craigyjp/A_Bit_More/README.md

## Based on the the original Crumar Bit series synthesizers I had created an RP2040 based DCO synthesizer. 

## Unfortunately the project did not work out too well as the DCO's were noisy and the PWM and triangle sounded atrocious.

## So a new synth is born with the same controller, new displays and the same filters, but now each RP2040 autotunes a pair of AS3340 VCO's

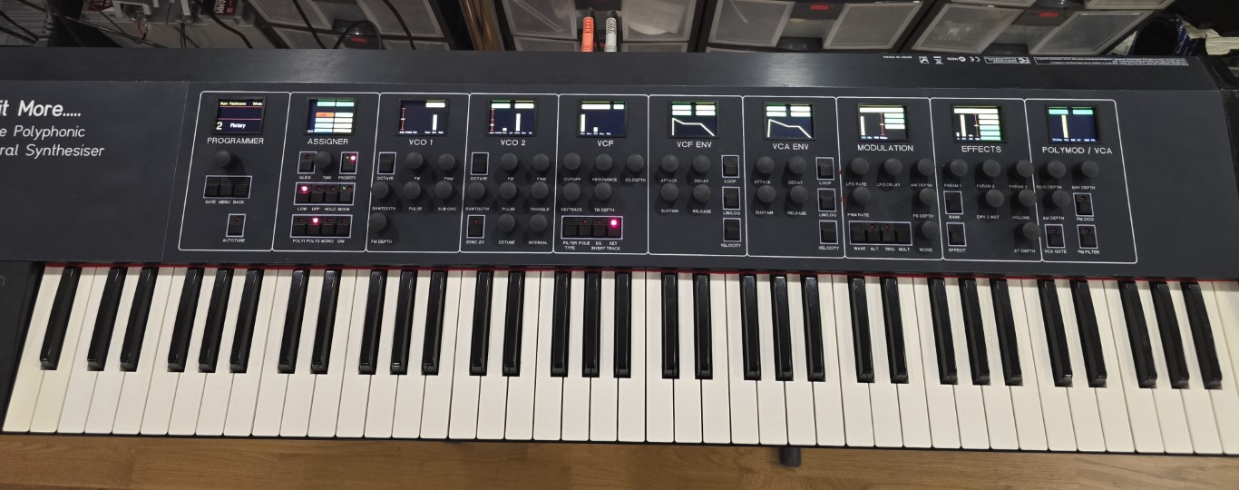
[picture p1: Photos/synth.jpg]
Synth


This is an 8 voice bi-timbral polyphonic dual VCO based synthesizer that uses an RP2040 to autotune and control a pair of AS3340 VCO chips.

I have also added portamento, octave switching, oscillator sync etc.

Filters are based on the Matrix 12 pole switching filters with 16 filter types available, dual LFO's are available for modulation and PWM, plus a white/pink noise source.

The case and keybed are a CME UF-70 Classic (black) and I've only kept the main MIDI board and grounded the pots/slider inputs.

# Although I have this repository the schematics are far from complete and some code is still required.

# Things to fix 

* Add chord hold in wholemode only.
* Add MIDI out/thru.
* Fix bug in lower unison/mono mode last note priority.
* Add sustain from pedal A (CC 64).
