craigyjp/A_Bit_More/Schematics/Programmer.pdf

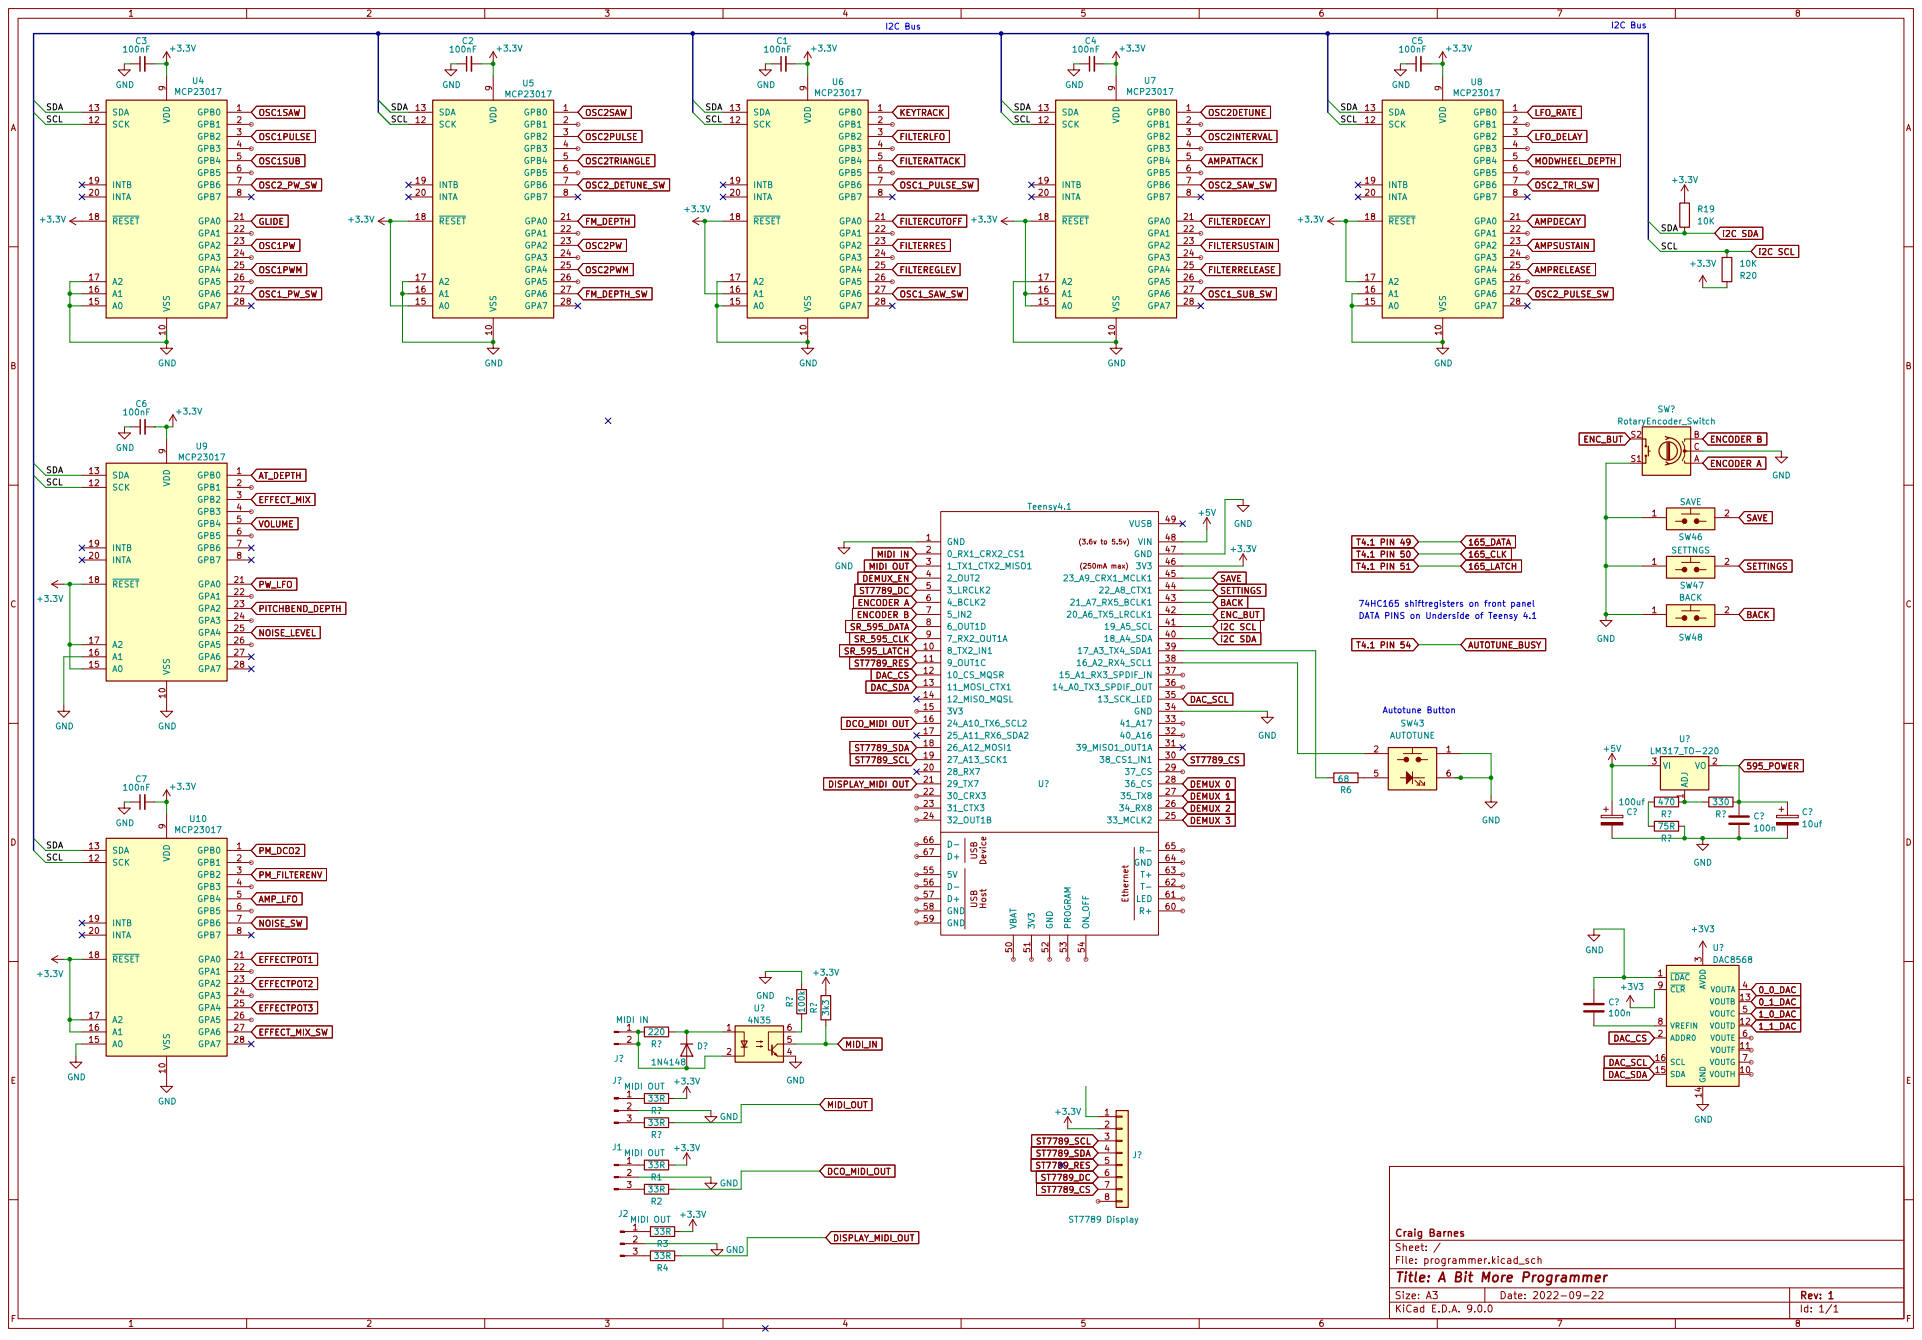
[picture p2: page 1]
