craigyjp/A_Bit_More/Schematics/Programmer4.pdf

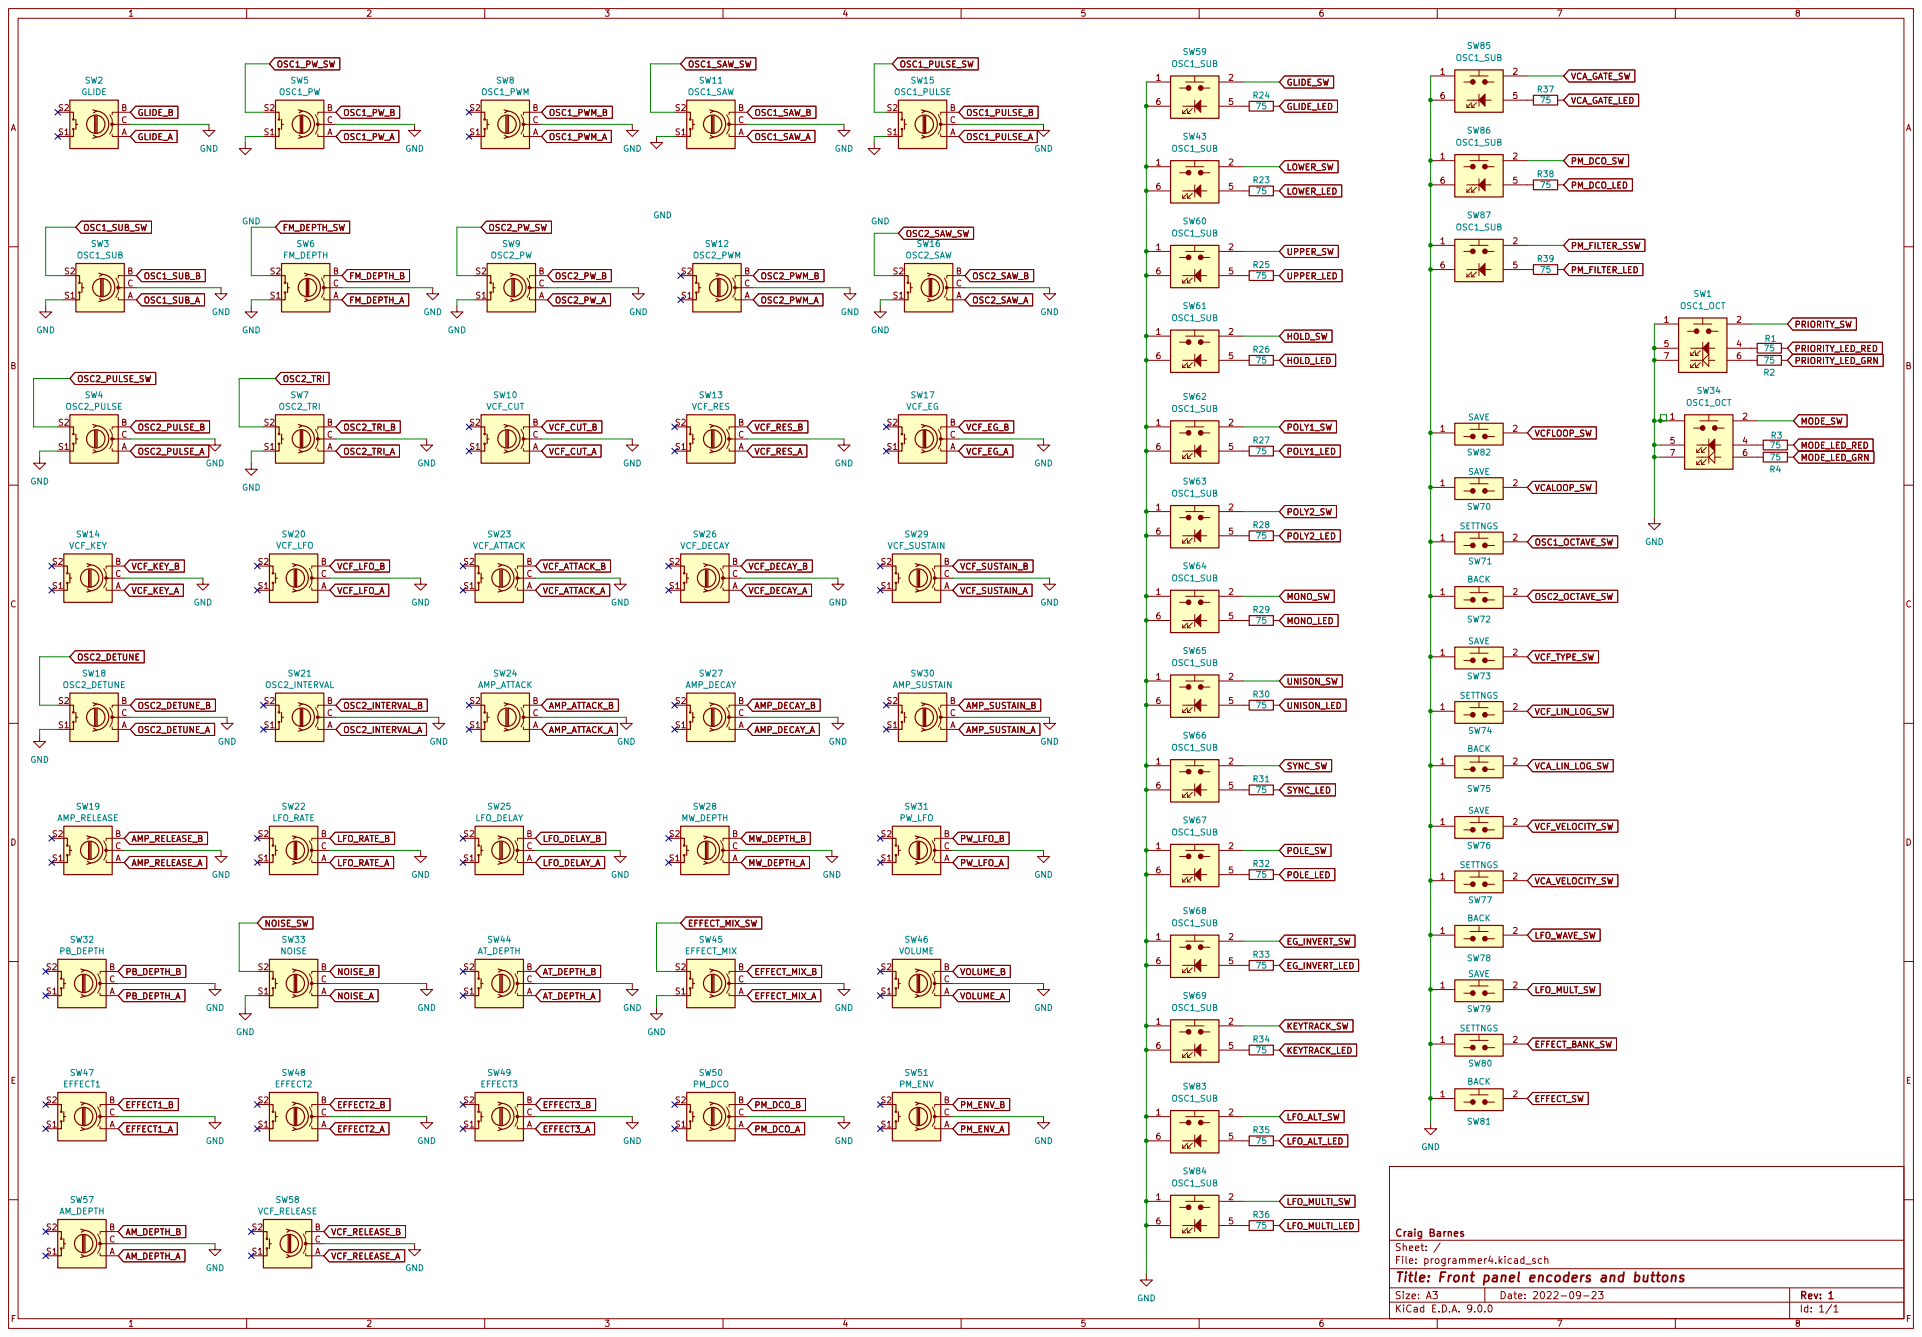
[picture p3: page 1]
