craigyjp/A_Bit_More/Schematics/AS3340_VCO.pdf

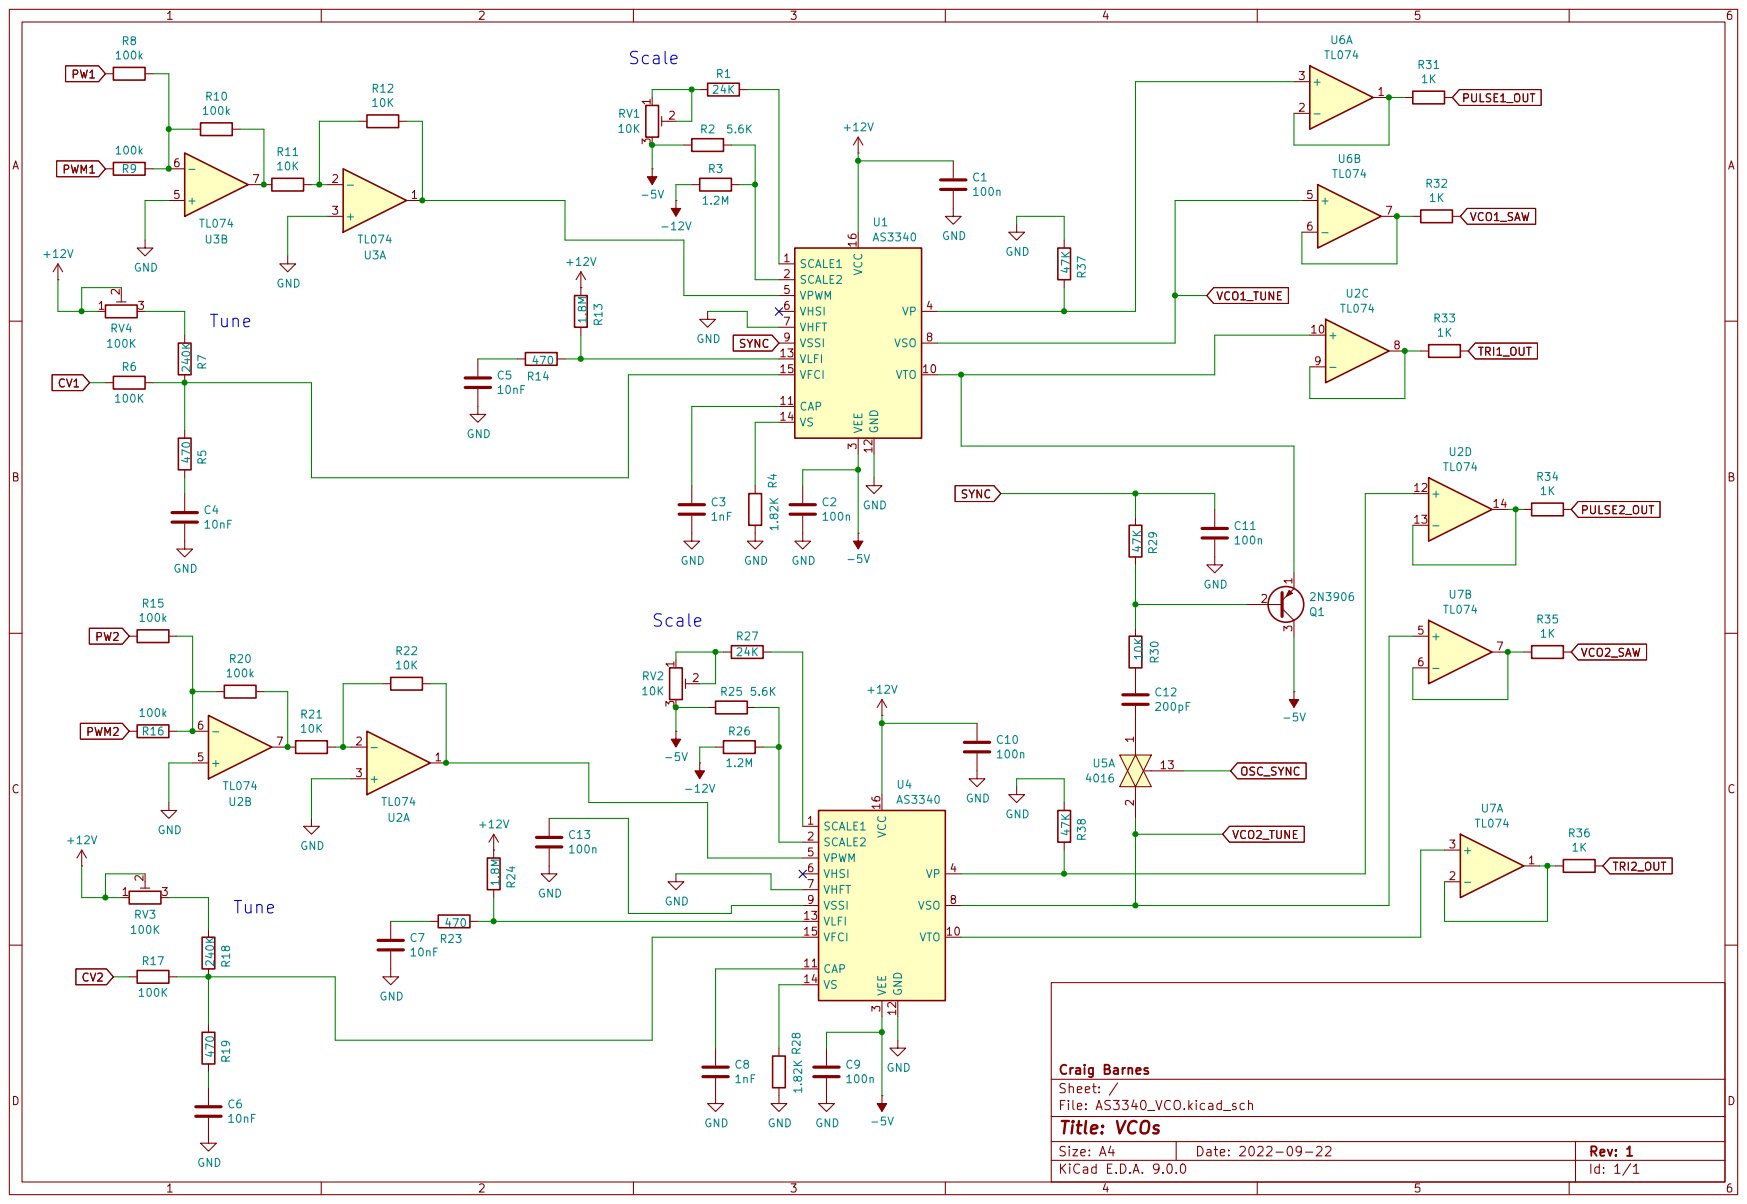
[picture p4: page 1]
