craigyjp/A_Bit_More/Schematics/Zero_VCO_control.pdf

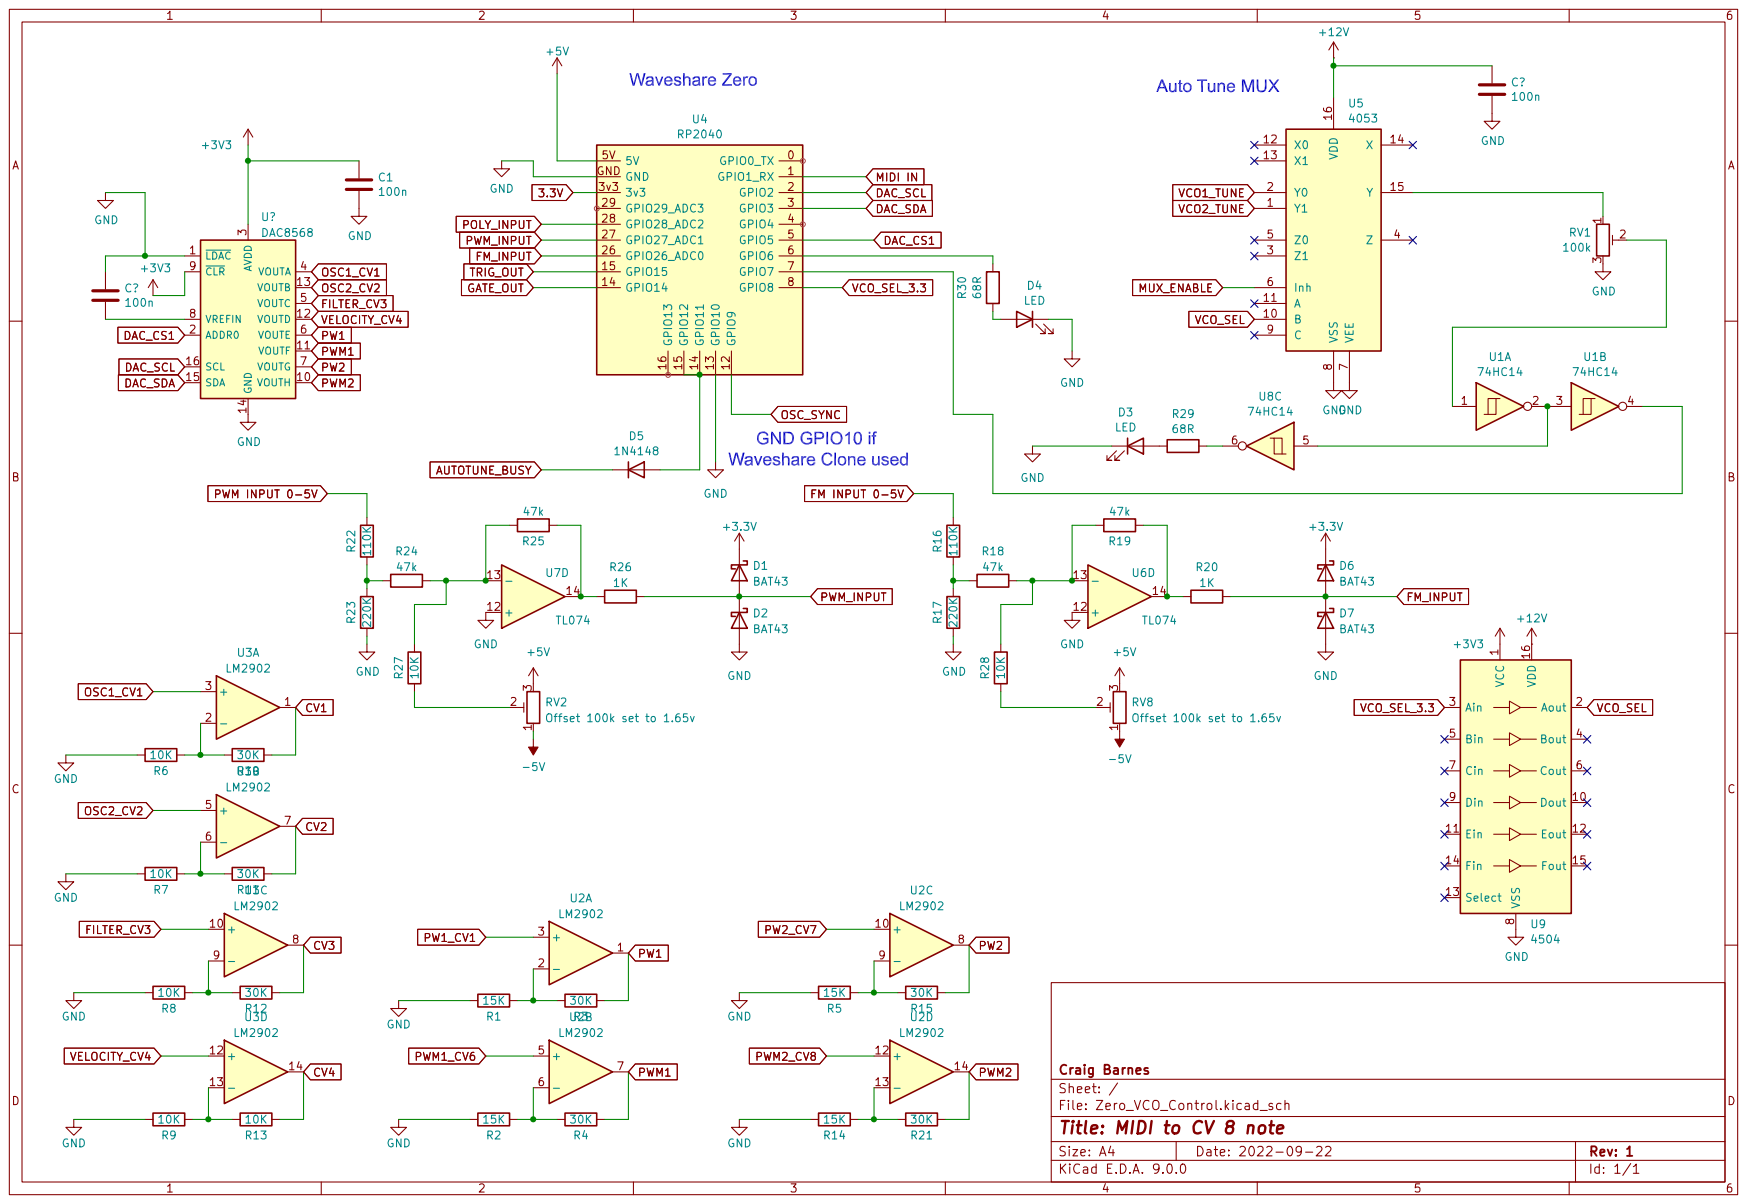
[picture p5: page 1]
