craigyjp/A_Bit_More/Schematics/Displays.pdf

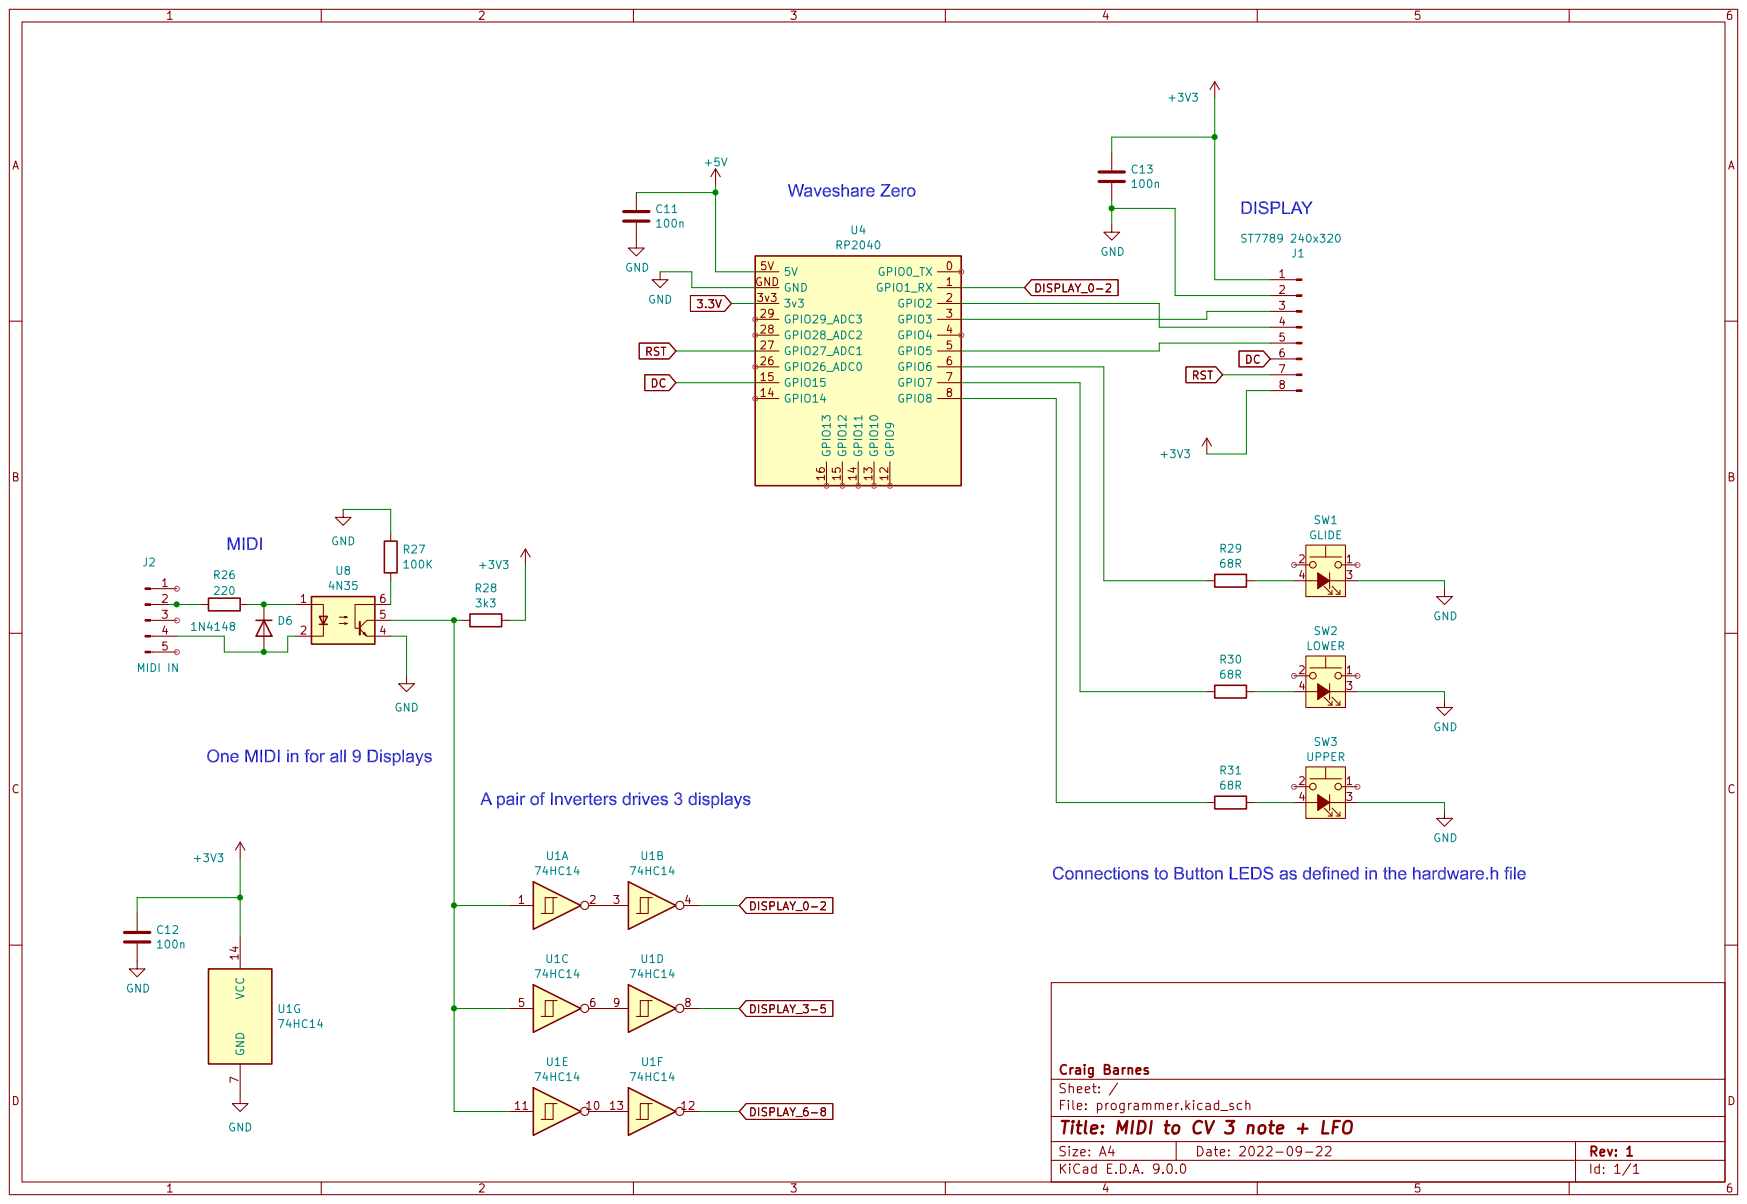
[picture p6: page 1]
