craigyjp/A_Bit_More/Schematics/Filter_control.pdf

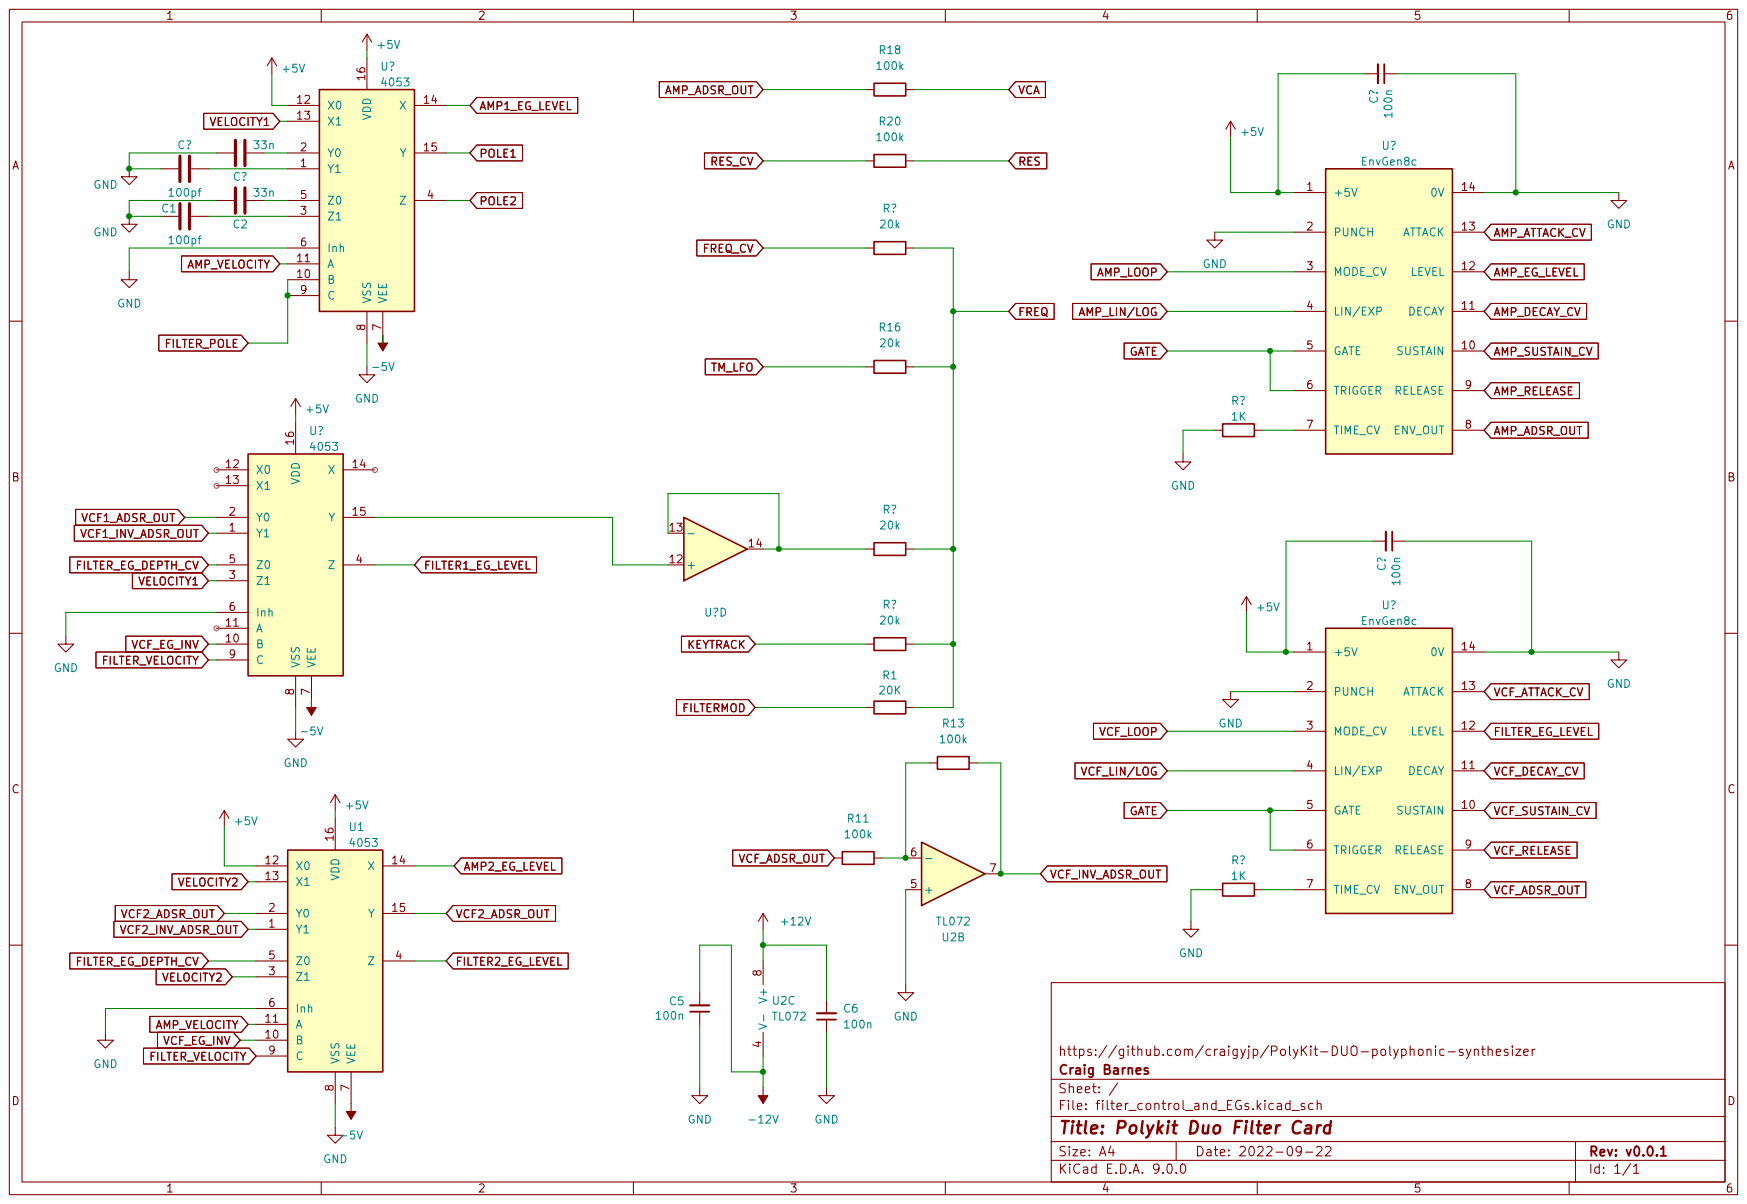
[picture p7: page 1]
