craigyjp/A_Bit_More/Schematics/Final_VCA_AM_Volume.pdf

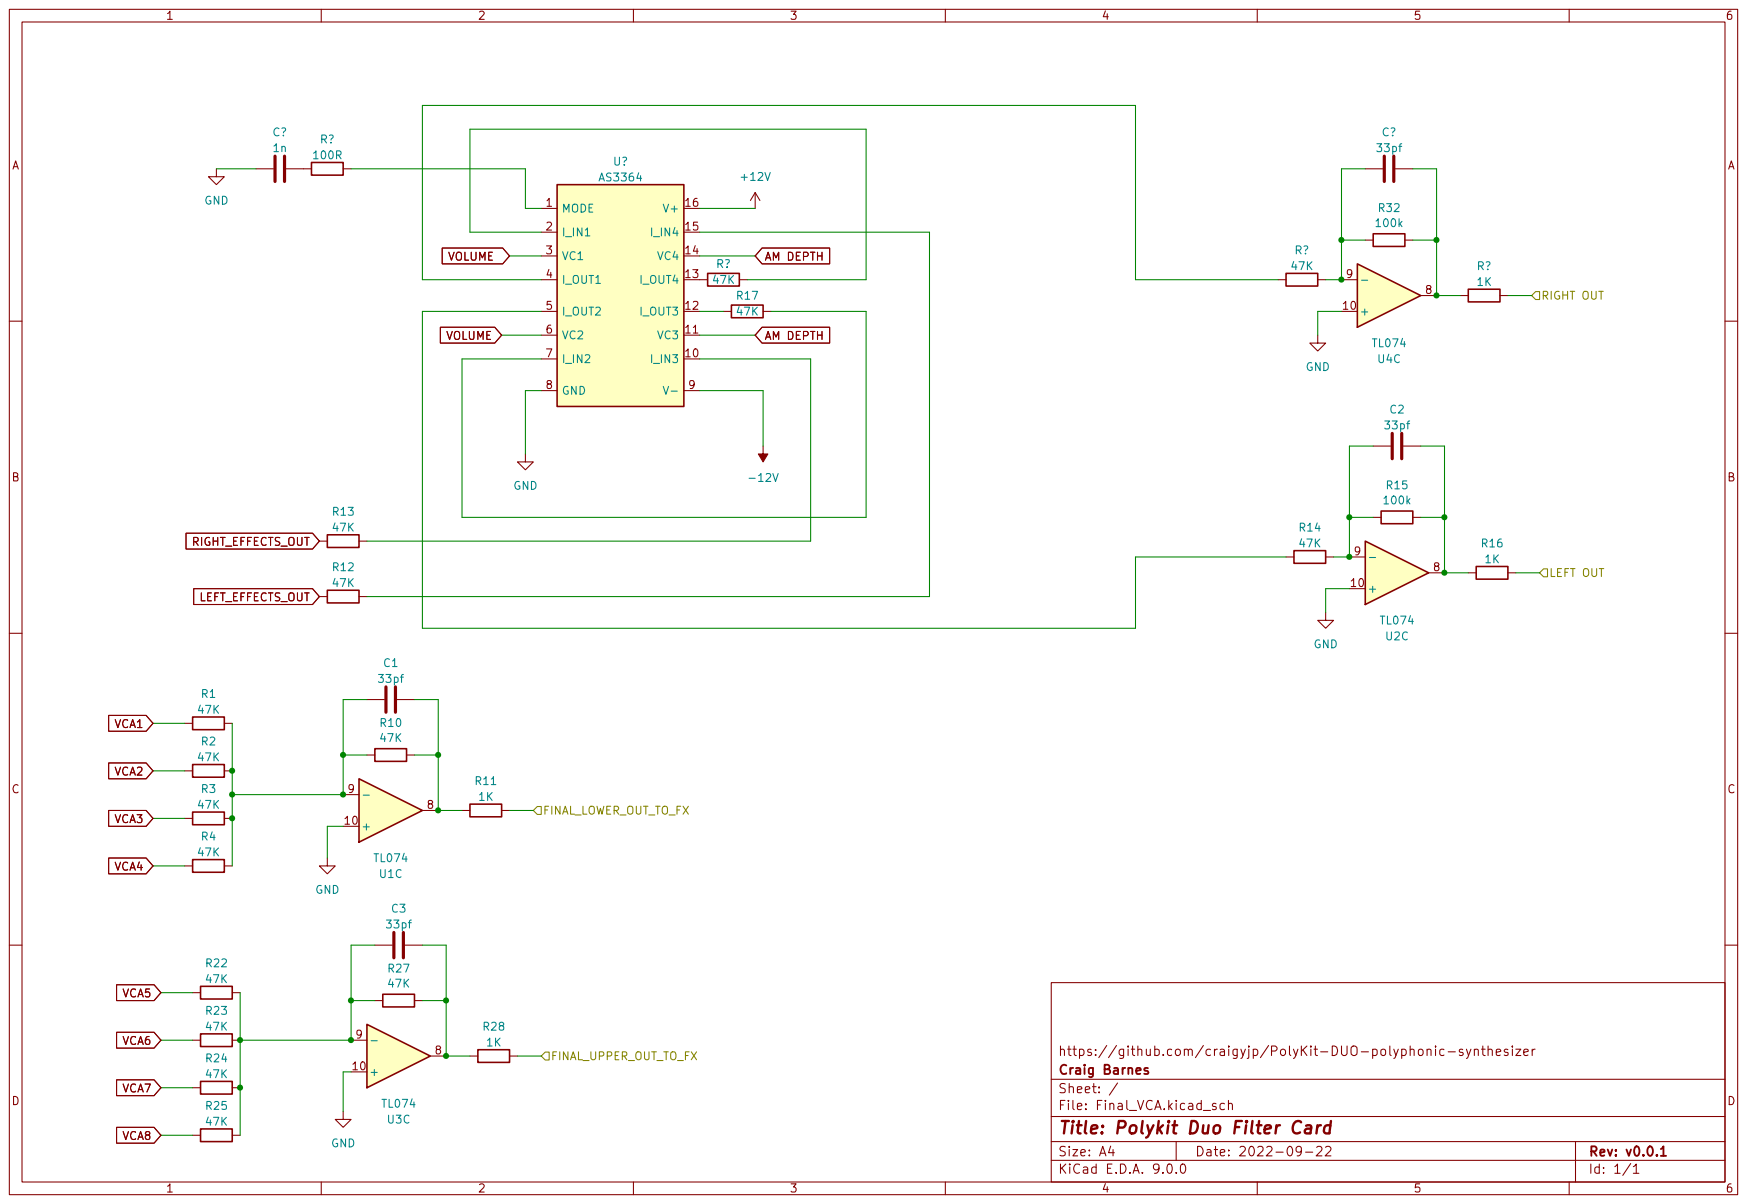
[picture p8: page 1]
