craigyjp/A_Bit_More/Schematics/Programmer2.pdf

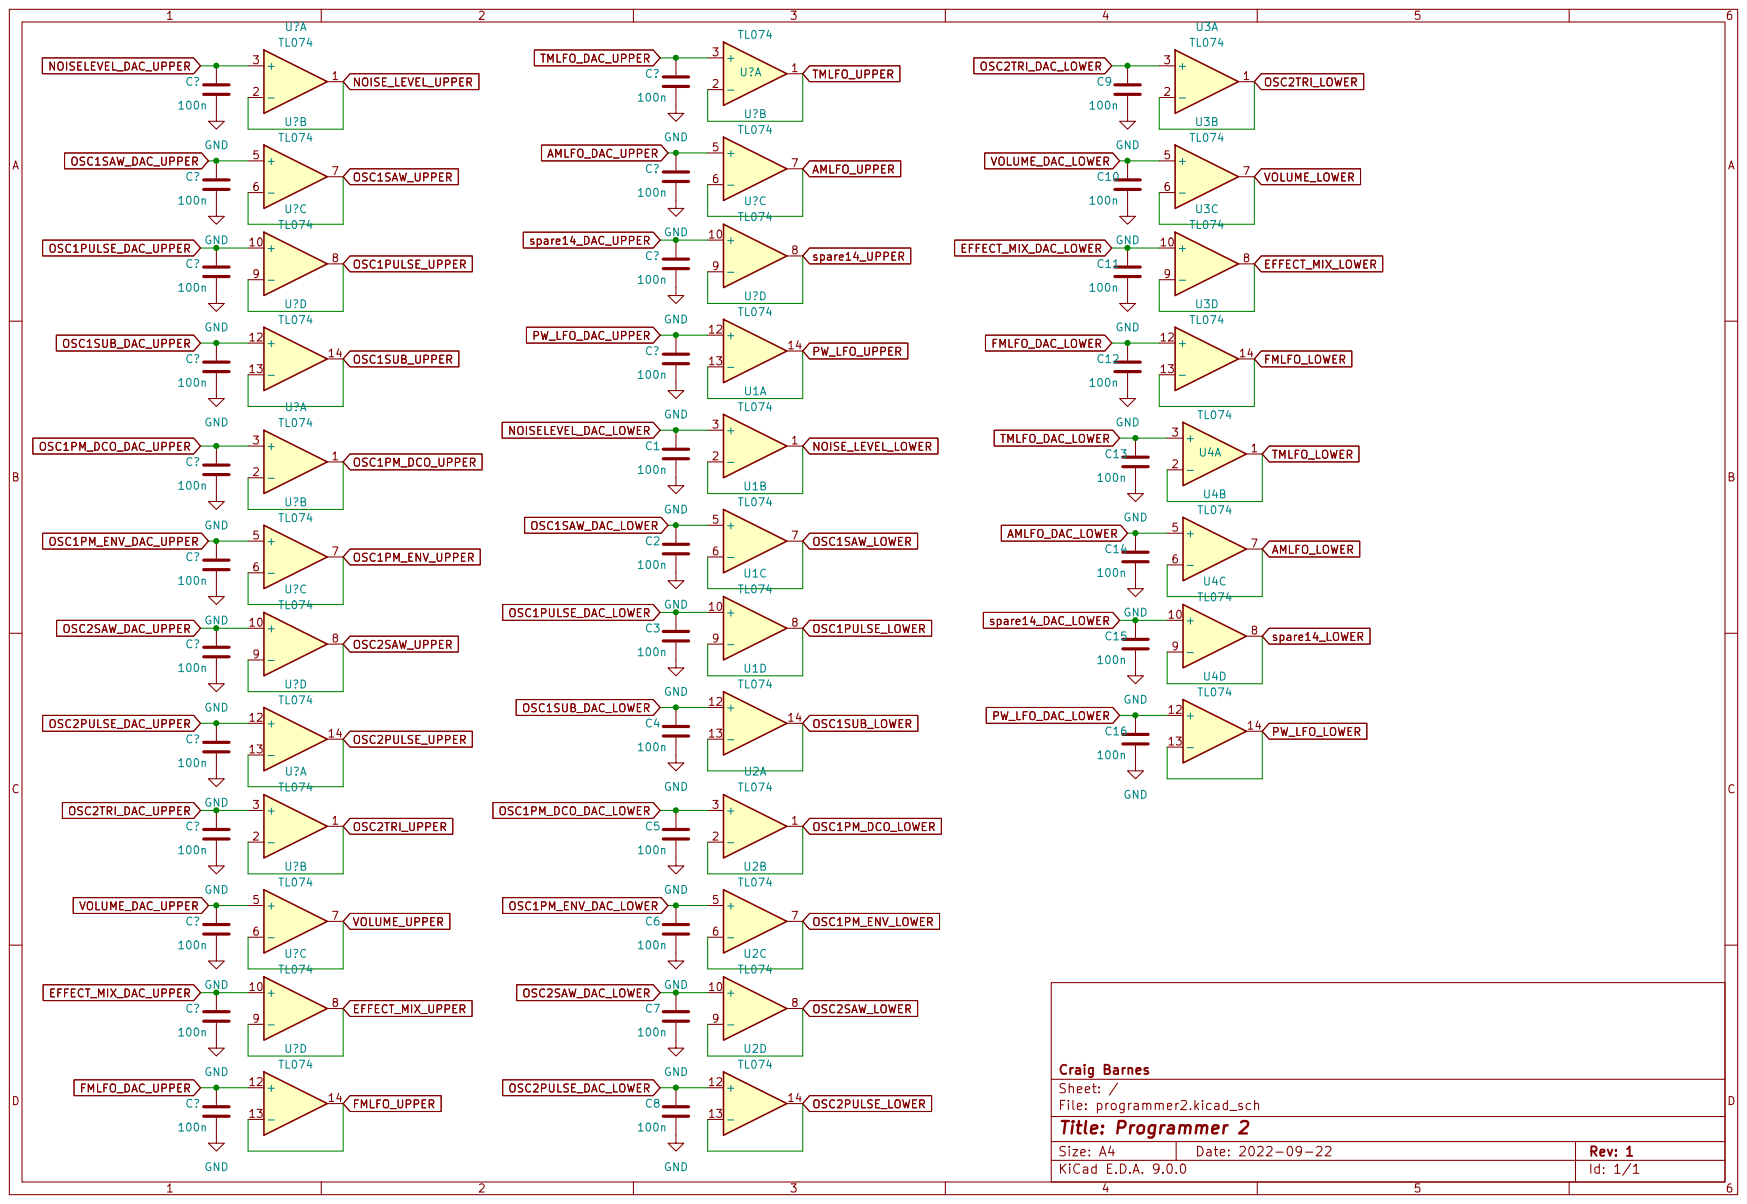
[picture p9: page 1]
