craigyjp/A_Bit_More/Schematics/Programmer3.pdf

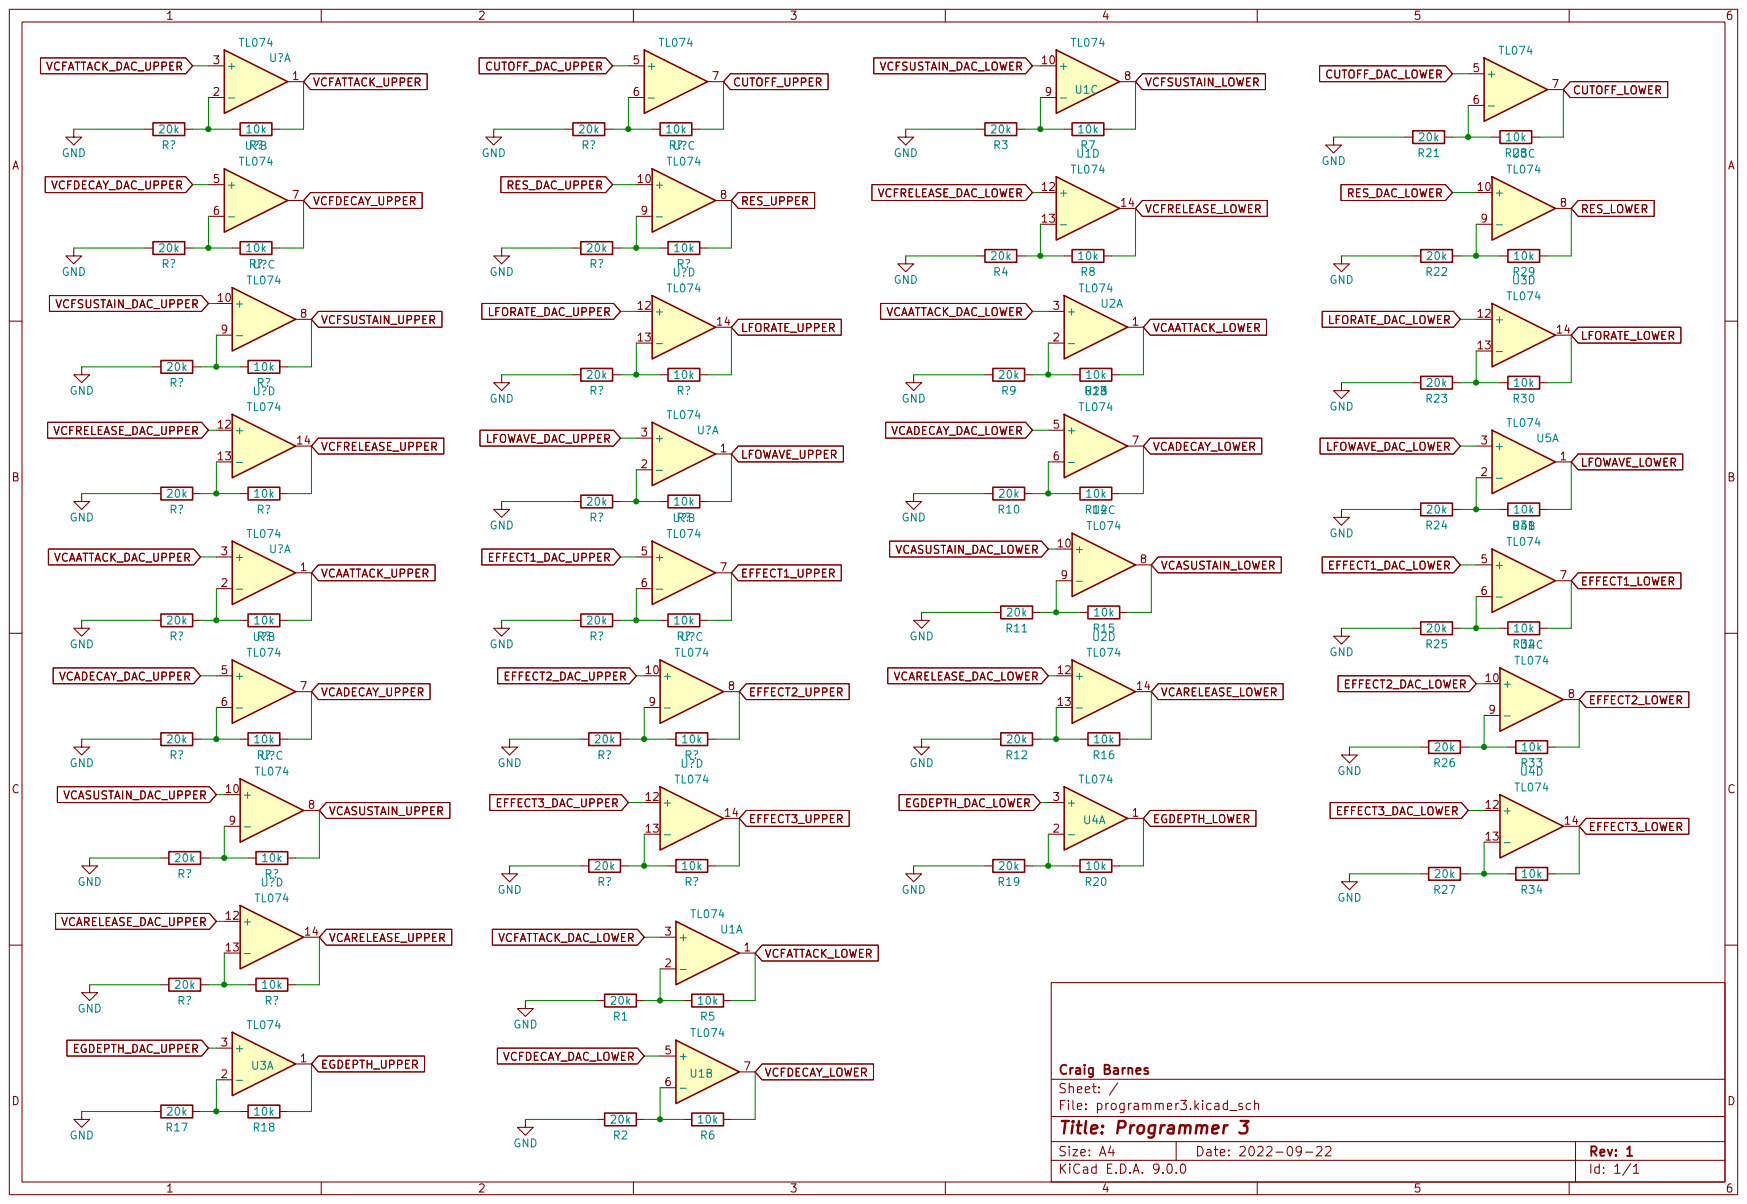
[picture p10: page 1]
