craigyjp/A_Bit_More/Schematics/Demux2_74HC595.pdf

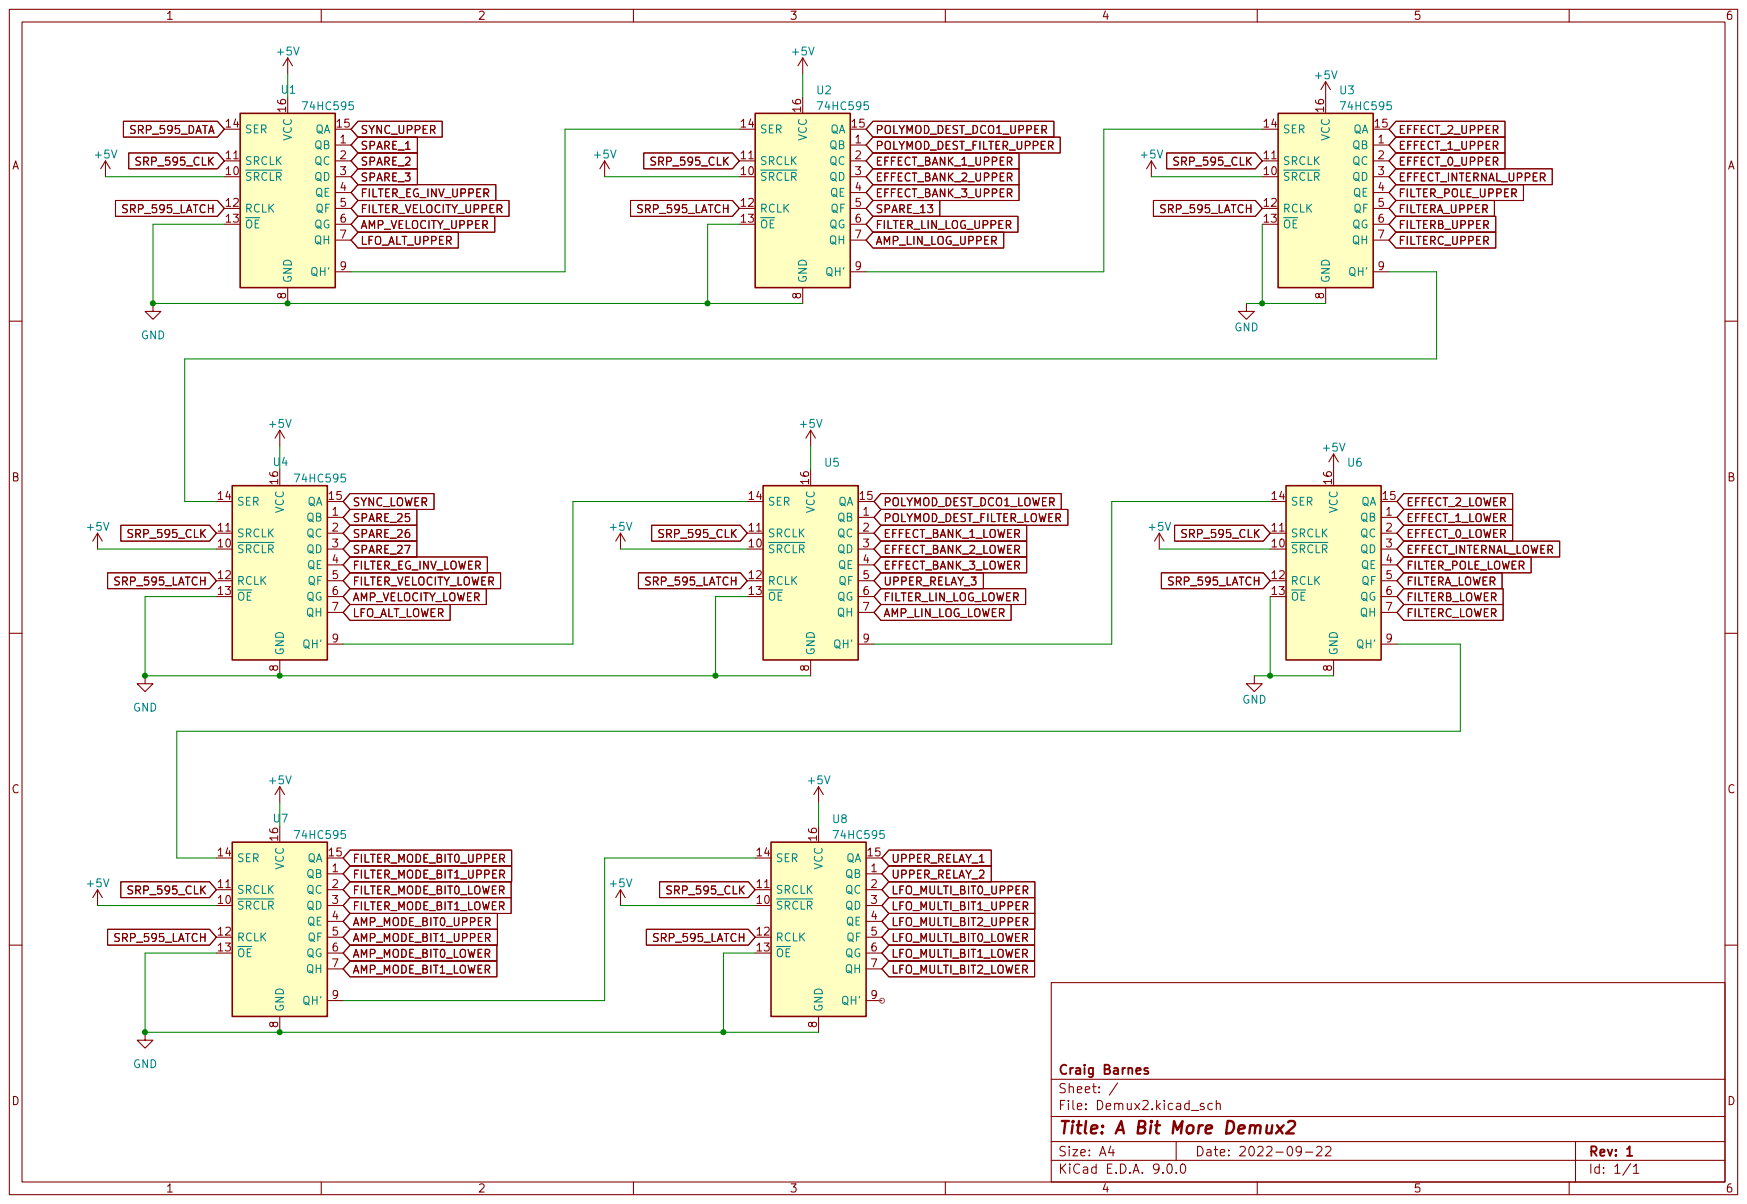
[picture p11: page 1]
