craigyjp/A_Bit_More/Schematics/Demux3_ladders.pdf

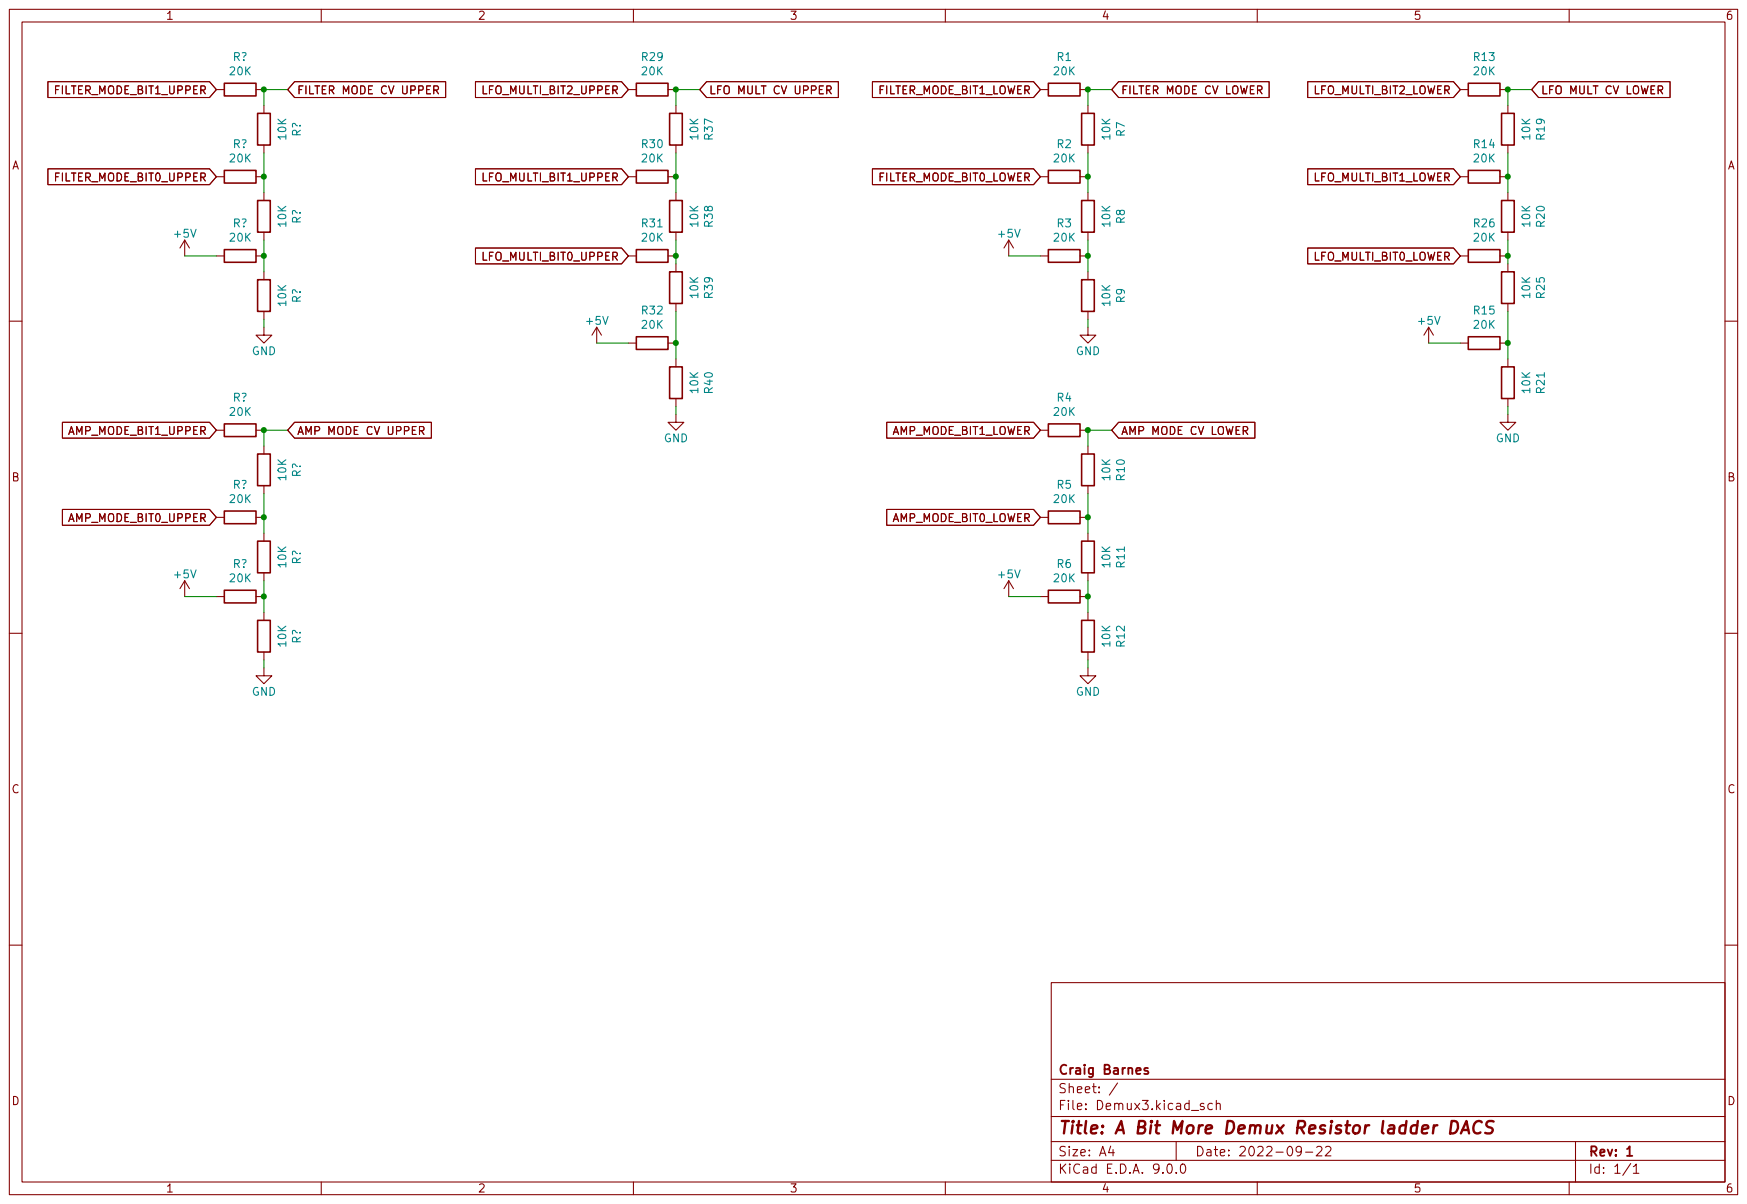
[picture p12: page 1]
