craigyjp/A_Bit_More/Schematics/Demux_74HC4067.pdf

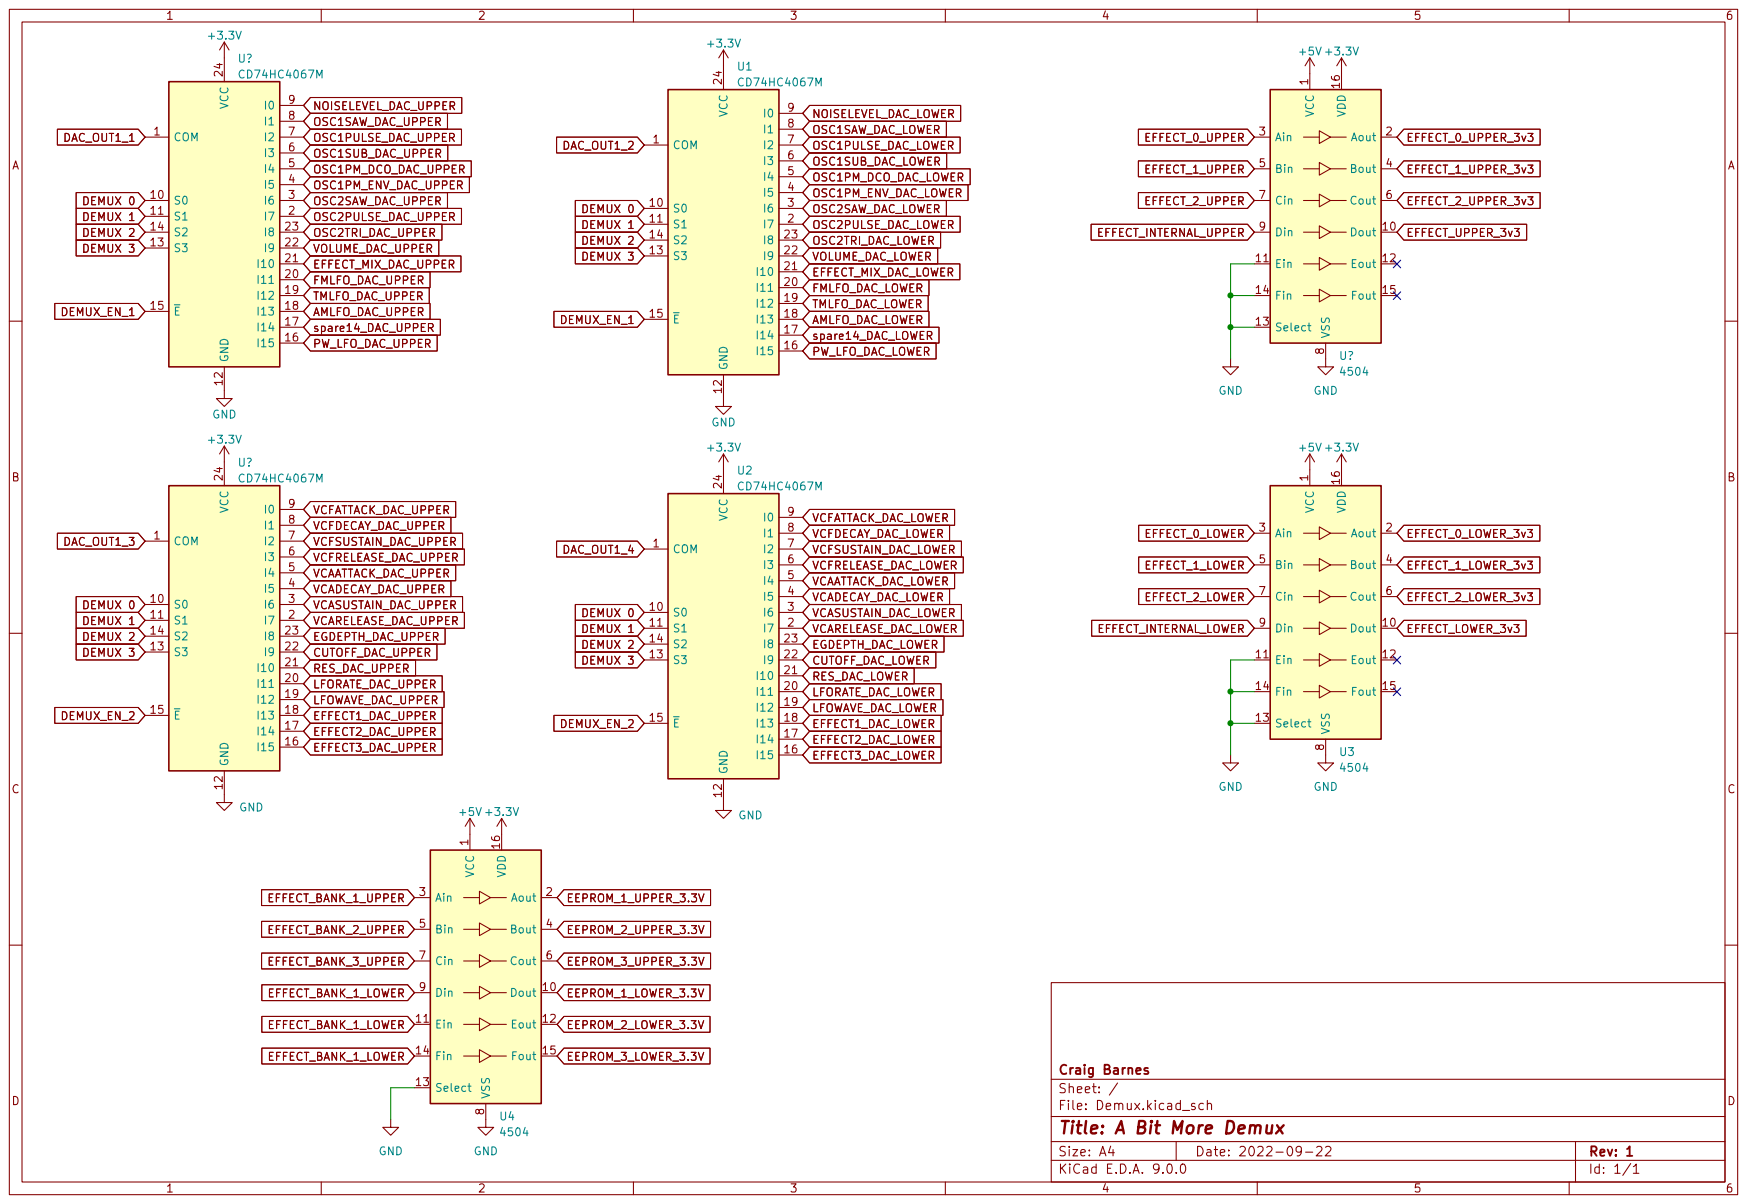
[picture p13: page 1]
