craigyjp/A_Bit_More/Schematics/Effects.pdf

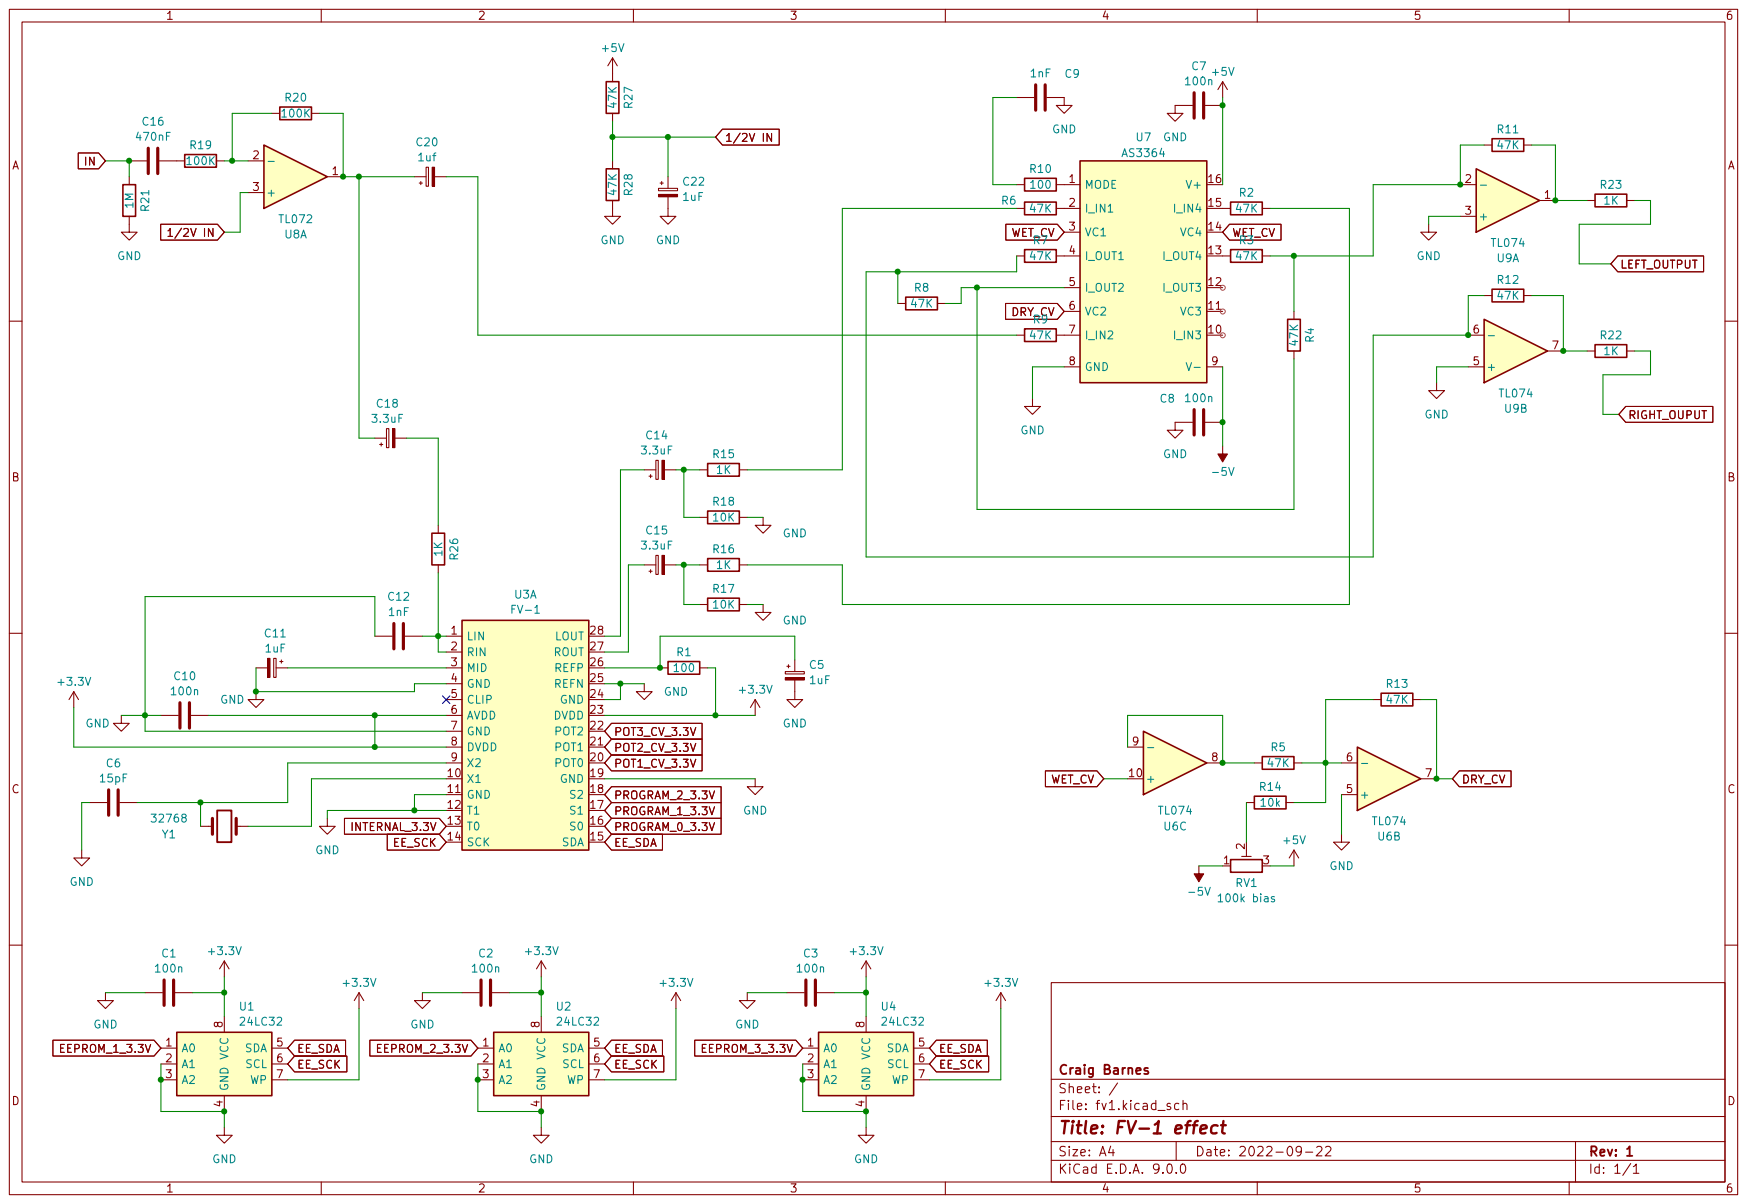
[picture p14: page 1]
