craigyjp/A_Bit_More/Schematics/Noise.pdf

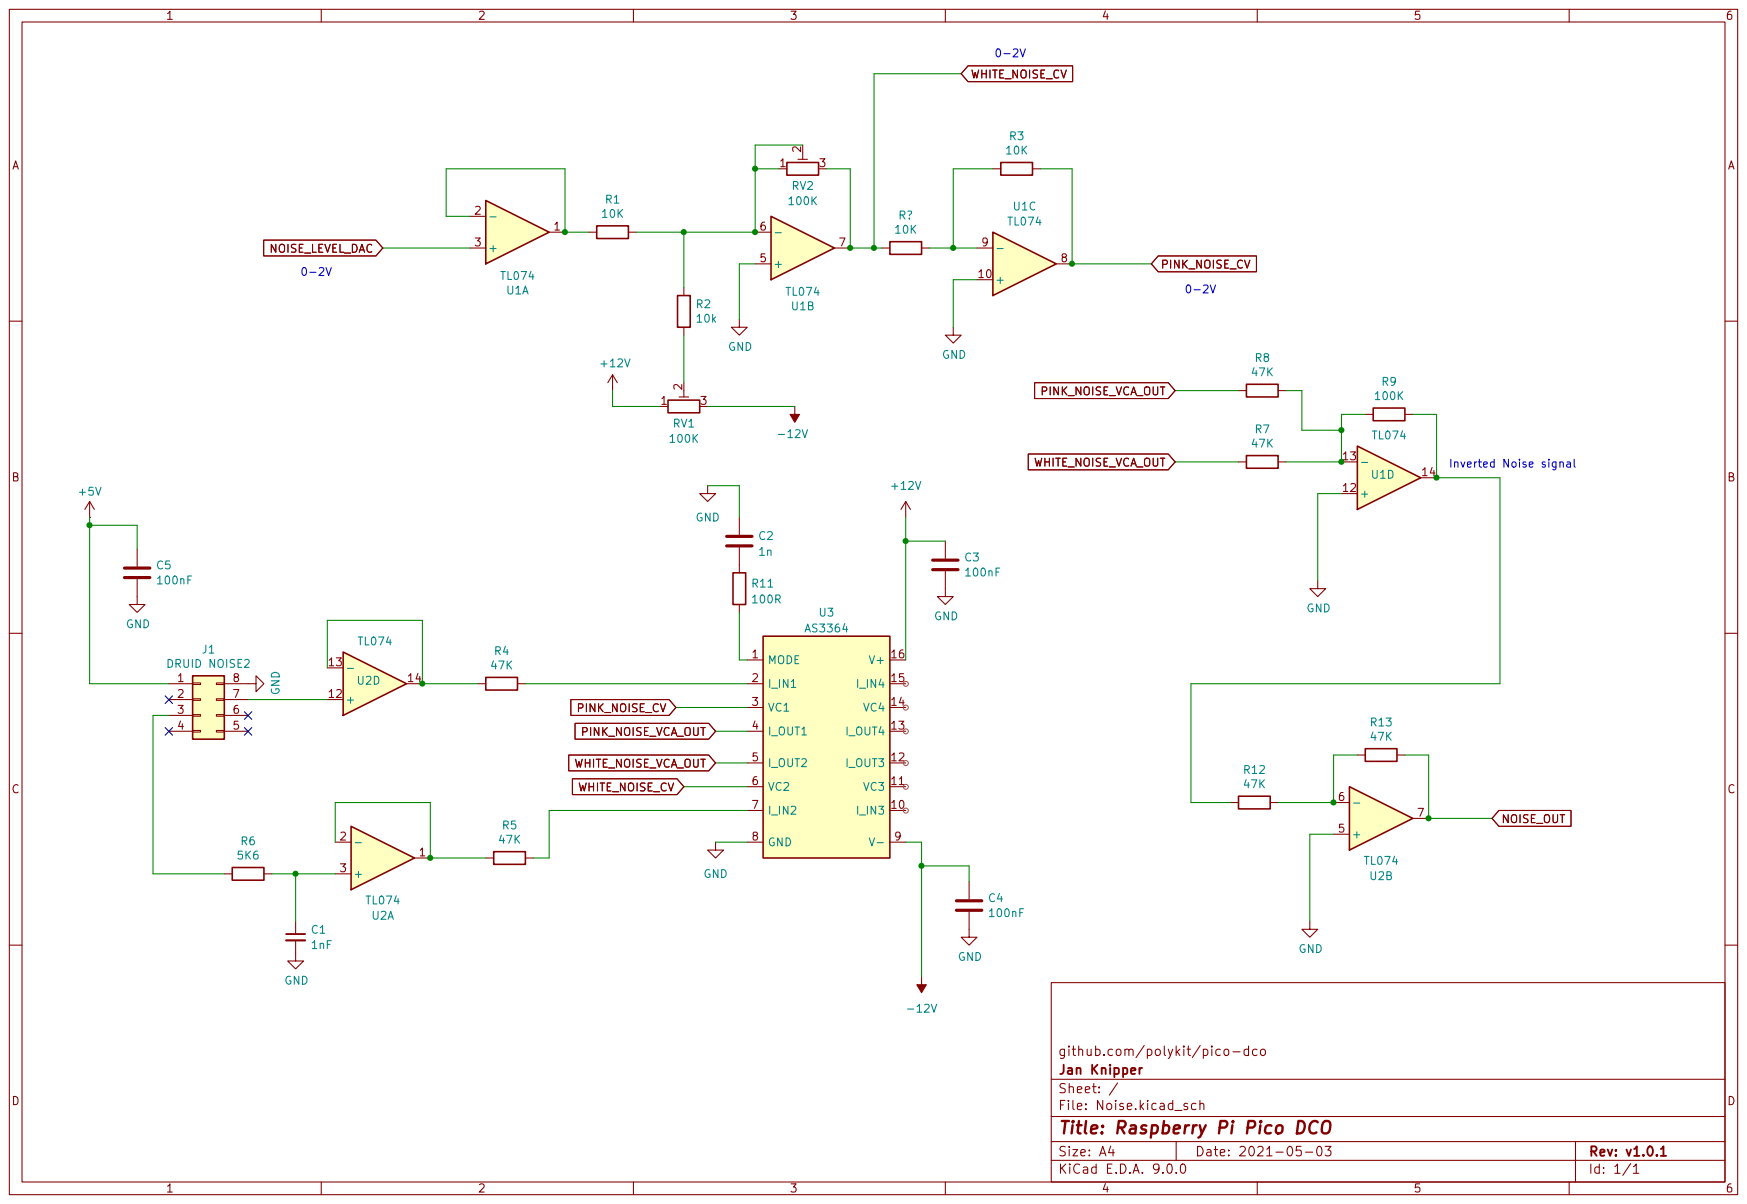
[picture p15: page 1]
