craigyjp/A_Bit_More/Schematics/AS3372E_filter.pdf

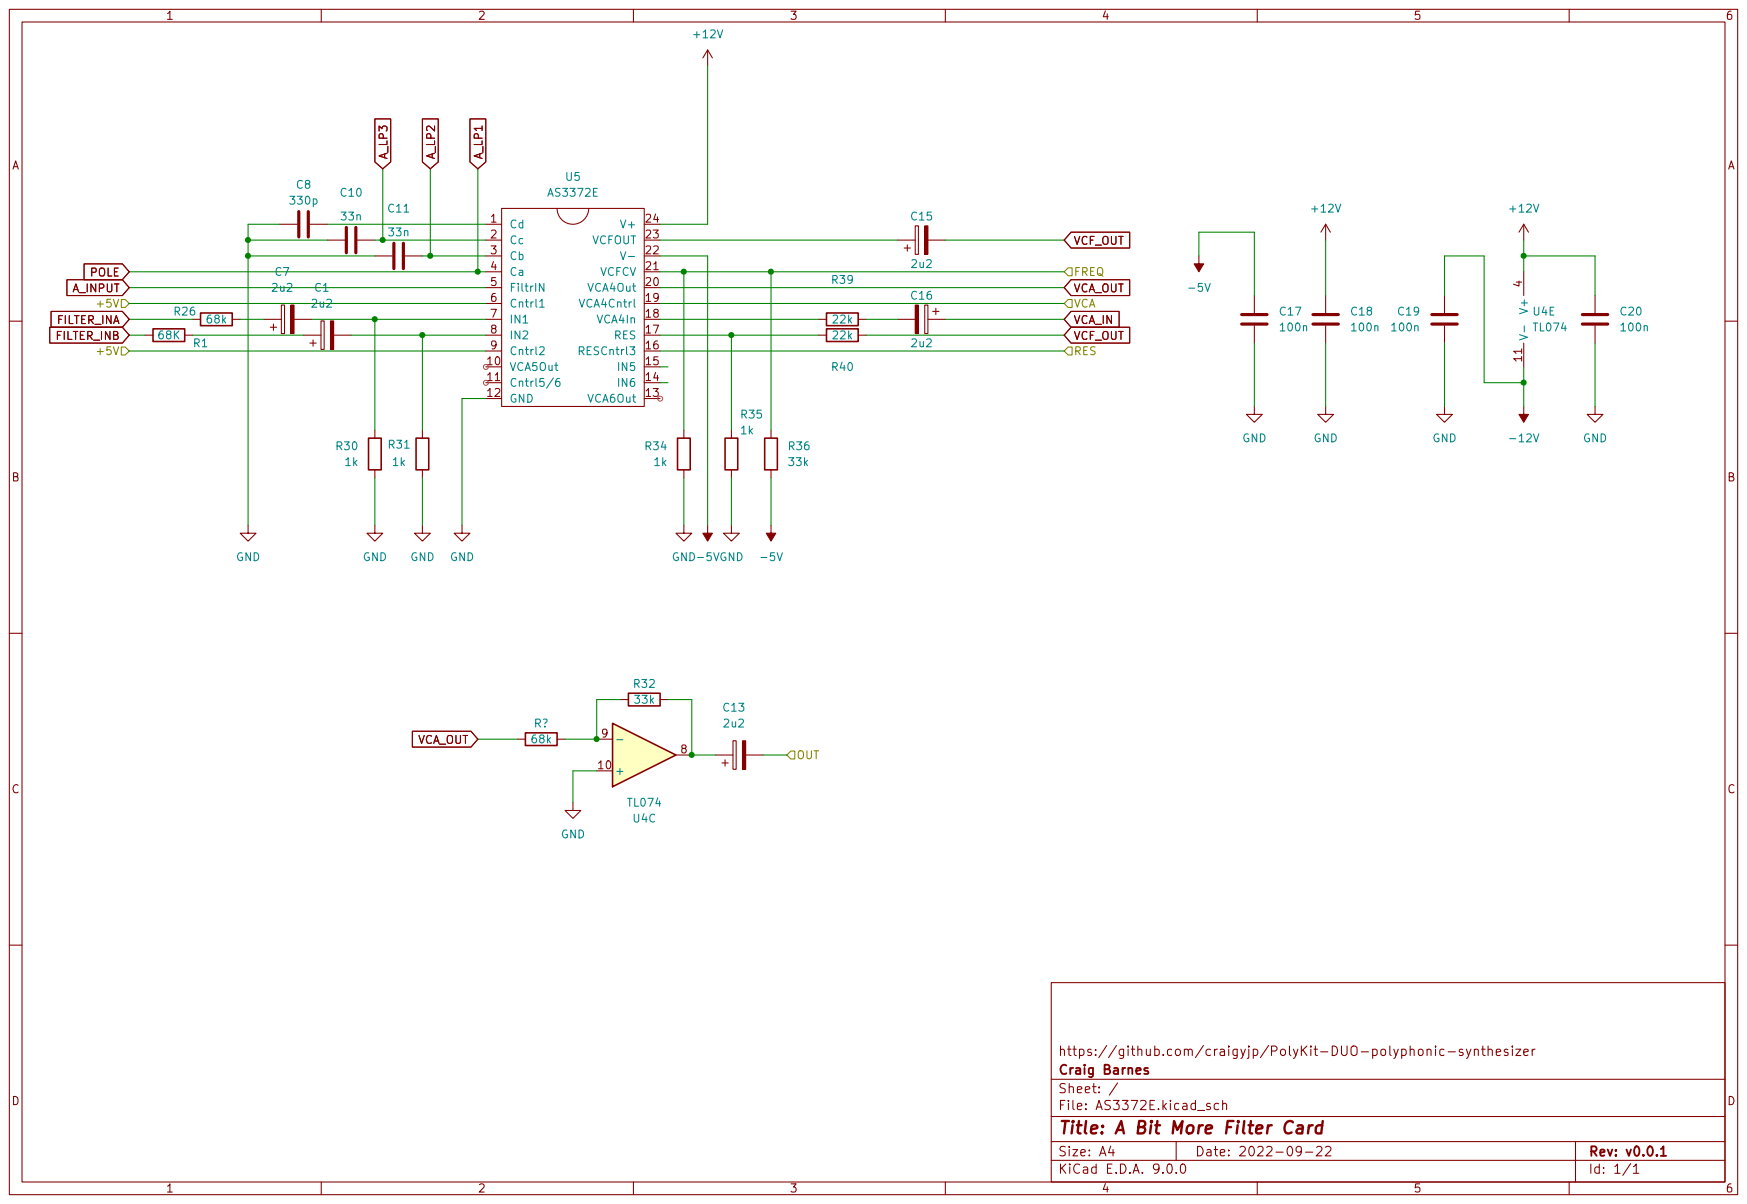
[picture p16: page 1]
