craigyjp/A_Bit_More/Schematics/LFOs.pdf

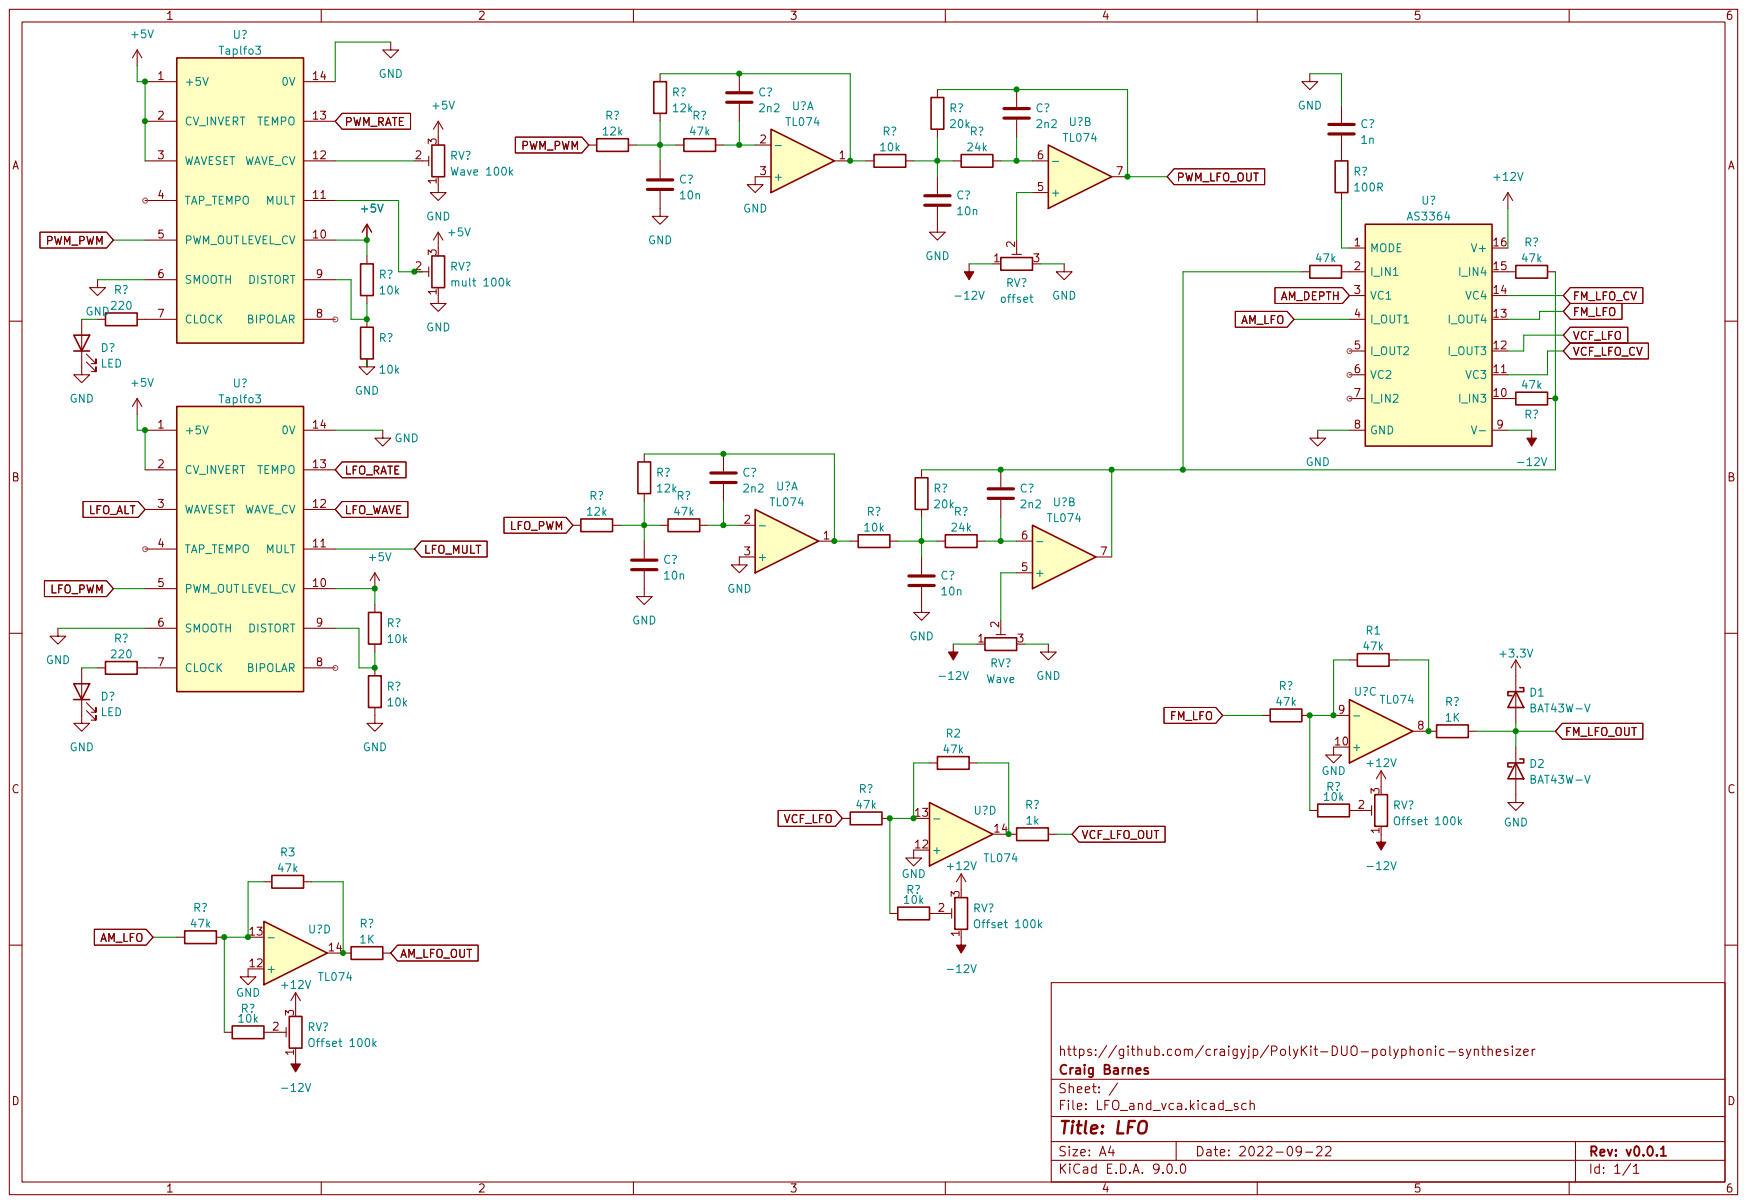
[picture p17: page 1]
