craigyjp/A_Bit_More/Schematics/Pole_mixer.pdf

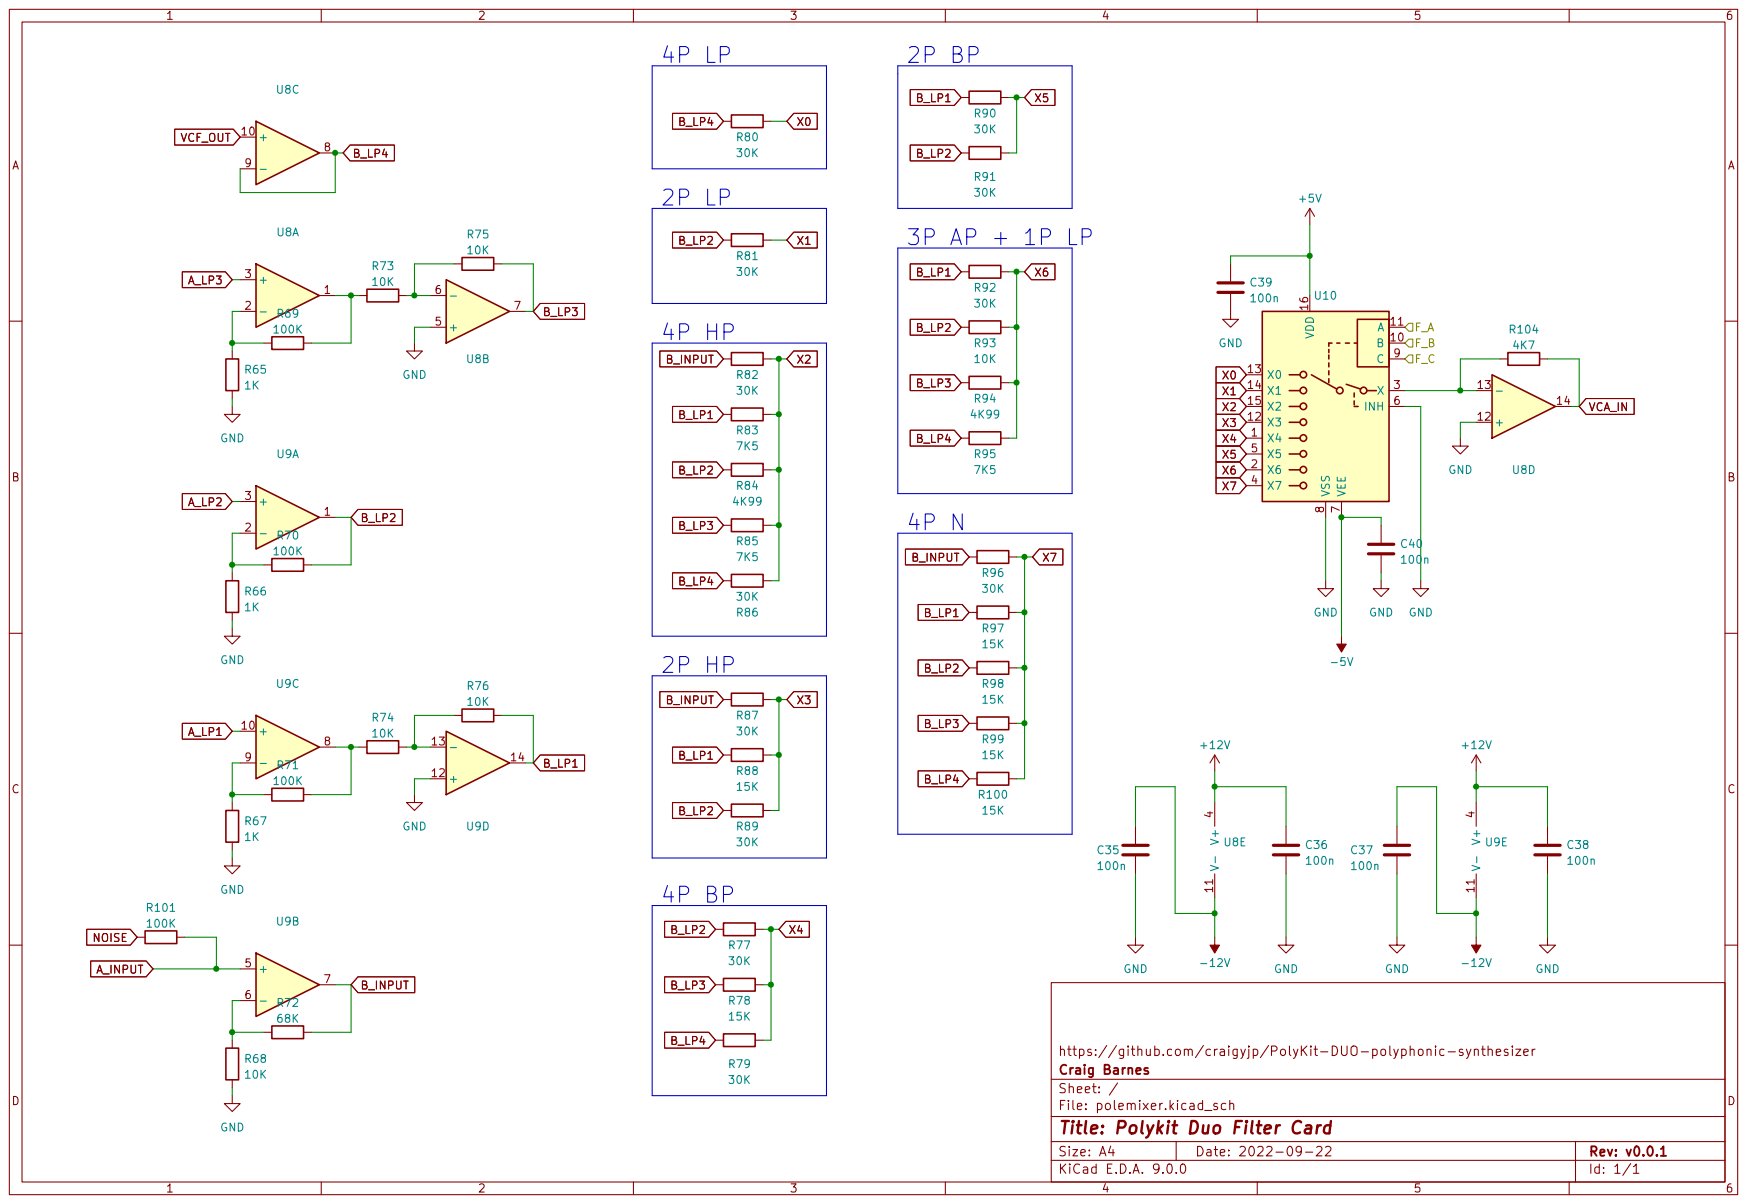
[picture p18: page 1]
