craigyjp/A_Bit_More/Schematics/Wave_Mixer_and_PM_section.pdf

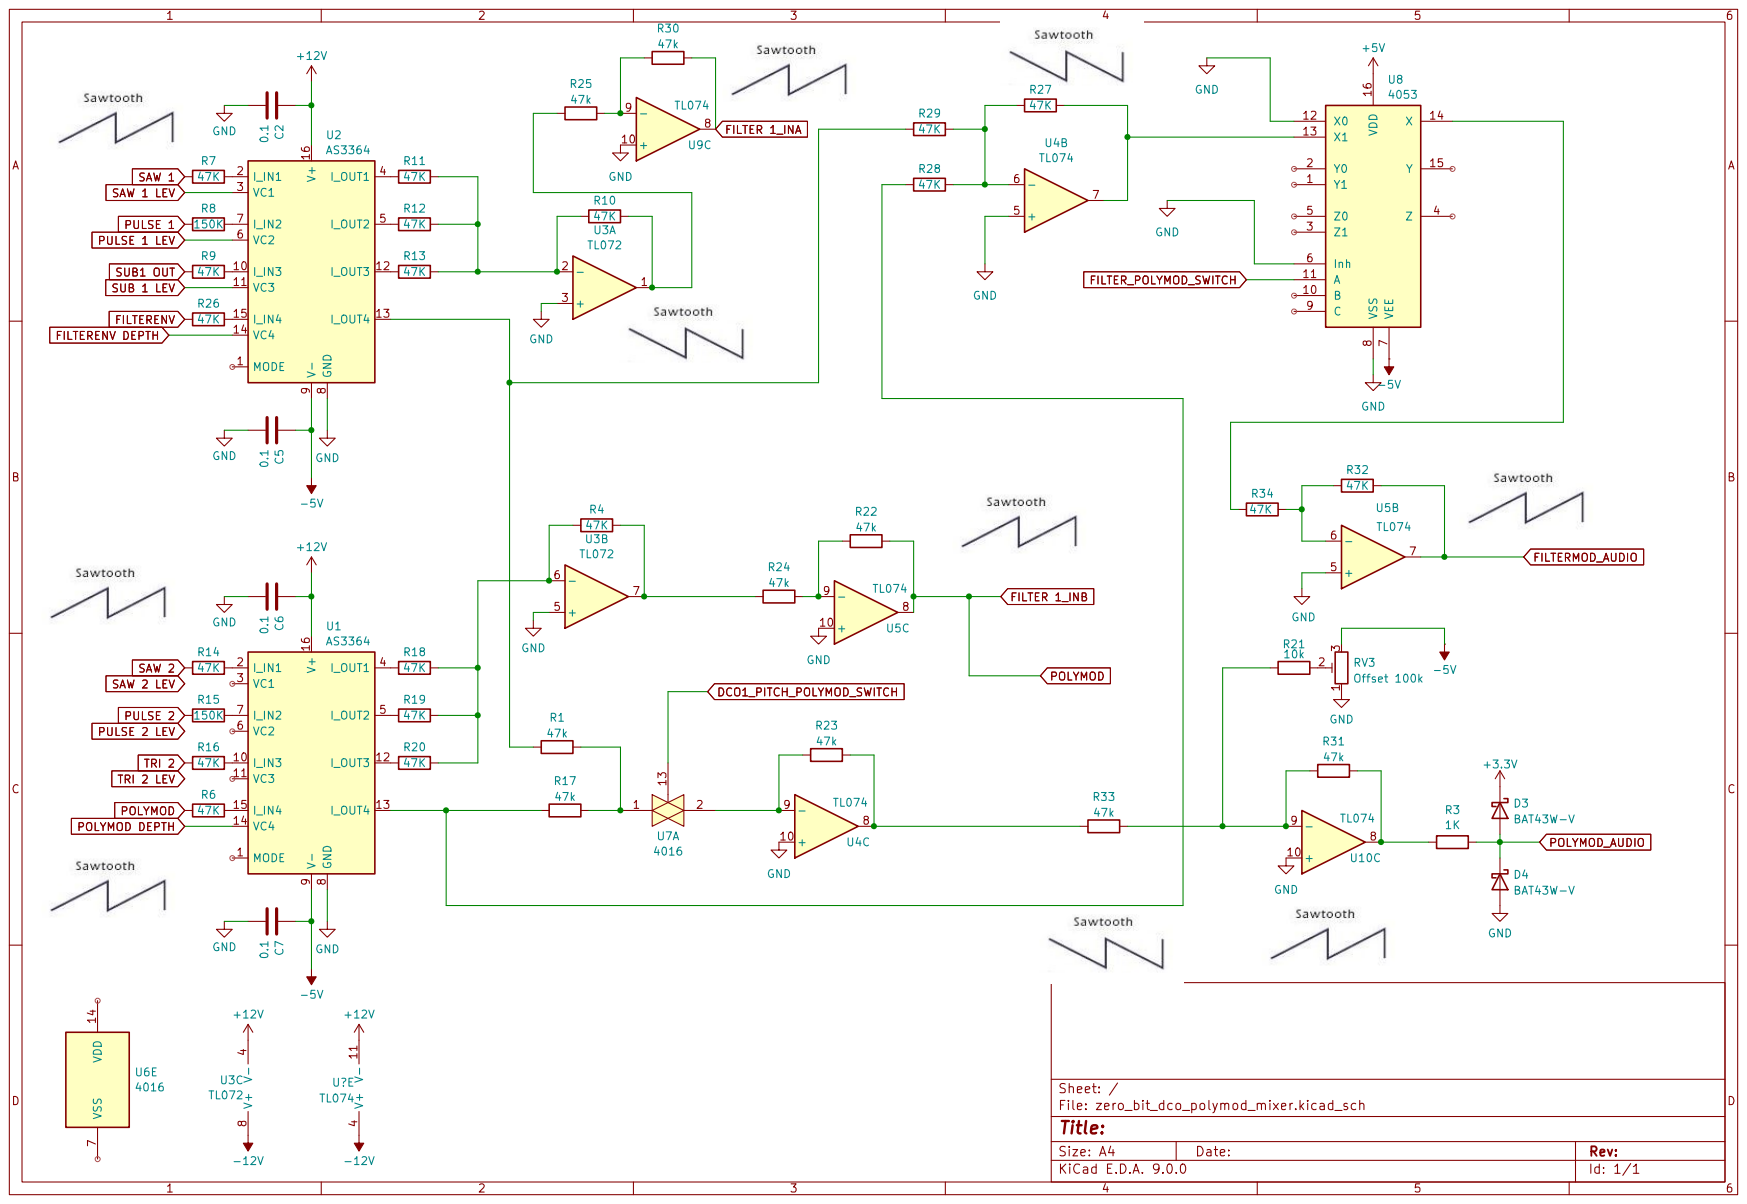
[picture p19: page 1]
