craigyjp/A_Bit_More/Synth/A_Bit_More.ino

#include <Arduino.h>
#include <Wire.h>
#include <SPI.h>
#include <SD.h>
#include <SerialFlash.h>
#include <MIDI.h>
#include <USBHost_t36.h>
#include "MidiCC.h"
#include "Constants.h"
#include "Parameters.h"
#include "PatchMgr.h"
#include "Button.h"
#include "HWControls.h"
#include "EepromMgr.h"
#include "Settings.h"
#include <RoxMux.h>
#include <map>  // Include the map library

std::map<int, int> voiceAssignment;

#define PARAMETER 0      //The main page for displaying the current patch and control (parameter) changes
#define RECALL 1         //Patches list
#define SAVE 2           //Save patch page
#define REINITIALISE 3   // Reinitialise message
#define PATCH 4          // Show current patch bypassing PARAMETER
#define PATCHNAMING 5    // Patch naming page
#define DELETE 6         //Delete patch page
#define DELETEMSG 7      //Delete patch message page
#define SETTINGS 8       //Settings page
#define SETTINGSVALUE 9  //Settings page
#define PERFORMANCE_RECALL 10
#define PERFORMANCE_SAVE 11
#define PERFORMANCE_EDIT 12
#define PERFORMANCE_NAMING 13
#define PERFORMANCE_DELETE 14
#define PERFORMANCE_DELETEMSG 15

unsigned int state = PARAMETER;

uint32_t int_ref_on_flexible_mode = 0b00001001000010100000000000000000;  // { 0000 , 1001 , 0000 , 1010000000000000 , 0000 }

uint32_t sample_data1 = 0b00000000000000000000000000000000;
uint32_t sample_data2 = 0b00000000000000000000000000000000;
uint32_t sample_data3 = 0b00000000000000000000000000000000;
uint32_t sample_data4 = 0b00000000000000000000000000000000;
uint32_t channel_a = 0b00000010000000000000000000000000;
uint32_t channel_b = 0b00000010000100000000000000000000;
uint32_t channel_c = 0b00000010001000000000000000000000;
uint32_t channel_d = 0b00000010001100000000000000000000;
uint32_t channel_e = 0b00000010010000000000000000000000;
uint32_t channel_f = 0b00000010010100000000000000000000;
uint32_t channel_g = 0b00000010011000000000000000000000;
uint32_t channel_h = 0b00000010011100000000000000000000;

enum PlayMode {
  WHOLE = 0,
  DUAL = 1,
  SPLIT = 2
};

struct Performance {
  int performanceNo;
  int upperPatchNo;
  int lowerPatchNo;
  String name;
  PlayMode mode;  // ← Back to enum type!
};

#include "ST7735Display.h"

boolean cardStatus = false;

struct VoiceAndNote {
  int note;
  int velocity;
  unsigned long timeOn;
  bool sustained;  // Sustain flag
  bool keyDown;
  double noteFreq;  // Note frequency
  int position;
  bool noteOn;
};

struct VoiceAndNote voices[NO_OF_VOICES] = {
  { -1, -1, 0, false, false, 0, -1, false },
  { -1, -1, 0, false, false, 0, -1, false },
  { -1, -1, 0, false, false, 0, -1, false },
  { -1, -1, 0, false, false, 0, -1, false },
  { -1, -1, 0, false, false, 0, -1, false },
  { -1, -1, 0, false, false, 0, -1, false },
  { -1, -1, 0, false, false, 0, -1, false },
  { -1, -1, 0, false, false, 0, -1, false }
};

// Tracks exactly which note each voice currently plays
int voiceToNoteLower[4] = { -1, -1, -1, -1 };
int voiceToNoteUpper[4] = { -1, -1, -1, -1 };


boolean voiceOn[NO_OF_VOICES] = { false, false, false, false, false, false, false, false };
int prevNote = 0;  //Initialised to middle value
bool notes[128] = { 0 }, initial_loop = 1;
int8_t noteOrder[40] = { 0 }, orderIndx = { 0 };

bool notesWhole[128], notesLower[128], notesUpper[128];
byte noteOrderWhole[40], noteOrderLower[40], noteOrderUpper[40];
int orderIndxWhole = 0, orderIndxLower = 0, orderIndxUpper = 0;

int voiceAssignmentLower[128];
int voiceAssignmentUpper[128];

CircularBuffer<Performance, PERFORMANCES_LIMIT> performances;
Performance currentPerformance;


//USB HOST MIDI Class Compliant
USBHost myusb;
USBHub hub1(myusb);
USBHub hub2(myusb);
MIDIDevice midi1(myusb);


//MIDI 5 Pin DIN
MIDI_CREATE_INSTANCE(HardwareSerial, Serial1, MIDI);   // main MIDI in and out
MIDI_CREATE_INSTANCE(HardwareSerial, Serial6, MIDI6);  // MIDI out to voices
MIDI_CREATE_INSTANCE(HardwareSerial, Serial7, MIDI7);  // MIDI out to display (not connected)

#define SRP_TOTAL 8
Rox74HC595<SRP_TOTAL> srp;

// pins for 74HC595
#define LED_DATA 6   // pin 14 on 74HC595 (DATA)
#define LED_CLK 7    // pin 11 on 74HC595 (CLK)
#define LED_LATCH 8  // pin 12 on 74HC595 (LATCH)
#define LED_PWM -1   // pin 13 on 74HC595

#define OCTO_TOTAL 4
#define BTN_DEBOUNCE 50
RoxOctoswitch<OCTO_TOTAL, BTN_DEBOUNCE> octoswitch;

// pins for 74HC165
#define PIN_DATA 49  // pin 9 on 74HC165 (DATA)
#define PIN_CLK 50   // pin 2 on 74HC165 (CLK))
#define PIN_LOAD 51  // pin 1 on 74HC165 (LOAD)

RoxButton button;

int count = 0;  //For MIDI Clk Sync
int DelayForSH3 = 50;
int patchNo = 0;
int patchNoU = 0;
int patchNoL = 0;
int voiceToReturn = -1;                 //Initialise
unsigned long earliestTime = millis();  //For voice allocation - initialise to now
unsigned long buttonDebounce = 0;

void pollAllMCPs();

void initRotaryEncoders();

void initButtons();

int getEncoderSpeed(int id);

void setup() {

  chordHoldActive = false;
  chordHoldWaitingForNotes = false;
  chordHoldCount = 0;

  SPI.begin();
  Wire.begin();           // Join the I2C bus as Master
  Wire.setClock(400000);  // Set I2C speed to 400 kHz

  mcp1.begin(0);
  delay(10);
  mcp2.begin(1);
  delay(10);
  mcp3.begin(2);
  delay(10);
  mcp4.begin(3);
  delay(10);
  mcp5.begin(4);
  delay(10);
  mcp6.begin(5);
  delay(10);
  mcp7.begin(6);
  delay(10);

  //groupEncoders();
  initRotaryEncoders();
  initButtons();

  mcp1.pinMode(7, OUTPUT);   // pin 7 = GPA7 of MCP2301X
  mcp1.pinMode(15, OUTPUT);  // pin 15 = GPB7 of MCP2301X

  mcp2.pinMode(7, OUTPUT);   // pin 7 = GPA7 of MCP2301X
  mcp2.pinMode(15, OUTPUT);  // pin 15 = GPB7 of MCP2301X

  mcp3.pinMode(7, OUTPUT);   // pin 7 = GPA7 of MCP2301X
  mcp3.pinMode(15, OUTPUT);  // pin 15 = GPB7 of MCP2301X

  mcp4.pinMode(7, OUTPUT);   // pin 7 = GPA7 of MCP2301X
  mcp4.pinMode(15, OUTPUT);  // pin 15 = GPB7 of MCP2301X

  mcp5.pinMode(7, OUTPUT);   // pin 7 = GPA7 of MCP2301X
  mcp5.pinMode(15, OUTPUT);  // pin 15 = GPB7 of MCP2301X

  mcp6.pinMode(6, OUTPUT);   // pin 6 = GPA6 of MCP2301X
  mcp6.pinMode(7, OUTPUT);   // pin 7 = GPA7 of MCP2301X
  mcp6.pinMode(14, OUTPUT);  // pin 14 = GPB6 of MCP2301X
  mcp6.pinMode(15, OUTPUT);  // pin 15 = GPB7 of MCP2301X

  mcp7.pinMode(7, OUTPUT);   // pin 7 = GPA7 of MCP2301X
  mcp7.pinMode(15, OUTPUT);  // pin 15 = GPB7 of MCP2301X

  setupDisplay();
  setUpSettings();
  setupHardware();

  octoswitch.begin(PIN_DATA, PIN_LOAD, PIN_CLK);
  octoswitch.setCallback(onButtonPress);

  srp.begin(LED_DATA, LED_LATCH, LED_CLK, LED_PWM);

  button.begin();
  button.setDoublePressThreshold(300);

  SPI.beginTransaction(SPISettings(20000000, MSBFIRST, SPI_MODE1));
  digitalWrite(DAC_CS1, LOW);
  delayMicroseconds(1);
  SPI.transfer32(int_ref_on_flexible_mode);
  digitalWrite(DAC_CS1, HIGH);
  SPI.endTransaction();

  for (int i = 0; i < 128; i++) {
    voiceAssignmentLower[i] = -1;
    voiceAssignmentUpper[i] = -1;
  }

  for (int i = 0; i < 4; i++) {
    voiceToNoteLower[i] = -1;
    voiceToNoteUpper[i] = -1;
  }


  cardStatus = SD.begin(BUILTIN_SDCARD);
  if (cardStatus) {
    Serial.println("SD card is connected");
    loadPatches();
    if (patches.size() == 0) {
      //save an initialised patch to SD card
      savePatch("1", INITPATCH);
      loadPatches();
    }
    loadPerformances();
    if (performances.size() == 0 && patches.size() > 0) {
      Performance defaultPerf = {
        1,
        patches.first().patchNo,
        patches.first().patchNo,
        "Default"
      };
      performances.push(defaultPerf);
      savePerformance("perf001", defaultPerf);
      loadPerformances();  // reload to ensure it's in the buffer
    }
  } else {
    Serial.println("SD card is not connected or unusable");
    reinitialiseToPanel();
    showPatchPage("No SD", "conn'd / usable", "", "");
  }

  //Read MIDI Channel from EEPROM
  midiChannel = getMIDIChannel();
  Serial.println("MIDI Ch:" + String(midiChannel) + " (0 is Omni On)");

  //USB HOST MIDI Class Compliant
  delay(400);  //Wait to turn on USB Host
  myusb.begin();
  midi1.setHandleControlChange(editControlChange);
  midi1.setHandleNoteOff(myNoteOff);
  midi1.setHandleNoteOn(myNoteOn);
  midi1.setHandlePitchChange(DinHandlePitchBend);
  midi1.setHandleAfterTouch(myAfterTouch);
  Serial.println("USB HOST MIDI Class Compliant Listening");

  //USB Client MIDI
  usbMIDI.setHandleControlChange(editControlChange);
  usbMIDI.setHandleProgramChange(myProgramChange);
  usbMIDI.setHandleAfterTouchChannel(myAfterTouch);
  usbMIDI.setHandlePitchChange(DinHandlePitchBend);
  usbMIDI.setHandleNoteOn(myNoteOn);
  usbMIDI.setHandleNoteOff(myNoteOff);
  Serial.println("USB Client MIDI Listening");

  //MIDI 5 Pin DIN
  MIDI.begin();
  MIDI.setHandleControlChange(editControlChange);
  MIDI.setHandleProgramChange(myProgramChange);
  MIDI.setHandleAfterTouchChannel(myAfterTouch);
  MIDI.setHandlePitchBend(DinHandlePitchBend);
  MIDI.setHandleNoteOn(myNoteOn);
  MIDI.setHandleNoteOff(myNoteOff);
  MIDI.turnThruOn(midi::Thru::Mode::Off);
  Serial.println("MIDI In DIN Listening");

  MIDI7.begin();
  MIDI7.turnThruOn(midi::Thru::Mode::Off);

  MIDI6.begin();
  MIDI6.turnThruOn(midi::Thru::Mode::Off);

  //Read Aftertouch from EEPROM, this can be set individually by each patch.
  upperData[P_AfterTouchDest] = getAfterTouchU();
  lowerData[P_AfterTouchDest] = getAfterTouchL();

  splitPoint = getSplitPoint();
  splitPoint = (splitPoint + 36);

  splitTrans = getSplitTrans();
  setTranspose(splitTrans);

  //Read Encoder Direction from EEPROM
  encCW = getEncoderDir();

  // Read the encoders accelerate
  accelerate = getEncoderAccelerate();

  //setupDisplay();
  delay(500);


  for (int i = 0; i < 8; i++) {
    int noteon = 60;
    MIDI6.sendNoteOn(noteon, 64, 1);
    delayMicroseconds(DelayForSH3);
    MIDI6.sendNoteOn(noteon, 64, 2);
    delay(1);
    MIDI6.sendNoteOff(noteon, 64, 1);
    delayMicroseconds(DelayForSH3);
    MIDI6.sendNoteOff(noteon, 64, 2);
    noteon++;
  }
  delay(200);

  patchNoU = 1;
  patchNoL = 1;
  upperSW = false;
  lowerSW = true;
  updatekeyboardMode(0);
  updateplayMode(0);
  recallPatch(patchNoL);  //Load first patch
}

void pollAllMCPs() {

  for (int j = 0; j < numMCPs; j++) {
    uint16_t gpioAB = allMCPs[j]->readGPIOAB();
    for (int i = 0; i < numEncoders; i++) {
      if (rotaryEncoders[i].getMCP() == allMCPs[j])
        rotaryEncoders[i].feedInput(gpioAB);
    }

    for (auto &button : allButtons) {
      if (button->getMcp() == allMCPs[j]) {
        button->feedInput(gpioAB);
      }
    }
  }
}

void initRotaryEncoders() {
  for (auto &rotaryEncoder : rotaryEncoders) {
    rotaryEncoder.init();
  }
}

void initButtons() {
  for (auto &button : allButtons) {
    button->begin();
  }
}

int getEncoderSpeed(int id) {
  if (id < 1 || id > numEncoders) return 1;

  unsigned long now = millis();
  unsigned long dt = now - lastTransition[id];

  // Linear acceleration mapping
  float minMult = 1.0f;
  float maxMult = 10.0f;
  float minDt = 30.0f;   // Fastest spins
  float maxDt = 350.0f;  // Slowest for any acceleration

  float mult;
  if (dt < minDt)
    mult = maxMult;
  else if (dt > maxDt)
    mult = minMult;
  else
    mult = maxMult - (maxMult - minMult) * ((dt - minDt) / (maxDt - minDt));

  // Optional: smooth multiplier for less jumpy response
  float alpha = 0.5f;  // 0.0 = no smoothing, 1.0 = max smoothing
  lastSpeed[id] = alpha * mult + (1.0f - alpha) * lastSpeed[id];

  lastTransition[id] = now;
  return (int)(lastSpeed[id] + 0.5f);
}

void RotaryEncoderChanged(bool clockwise, int id) {

  if (!accelerate) {
    speed = 1;
  } else {
    speed = getEncoderSpeed(id);
  }

  if (!clockwise) {
    speed = -speed;
  }

  switch (id) {
    case 1:
      if (upperSW) {
        upperData[P_glideTime] = (upperData[P_glideTime] + speed);
        upperData[P_glideTime] = constrain(upperData[P_glideTime], 0, 127);
        glideTimestr = LINEAR[upperData[P_glideTime]];
      } else {
        lowerData[P_glideTime] = (lowerData[P_glideTime] + speed);
        lowerData[P_glideTime] = constrain(lowerData[P_glideTime], 0, 127);
        glideTimestr = LINEAR[lowerData[P_glideTime]];
        if (wholemode) {
          upperData[P_glideTime] = lowerData[P_glideTime];
        }
      }

      updateglideTime(1);
      break;

    case 2:
      if (upperSW) {
        upperData[P_osc1PW] = (upperData[P_osc1PW] + speed);
        upperData[P_osc1PW] = constrain(upperData[P_osc1PW], 0, 127);
        osc1PWstr = PULSEWIDTH[upperData[P_osc1PW]];
      } else {
        lowerData[P_osc1PW] = (lowerData[P_osc1PW] + speed);
        lowerData[P_osc1PW] = constrain(lowerData[P_osc1PW], 0, 127);
        osc1PWstr = PULSEWIDTH[lowerData[P_osc1PW]];
        if (wholemode) {
          upperData[P_osc1PW] = lowerData[P_osc1PW];
        }
      }

      updateosc1PW(1);
      break;

    case 3:
      if (upperSW) {
        upperData[P_osc1PWM] = (upperData[P_osc1PWM] + speed);
        upperData[P_osc1PWM] = constrain(upperData[P_osc1PWM], 0, 127);
        osc1PWMstr = upperData[P_osc1PWM];
      } else {
        lowerData[P_osc1PWM] = (lowerData[P_osc1PWM] + speed);
        lowerData[P_osc1PWM] = constrain(lowerData[P_osc1PWM], 0, 127);
        osc1PWMstr = lowerData[P_osc1PWM];
        if (wholemode) {
          upperData[P_osc1PWM] = lowerData[P_osc1PWM];
        }
      }

      updateosc1PWM(1);
      break;

    case 4:
      if (upperSW) {
        upperData[P_osc1SawLevel] = (upperData[P_osc1SawLevel] + speed);
        upperData[P_osc1SawLevel] = constrain(upperData[P_osc1SawLevel], 0, 127);
        osc1SawLevelstr = upperData[P_osc1SawLevel];
      } else {
        lowerData[P_osc1SawLevel] = (lowerData[P_osc1SawLevel] + speed);
        lowerData[P_osc1SawLevel] = constrain(lowerData[P_osc1SawLevel], 0, 127);
        osc1SawLevelstr = lowerData[P_osc1SawLevel];
        if (wholemode) {
          upperData[P_osc1SawLevel] = lowerData[P_osc1SawLevel];
        }
      }

      updateOsc1SawLevel(1);
      break;

    case 5:
      if (upperSW) {
        upperData[P_osc1PulseLevel] = (upperData[P_osc1PulseLevel] + speed);
        upperData[P_osc1PulseLevel] = constrain(upperData[P_osc1PulseLevel], 0, 127);
        osc1PulseLevelstr = upperData[P_osc1PulseLevel];
      } else {
        lowerData[P_osc1PulseLevel] = (lowerData[P_osc1PulseLevel] + speed);
        lowerData[P_osc1PulseLevel] = constrain(lowerData[P_osc1PulseLevel], 0, 127);
        osc1PulseLevelstr = lowerData[P_osc1PulseLevel];
        if (wholemode) {
          upperData[P_osc1PulseLevel] = lowerData[P_osc1PulseLevel];
        }
      }

      updateOsc1PulseLevel(1);
      break;

    case 6:
      if (upperSW) {
        upperData[P_osc1SubLevel] = (upperData[P_osc1SubLevel] + speed);
        upperData[P_osc1SubLevel] = constrain(upperData[P_osc1SubLevel], 0, 127);
        osc1SubLevelstr = upperData[P_osc1SubLevel];
      } else {
        lowerData[P_osc1SubLevel] = (lowerData[P_osc1SubLevel] + speed);
        lowerData[P_osc1SubLevel] = constrain(lowerData[P_osc1SubLevel], 0, 127);
        osc1SubLevelstr = lowerData[P_osc1SubLevel];
        if (wholemode) {
          upperData[P_osc1SubLevel] = lowerData[P_osc1SubLevel];
        }
      }

      updateOsc1SubLevel(1);
      break;

    case 7:
      if (upperSW) {
        upperData[P_fmDepth] = (upperData[P_fmDepth] + speed);
        upperData[P_fmDepth] = constrain(upperData[P_fmDepth], 0, 127);
        fmDepthstr = upperData[P_fmDepth];
      } else {
        lowerData[P_fmDepth] = (lowerData[P_fmDepth] + speed);
        lowerData[P_fmDepth] = constrain(lowerData[P_fmDepth], 0, 127);
        fmDepthstr = lowerData[P_fmDepth];
        if (wholemode) {
          upperData[P_fmDepth] = lowerData[P_fmDepth];
        }
      }

      updatefmDepth(1);
      break;

    case 8:
      if (upperSW) {
        upperData[P_osc2PW] = (upperData[P_osc2PW] + speed);
        upperData[P_osc2PW] = constrain(upperData[P_osc2PW], 0, 127);
        osc2PWstr = PULSEWIDTH[upperData[P_osc2PW]];
      } else {
        lowerData[P_osc2PW] = (lowerData[P_osc2PW] + speed);
        lowerData[P_osc2PW] = constrain(lowerData[P_osc2PW], 0, 127);
        osc2PWstr = PULSEWIDTH[lowerData[P_osc2PW]];
        if (wholemode) {
          upperData[P_osc2PW] = lowerData[P_osc2PW];
        }
      }

      updateosc2PW(1);
      break;

    case 9:
      if (upperSW) {
        upperData[P_osc2PWM] = (upperData[P_osc2PWM] + speed);
        upperData[P_osc2PWM] = constrain(upperData[P_osc2PWM], 0, 127);
        osc2PWMstr = upperData[P_osc2PWM];
      } else {
        lowerData[P_osc2PWM] = (lowerData[P_osc2PWM] + speed);
        lowerData[P_osc2PWM] = constrain(lowerData[P_osc2PWM], 0, 127);
        osc2PWMstr = lowerData[P_osc2PWM];
        if (wholemode) {
          upperData[P_osc2PWM] = lowerData[P_osc2PWM];
        }
      }

      updateosc2PWM(1);
      break;

    case 10:
      if (upperSW) {
        upperData[P_osc2SawLevel] = (upperData[P_osc2SawLevel] + speed);
        upperData[P_osc2SawLevel] = constrain(upperData[P_osc2SawLevel], 0, 127);
        osc2SawLevelstr = upperData[P_osc2SawLevel];
      } else {
        lowerData[P_osc2SawLevel] = (lowerData[P_osc2SawLevel] + speed);
        lowerData[P_osc2SawLevel] = constrain(lowerData[P_osc2SawLevel], 0, 127);
        osc2SawLevelstr = lowerData[P_osc2SawLevel];
        if (wholemode) {
          upperData[P_osc2SawLevel] = lowerData[P_osc2SawLevel];
        }
      }

      updateOsc2SawLevel(1);
      break;

    case 11:
      if (upperSW) {
        upperData[P_osc2PulseLevel] = (upperData[P_osc2PulseLevel] + speed);
        upperData[P_osc2PulseLevel] = constrain(upperData[P_osc2PulseLevel], 0, 127);
        osc2PulseLevelstr = upperData[P_osc2PulseLevel];
      } else {
        lowerData[P_osc2PulseLevel] = (lowerData[P_osc2PulseLevel] + speed);
        lowerData[P_osc2PulseLevel] = constrain(lowerData[P_osc2PulseLevel], 0, 127);
        osc2PulseLevelstr = lowerData[P_osc2PulseLevel];
        if (wholemode) {
          upperData[P_osc2PulseLevel] = lowerData[P_osc2PulseLevel];
        }
      }

      updateOsc2PulseLevel(1);
      break;

    case 12:
      if (upperSW) {
        upperData[P_osc2TriangleLevel] = (upperData[P_osc2TriangleLevel] + speed);
        upperData[P_osc2TriangleLevel] = constrain(upperData[P_osc2TriangleLevel], 0, 127);
        osc2TriangleLevelstr = upperData[P_osc2TriangleLevel];
      } else {
        lowerData[P_osc2TriangleLevel] = (lowerData[P_osc2TriangleLevel] + speed);
        lowerData[P_osc2TriangleLevel] = constrain(lowerData[P_osc2TriangleLevel], 0, 127);
        osc2TriangleLevelstr = lowerData[P_osc2TriangleLevel];
        if (wholemode) {
          upperData[P_osc2TriangleLevel] = lowerData[P_osc2TriangleLevel];
        }
      }

      updateOsc2TriangleLevel(1);
      break;

    case 13:
      if (upperSW) {
        upperData[P_filterCutoff] = (upperData[P_filterCutoff] + speed);
        upperData[P_filterCutoff] = constrain(upperData[P_filterCutoff], 0, 127);
        filterCutoffstr = FILTERCUTOFF[upperData[P_filterCutoff]];
      } else {
        lowerData[P_filterCutoff] = (lowerData[P_filterCutoff] + speed);
        lowerData[P_filterCutoff] = constrain(lowerData[P_filterCutoff], 0, 127);
        filterCutoffstr = FILTERCUTOFF[lowerData[P_filterCutoff]];
        if (wholemode) {
          upperData[P_filterCutoff] = lowerData[P_filterCutoff];
        }
      }

      updateFilterCutoff(1);
      break;

    case 14:
      if (upperSW) {
        upperData[P_filterRes] = (upperData[P_filterRes] + speed);
        upperData[P_filterRes] = constrain(upperData[P_filterRes], 0, 127);
        filterResstr = upperData[P_filterRes];
      } else {
        lowerData[P_filterRes] = (lowerData[P_filterRes] + speed);
        lowerData[P_filterRes] = constrain(lowerData[P_filterRes], 0, 127);
        filterResstr = lowerData[P_filterRes];
        if (wholemode) {
          upperData[P_filterRes] = lowerData[P_filterRes];
        }
      }

      updatefilterRes(1);
      break;

    case 15:
      if (upperSW) {
        upperData[P_filterEGlevel] = (upperData[P_filterEGlevel] + speed);
        upperData[P_filterEGlevel] = constrain(upperData[P_filterEGlevel], 0, 127);
        filterEGlevelstr = upperData[P_filterEGlevel];
      } else {
        lowerData[P_filterEGlevel] = (lowerData[P_filterEGlevel] + speed);
        lowerData[P_filterEGlevel] = constrain(lowerData[P_filterEGlevel], 0, 127);
        filterEGlevelstr = lowerData[P_filterEGlevel];
        if (wholemode) {
          upperData[P_filterEGlevel] = lowerData[P_filterEGlevel];
        }
      }

      updatefilterEGlevel(1);
      break;

    case 16:
      if (upperSW) {
        upperData[P_keytrack] = (upperData[P_keytrack] + speed);
        upperData[P_keytrack] = constrain(upperData[P_keytrack], 0, 127);
        keytrackstr = upperData[P_keytrack];
      } else {
        lowerData[P_keytrack] = (lowerData[P_keytrack] + speed);
        lowerData[P_keytrack] = constrain(lowerData[P_keytrack], 0, 127);
        keytrackstr = lowerData[P_keytrack];
        if (wholemode) {
          upperData[P_keytrack] = lowerData[P_keytrack];
        }
      }

      updatekeytrack(1);
      break;

    case 17:
      if (upperSW) {
        upperData[P_filterLFO] = (upperData[P_filterLFO] + speed);
        upperData[P_filterLFO] = constrain(upperData[P_filterLFO], 0, 127);
        filterLFOstr = upperData[P_filterLFO];
      } else {
        lowerData[P_filterLFO] = (lowerData[P_filterLFO] + speed);
        lowerData[P_filterLFO] = constrain(lowerData[P_filterLFO], 0, 127);
        filterLFOstr = lowerData[P_filterLFO];
        if (wholemode) {
          upperData[P_filterLFO] = lowerData[P_filterLFO];
        }
      }

      updatefilterLFO(1);
      break;

    case 18:
      if (upperSW) {
        upperData[P_filterAttack] = (upperData[P_filterAttack] + speed);
        upperData[P_filterAttack] = constrain(upperData[P_filterAttack], 0, 127);
        filterAttackstr = ENVTIMES[upperData[P_filterAttack]];
      } else {
        lowerData[P_filterAttack] = (lowerData[P_filterAttack] + speed);
        lowerData[P_filterAttack] = constrain(lowerData[P_filterAttack], 0, 127);
        filterAttackstr = ENVTIMES[lowerData[P_filterAttack]];
        if (wholemode) {
          upperData[P_filterAttack] = lowerData[P_filterAttack];
        }
      }

      updatefilterAttack(1);
      break;

    case 19:
      if (upperSW) {
        upperData[P_filterDecay] = (upperData[P_filterDecay] + speed);
        upperData[P_filterDecay] = constrain(upperData[P_filterDecay], 0, 127);
        filterDecaystr = ENVTIMES[upperData[P_filterDecay]];
      } else {
        lowerData[P_filterDecay] = (lowerData[P_filterDecay] + speed);
        lowerData[P_filterDecay] = constrain(lowerData[P_filterDecay], 0, 127);
        filterDecaystr = ENVTIMES[lowerData[P_filterDecay]];
        if (wholemode) {
          upperData[P_filterDecay] = lowerData[P_filterDecay];
        }
      }

      updatefilterDecay(1);
      break;

    case 20:
      if (upperSW) {
        upperData[P_filterSustain] = (upperData[P_filterSustain] + speed);
        upperData[P_filterSustain] = constrain(upperData[P_filterSustain], 0, 127);
        filterSustainstr = LINEAR_FILTERMIXERSTR[upperData[P_filterSustain]];
      } else {
        lowerData[P_filterSustain] = (lowerData[P_filterSustain] + speed);
        lowerData[P_filterSustain] = constrain(lowerData[P_filterSustain], 0, 127);
        filterSustainstr = LINEAR_FILTERMIXERSTR[lowerData[P_filterSustain]];
        if (wholemode) {
          upperData[P_filterSustain] = lowerData[P_filterSustain];
        }
      }

      updatefilterSustain(1);
      break;

    case 21:
      if (upperSW) {
        upperData[P_filterRelease] = (upperData[P_filterRelease] + speed);
        upperData[P_filterRelease] = constrain(upperData[P_filterRelease], 0, 127);
        filterReleasestr = ENVTIMES[upperData[P_filterRelease]];
      } else {
        lowerData[P_filterRelease] = (lowerData[P_filterRelease] + speed);
        lowerData[P_filterRelease] = constrain(lowerData[P_filterRelease], 0, 127);
        filterReleasestr = ENVTIMES[lowerData[P_filterRelease]];
        if (wholemode) {
          upperData[P_filterRelease] = lowerData[P_filterRelease];
        }
      }

      updatefilterRelease(1);
      break;

    case 22:
      if (upperSW) {
        upperData[P_osc2Detune] = (upperData[P_osc2Detune] + speed);
        upperData[P_osc2Detune] = constrain(upperData[P_osc2Detune], 0, 127);
        osc2Detunestr = upperData[P_osc2Detune];
      } else {
        lowerData[P_osc2Detune] = (lowerData[P_osc2Detune] + speed);
        lowerData[P_osc2Detune] = constrain(lowerData[P_osc2Detune], 0, 127);
        osc2Detunestr = lowerData[P_osc2Detune];
        if (wholemode) {
          upperData[P_osc2Detune] = lowerData[P_osc2Detune];
        }
      }

      updateosc2Detune(1);
      break;

    case 23:
      if (upperSW) {
        upperData[P_osc2Interval] = (upperData[P_osc2Interval] + speed);
        upperData[P_osc2Interval] = constrain(upperData[P_osc2Interval], 0, 12);
        osc2Intervalstr = upperData[P_osc2Interval];
      } else {
        lowerData[P_osc2Interval] = (lowerData[P_osc2Interval] + speed);
        lowerData[P_osc2Interval] = constrain(lowerData[P_osc2Interval], 0, 12);
        osc2Intervalstr = lowerData[P_osc2Interval];
        if (wholemode) {
          upperData[P_osc2Interval] = lowerData[P_osc2Interval];
        }
      }

      updateosc2Interval(1);
      break;

    case 24:
      if (upperSW) {
        upperData[P_ampAttack] = (upperData[P_ampAttack] + speed);
        upperData[P_ampAttack] = constrain(upperData[P_ampAttack], 0, 127);
        ampAttackstr = ENVTIMES[upperData[P_ampAttack]];
      } else {
        lowerData[P_ampAttack] = (lowerData[P_ampAttack] + speed);
        lowerData[P_ampAttack] = constrain(lowerData[P_ampAttack], 0, 127);
        ampAttackstr = ENVTIMES[lowerData[P_ampAttack]];
        if (wholemode) {
          upperData[P_ampAttack] = lowerData[P_ampAttack];
        }
      }

      updateampAttack(1);
      break;

    case 25:
      if (upperSW) {
        upperData[P_ampDecay] = (upperData[P_ampDecay] + speed);
        upperData[P_ampDecay] = constrain(upperData[P_ampDecay], 0, 127);
        ampDecaystr = ENVTIMES[upperData[P_ampDecay]];
      } else {
        lowerData[P_ampDecay] = (lowerData[P_ampDecay] + speed);
        lowerData[P_ampDecay] = constrain(lowerData[P_ampDecay], 0, 127);
        ampDecaystr = ENVTIMES[lowerData[P_ampDecay]];
        if (wholemode) {
          upperData[P_ampDecay] = lowerData[P_ampDecay];
        }
      }

      updateampDecay(1);
      break;

    case 26:
      if (upperSW) {
        upperData[P_ampSustain] = (upperData[P_ampSustain] + speed);
        upperData[P_ampSustain] = constrain(upperData[P_ampSustain], 0, 127);
        ampSustainstr = LINEAR_FILTERMIXERSTR[upperData[P_ampSustain]];
      } else {
        lowerData[P_ampSustain] = (lowerData[P_ampSustain] + speed);
        lowerData[P_ampSustain] = constrain(lowerData[P_ampSustain], 0, 127);
        ampSustainstr = LINEAR_FILTERMIXERSTR[lowerData[P_ampSustain]];
        if (wholemode) {
          upperData[P_ampSustain] = lowerData[P_ampSustain];
        }
      }

      updateampSustain(1);
      break;

    case 27:
      if (upperSW) {
        upperData[P_ampRelease] = (upperData[P_ampRelease] + speed);
        upperData[P_ampRelease] = constrain(upperData[P_ampRelease], 0, 127);
        ampReleasestr = ENVTIMES[upperData[P_ampRelease]];
      } else {
        lowerData[P_ampRelease] = (lowerData[P_ampRelease] + speed);
        lowerData[P_ampRelease] = constrain(lowerData[P_ampRelease], 0, 127);
        ampReleasestr = ENVTIMES[lowerData[P_ampRelease]];
        if (wholemode) {
          upperData[P_ampRelease] = lowerData[P_ampRelease];
        }
      }

      updateampRelease(1);
      break;

    case 28:
      if (upperSW) {
        upperData[P_LFORate] = (upperData[P_LFORate] + speed);
        upperData[P_LFORate] = constrain(upperData[P_LFORate], 0, 127);
        LFORatestr = LFOTEMPO[upperData[P_LFORate]];
      } else {
        lowerData[P_LFORate] = (lowerData[P_LFORate] + speed);
        lowerData[P_LFORate] = constrain(lowerData[P_LFORate], 0, 127);
        LFORatestr = LFOTEMPO[lowerData[P_LFORate]];
        if (wholemode) {
          upperData[P_LFORate] = lowerData[P_LFORate];
        }
      }

      updateLFORate(1);
      break;

    case 29:
      if (upperSW) {
        upperData[P_LFODelay] = (upperData[P_LFODelay] + speed);
        upperData[P_LFODelay] = constrain(upperData[P_LFODelay], 0, 127);
        LFODelaystr = upperData[P_LFODelay];
      } else {
        lowerData[P_LFODelay] = (lowerData[P_LFODelay] + speed);
        lowerData[P_LFODelay] = constrain(lowerData[P_LFODelay], 0, 127);
        LFODelaystr = lowerData[P_LFODelay];
        if (wholemode) {
          upperData[P_LFODelay] = lowerData[P_LFODelay];
        }
      }

      updateLFODelay(1);
      break;

    case 30:
      if (upperSW) {
        upperData[P_modWheelDepth] = (upperData[P_modWheelDepth] + speed);
        upperData[P_modWheelDepth] = constrain(upperData[P_modWheelDepth], 0, 127);
        modWheelDepthstr = upperData[P_modWheelDepth];
      } else {
        lowerData[P_modWheelDepth] = (lowerData[P_modWheelDepth] + speed);
        lowerData[P_modWheelDepth] = constrain(lowerData[P_modWheelDepth], 0, 127);
        modWheelDepthstr = lowerData[P_modWheelDepth];
        if (wholemode) {
          upperData[P_modWheelDepth] = lowerData[P_modWheelDepth];
        }
      }

      updatemodWheelDepth(1);
      break;

    case 31:
      if (upperSW) {
        upperData[P_pwLFO] = (upperData[P_pwLFO] + speed);
        upperData[P_pwLFO] = constrain(upperData[P_pwLFO], 0, 127);
        pwLFOstr = LFOTEMPO[upperData[P_pwLFO]];
      } else {
        lowerData[P_pwLFO] = (lowerData[P_pwLFO] + speed);
        lowerData[P_pwLFO] = constrain(lowerData[P_pwLFO], 0, 127);
        pwLFOstr = LFOTEMPO[lowerData[P_pwLFO]];
        if (wholemode) {
          upperData[P_pwLFO] = lowerData[P_pwLFO];
        }
      }

      updatepwLFO(1);
      break;

    case 32:
      if (upperSW) {
        upperData[P_PitchBendLevel] = (upperData[P_PitchBendLevel] + speed);
        upperData[P_PitchBendLevel] = constrain(upperData[P_PitchBendLevel], 0, 12);
        PitchBendLevelstr = upperData[P_PitchBendLevel];
      } else {
        lowerData[P_PitchBendLevel] = (lowerData[P_PitchBendLevel] + speed);
        lowerData[P_PitchBendLevel] = constrain(lowerData[P_PitchBendLevel], 0, 12);
        PitchBendLevelstr = lowerData[P_PitchBendLevel];
        if (wholemode) {
          upperData[P_PitchBendLevel] = lowerData[P_PitchBendLevel];
        }
      }

      updatePitchBendDepth(1);
      break;

    case 33:
      if (upperSW) {
        upperData[P_noiseLevel] = (upperData[P_noiseLevel] + speed);
        upperData[P_noiseLevel] = constrain(upperData[P_noiseLevel], 0, 127);
        noiseLevelstr = LINEARCENTREZERO[upperData[P_noiseLevel]];
      } else {
        lowerData[P_noiseLevel] = (lowerData[P_noiseLevel] + speed);
        lowerData[P_noiseLevel] = constrain(lowerData[P_noiseLevel], 0, 127);
        noiseLevelstr = LINEARCENTREZERO[lowerData[P_noiseLevel]];
        if (wholemode) {
          upperData[P_noiseLevel] = lowerData[P_noiseLevel];
        }
      }

      updatenoiseLevel(1);
      break;

    case 34:
      if (upperSW) {
        upperData[P_ATDepth] = (upperData[P_ATDepth] + speed);
        upperData[P_ATDepth] = constrain(upperData[P_ATDepth], 0, 127);
        ATDepthstr = upperData[P_ATDepth];
      } else {
        lowerData[P_ATDepth] = (lowerData[P_ATDepth] + speed);
        lowerData[P_ATDepth] = constrain(lowerData[P_ATDepth], 0, 127);
        ATDepthstr = lowerData[P_ATDepth];
        if (wholemode) {
          upperData[P_ATDepth] = lowerData[P_ATDepth];
        }
      }

      updateATDepth(1);
      break;

    case 35:
      if (upperSW) {
        upperData[P_effectsMix] = (upperData[P_effectsMix] + speed);
        upperData[P_effectsMix] = constrain(upperData[P_effectsMix], 0, 127);
        effectsMixstr = LINEARCENTREZERO[upperData[P_effectsMix]];
      } else {
        lowerData[P_effectsMix] = (lowerData[P_effectsMix] + speed);
        lowerData[P_effectsMix] = constrain(lowerData[P_effectsMix], 0, 127);
        effectsMixstr = LINEARCENTREZERO[lowerData[P_effectsMix]];
        if (wholemode) {
          upperData[P_effectsMix] = lowerData[P_effectsMix];
        }
      }

      updateeffectsMix(1);
      break;

    case 36:
      if (upperSW) {
        upperData[P_volumeControl] = (upperData[P_volumeControl] + speed);
        upperData[P_volumeControl] = constrain(upperData[P_volumeControl], 0, 127);
        volumeControlstr = upperData[P_volumeControl];
      } else {
        lowerData[P_volumeControl] = (lowerData[P_volumeControl] + speed);
        lowerData[P_volumeControl] = constrain(lowerData[P_volumeControl], 0, 127);
        volumeControlstr = lowerData[P_volumeControl];
        if (wholemode) {
          upperData[P_volumeControl] = lowerData[P_volumeControl];
        }
      }

      updatevolumeControl(1);
      break;

    case 37:
      if (upperSW) {
        upperData[P_effectPot1] = (upperData[P_effectPot1] + speed);
        upperData[P_effectPot1] = constrain(upperData[P_effectPot1], 0, 127);
        effectPot1str = upperData[P_effectPot1];
      } else {
        lowerData[P_effectPot1] = (lowerData[P_effectPot1] + speed);
        lowerData[P_effectPot1] = constrain(lowerData[P_effectPot1], 0, 127);
        effectPot1str = lowerData[P_effectPot1];
        if (wholemode) {
          upperData[P_effectPot1] = lowerData[P_effectPot1];
        }
      }

      updateeffectPot1(1);
      break;

    case 38:
      if (upperSW) {
        upperData[P_effectPot2] = (upperData[P_effectPot2] + speed);
        upperData[P_effectPot2] = constrain(upperData[P_effectPot2], 0, 127);
        effectPot2str = upperData[P_effectPot2];
      } else {
        lowerData[P_effectPot2] = (lowerData[P_effectPot2] + speed);
        lowerData[P_effectPot2] = constrain(lowerData[P_effectPot2], 0, 127);
        effectPot2str = lowerData[P_effectPot2];
        if (wholemode) {
          upperData[P_effectPot2] = lowerData[P_effectPot2];
        }
      }

      updateeffectPot2(1);
      break;

    case 39:
      if (upperSW) {
        upperData[P_effectPot3] = (upperData[P_effectPot3] + speed);
        upperData[P_effectPot3] = constrain(upperData[P_effectPot3], 0, 127);
        effectPot3str = upperData[P_effectPot3];
      } else {
        lowerData[P_effectPot3] = (lowerData[P_effectPot3] + speed);
        lowerData[P_effectPot3] = constrain(lowerData[P_effectPot3], 0, 127);
        effectPot3str = lowerData[P_effectPot3];
        if (wholemode) {
          upperData[P_effectPot3] = lowerData[P_effectPot3];
        }
      }

      updateeffectPot3(1);
      break;

    case 40:
      if (upperSW) {
        upperData[P_pmDCO2] = (upperData[P_pmDCO2] + speed);
        upperData[P_pmDCO2] = constrain(upperData[P_pmDCO2], 0, 127);
        pmDCO2str = upperData[P_pmDCO2];
      } else {
        lowerData[P_pmDCO2] = (lowerData[P_pmDCO2] + speed);
        lowerData[P_pmDCO2] = constrain(lowerData[P_pmDCO2], 0, 127);
        pmDCO2str = lowerData[P_pmDCO2];
        if (wholemode) {
          upperData[P_pmDCO2] = lowerData[P_pmDCO2];
        }
      }

      updatePM_DCO2(1);
      break;

    case 41:
      if (upperSW) {
        upperData[P_pmFilterEnv] = (upperData[P_pmFilterEnv] + speed);
        upperData[P_pmFilterEnv] = constrain(upperData[P_pmFilterEnv], 0, 127);
        pmFilterEnvstr = upperData[P_pmFilterEnv];
      } else {
        lowerData[P_pmFilterEnv] = (lowerData[P_pmFilterEnv] + speed);
        lowerData[P_pmFilterEnv] = constrain(lowerData[P_pmFilterEnv], 0, 127);
        pmFilterEnvstr = lowerData[P_pmFilterEnv];
        if (wholemode) {
          upperData[P_pmFilterEnv] = lowerData[P_pmFilterEnv];
        }
      }

      updatePM_FilterEnv(1);
      break;

    case 42:
      if (upperSW) {
        upperData[P_amDepth] = (upperData[P_amDepth] + speed);
        upperData[P_amDepth] = constrain(upperData[P_amDepth], 0, 127);
        amDepthstr = upperData[P_amDepth];
      } else {
        lowerData[P_amDepth] = (lowerData[P_amDepth] + speed);
        lowerData[P_amDepth] = constrain(lowerData[P_amDepth], 0, 127);
        amDepthstr = lowerData[P_amDepth];
        if (wholemode) {
          upperData[P_amDepth] = lowerData[P_amDepth];
        }
      }

      updateamDepth(1);
      break;
  }


  //rotaryEncoderChanged(id, clockwise, speed);
}

void mainButtonChanged(Button *btn, bool released) {

  switch (btn->id) {

    case OSC1_PW_BUTTON:
      if (!released) {
        if (upperSW) {
          if (!toggleOsc1PWUpper) {
            storedOsc1PWUpper = upperData[P_osc1PW];  // store current
            upperData[P_osc1PW] = 63;                 // set to 50%
          } else {
            upperData[P_osc1PW] = storedOsc1PWUpper;  // restore original
          }
          toggleOsc1PWUpper = !toggleOsc1PWUpper;
          osc1PWstr = PULSEWIDTH[upperData[P_osc1PW]];
        } else {
          if (!toggleOsc1PWLower) {
            storedOsc1PWLower = lowerData[P_osc1PW];  // store current
            lowerData[P_osc1PW] = 63;                 // set to 50%
            if (wholemode) {
              upperData[P_osc1PW] = lowerData[P_osc1PW];
            }
          } else {
            lowerData[P_osc1PW] = storedOsc1PWLower;  // restore original
            if (wholemode) {
              upperData[P_osc1PW] = lowerData[P_osc1PW];
            }
          }
          toggleOsc1PWLower = !toggleOsc1PWLower;
          osc1PWstr = PULSEWIDTH[lowerData[P_osc1PW]];
        }

        updateosc1PW(1);
      }
      break;

    case OSC2_PW_BUTTON:
      if (!released) {
        if (upperSW) {
          if (!toggleOsc2PWUpper) {
            storedOsc2PWUpper = upperData[P_osc2PW];  // store current
            upperData[P_osc2PW] = 63;                 // set to 50%
          } else {
            upperData[P_osc2PW] = storedOsc2PWUpper;  // restore original
          }
          toggleOsc2PWUpper = !toggleOsc2PWUpper;
          osc2PWstr = PULSEWIDTH[upperData[P_osc2PW]];
        } else {
          if (!toggleOsc2PWLower) {
            storedOsc2PWLower = lowerData[P_osc2PW];  // store current
            lowerData[P_osc2PW] = 63;                 // set to 50%
            if (wholemode) {
              upperData[P_osc2PW] = lowerData[P_osc2PW];
            }
          } else {
            lowerData[P_osc2PW] = storedOsc2PWLower;  // restore original
            if (wholemode) {
              upperData[P_osc2PW] = lowerData[P_osc2PW];
            }
          }
          toggleOsc2PWLower = !toggleOsc2PWLower;
          osc2PWstr = PULSEWIDTH[lowerData[P_osc2PW]];
        }

        updateosc2PW(1);
      }
      break;

    case EFFECTS_MIX_BUTTON:
      if (!released) {
        if (upperSW) {
          if (!toggleEffectsMixU) {
            storedEffectsMixU = upperData[P_effectsMix];
            upperData[P_effectsMix] = 63;
          } else {
            upperData[P_effectsMix] = storedEffectsMixU;
          }
          toggleEffectsMixU = !toggleEffectsMixU;
          effectsMixstr = LINEARCENTREZERO[upperData[P_effectsMix]];
        } else {
          if (!toggleEffectsMixL) {
            storedEffectsMixL = lowerData[P_effectsMix];
            lowerData[P_effectsMix] = 63;
            if (wholemode) upperData[P_effectsMix] = 63;
          } else {
            lowerData[P_effectsMix] = storedEffectsMixL;
            if (wholemode) upperData[P_effectsMix] = storedEffectsMixL;
          }
          toggleEffectsMixL = !toggleEffectsMixL;
          effectsMixstr = LINEARCENTREZERO[lowerData[P_effectsMix]];
        }
        updateeffectsMix(1);
      }
      break;

    case NOISE_BUTTON:
      if (!released) {
        if (upperSW) {
          if (!toggleNoiseLevelU) {
            storedNoiseLevelU = upperData[P_noiseLevel];
            upperData[P_noiseLevel] = 63;
          } else {
            upperData[P_noiseLevel] = storedNoiseLevelU;
          }
          toggleNoiseLevelU = !toggleNoiseLevelU;
          noiseLevelstr = LINEARCENTREZERO[upperData[P_noiseLevel]];
        } else {
          if (!toggleNoiseLevelL) {
            storedNoiseLevelL = lowerData[P_noiseLevel];
            lowerData[P_noiseLevel] = 63;
            if (wholemode) upperData[P_noiseLevel] = 63;
          } else {
            lowerData[P_noiseLevel] = storedNoiseLevelL;
            if (wholemode) upperData[P_noiseLevel] = storedNoiseLevelL;
          }
          toggleNoiseLevelL = !toggleNoiseLevelL;
          noiseLevelstr = LINEARCENTREZERO[lowerData[P_noiseLevel]];
        }
        updatenoiseLevel(1);
      }
      break;

    case FM_DEPTH_BUTTON:
      if (!released) {
        if (upperSW) {
          if (!toggleFM_DepthU) {
            storedFM_DepthU = upperData[P_fmDepth];
            upperData[P_fmDepth] = 0;
          } else {
            upperData[P_fmDepth] = storedFM_DepthU;
          }
          toggleFM_DepthU = !toggleFM_DepthU;
          fmDepthstr = upperData[P_fmDepth];
        } else {
          if (!toggleFM_DepthL) {
            storedFM_DepthL = lowerData[P_fmDepth];
            lowerData[P_fmDepth] = 0;
            if (wholemode) upperData[P_fmDepth] = 0;
          } else {
            lowerData[P_fmDepth] = storedFM_DepthL;
            if (wholemode) upperData[P_fmDepth] = storedFM_DepthL;
          }
          toggleFM_DepthL = !toggleFM_DepthL;
          fmDepthstr = lowerData[P_fmDepth];
        }
        updatefmDepth(1);
      }
      break;

    case OSC2_DETUNE_BUTTON:
      if (!released) {
        if (upperSW) {
          if (!toggleOsc2_detuneU) {
            storedOsc2_detuneU = upperData[P_osc2Detune];
            upperData[P_osc2Detune] = 0;
          } else {
            upperData[P_osc2Detune] = storedOsc2_detuneU;
          }
          toggleOsc2_detuneU = !toggleOsc2_detuneU;
          osc2Detunestr = upperData[P_osc2Detune];
        } else {
          if (!toggleOsc2_detuneL) {
            storedOsc2_detuneL = lowerData[P_osc2Detune];
            lowerData[P_osc2Detune] = 0;
            if (wholemode) upperData[P_osc2Detune] = 0;
          } else {
            lowerData[P_osc2Detune] = storedOsc2_detuneL;
            if (wholemode) upperData[P_osc2Detune] = storedOsc2_detuneL;
          }
          toggleOsc2_detuneL = !toggleOsc2_detuneL;
          osc2Detunestr = lowerData[P_osc2Detune];
        }
        updateosc2Detune(1);
      }
      break;

    case OSC1_SAW_BUTTON:
      if (!released) {
        if (upperSW) {
          if (!toggleOsc1_SawU) {
            storedOsc1_SawU = upperData[P_osc1SawLevel];
            upperData[P_osc1SawLevel] = 0;
          } else {
            upperData[P_osc1SawLevel] = storedOsc1_SawU;
          }
          toggleOsc1_SawU = !toggleOsc1_SawU;
          osc1SawLevelstr = upperData[P_osc1SawLevel];
        } else {
          if (!toggleOsc1_SawL) {
            storedOsc1_SawL = lowerData[P_osc1SawLevel];
            lowerData[P_osc1SawLevel] = 0;
            if (wholemode) upperData[P_osc1SawLevel] = 0;
          } else {
            lowerData[P_osc1SawLevel] = storedOsc1_SawL;
            if (wholemode) upperData[P_osc1SawLevel] = storedOsc1_SawL;
          }
          toggleOsc1_SawL = !toggleOsc1_SawL;
          osc1SawLevelstr = lowerData[P_osc1SawLevel];
        }
        updateOsc1SawLevel(1);
      }
      break;

    case OSC2_SAW_BUTTON:
      if (!released) {
        if (upperSW) {
          if (!toggleOsc2_SawU) {
            storedOsc2_SawU = upperData[P_osc2SawLevel];
            upperData[P_osc2SawLevel] = 0;
          } else {
            upperData[P_osc2SawLevel] = storedOsc2_SawU;
          }
          toggleOsc2_SawU = !toggleOsc2_SawU;
          osc2SawLevelstr = upperData[P_osc2SawLevel];
        } else {
          if (!toggleOsc2_SawL) {
            storedOsc2_SawL = lowerData[P_osc2SawLevel];
            lowerData[P_osc2SawLevel] = 0;
            if (wholemode) upperData[P_osc2SawLevel] = 0;
          } else {
            lowerData[P_osc2SawLevel] = storedOsc2_SawL;
            if (wholemode) upperData[P_osc2SawLevel] = storedOsc2_SawL;
          }
          toggleOsc2_SawL = !toggleOsc2_SawL;
          osc2SawLevelstr = lowerData[P_osc2SawLevel];
        }
        updateOsc2SawLevel(1);
      }
      break;

    case OSC1_PULSE_BUTTON:
      if (!released) {
        if (upperSW) {
          if (!toggleOsc1_PulseU) {
            storedOsc1_PulseU = upperData[P_osc1PulseLevel];
            upperData[P_osc1PulseLevel] = 0;
          } else {
            upperData[P_osc1PulseLevel] = storedOsc1_PulseU;
          }
          toggleOsc1_PulseU = !toggleOsc1_PulseU;
          osc1PulseLevelstr = upperData[P_osc1PulseLevel];
        } else {
          if (!toggleOsc1_PulseL) {
            storedOsc1_PulseL = lowerData[P_osc1PulseLevel];
            lowerData[P_osc1PulseLevel] = 0;
            if (wholemode) upperData[P_osc1PulseLevel] = 0;
          } else {
            lowerData[P_osc1PulseLevel] = storedOsc1_PulseL;
            if (wholemode) upperData[P_osc1PulseLevel] = storedOsc1_PulseL;
          }
          toggleOsc1_PulseL = !toggleOsc1_PulseL;
          osc1PulseLevelstr = lowerData[P_osc1PulseLevel];
        }
        updateOsc1PulseLevel(1);
      }
      break;

    case OSC2_PULSE_BUTTON:
      if (!released) {
        if (upperSW) {
          if (!toggleOsc2_PulseU) {
            storedOsc2_PulseU = upperData[P_osc2PulseLevel];
            upperData[P_osc2PulseLevel] = 0;
          } else {
            upperData[P_osc2PulseLevel] = storedOsc2_PulseU;
          }
          toggleOsc2_PulseU = !toggleOsc2_PulseU;
          osc2PulseLevelstr = upperData[P_osc2PulseLevel];
        } else {
          if (!toggleOsc2_PulseL) {
            storedOsc2_PulseL = lowerData[P_osc2PulseLevel];
            lowerData[P_osc2PulseLevel] = 0;
            if (wholemode) upperData[P_osc2PulseLevel] = 0;
          } else {
            lowerData[P_osc2PulseLevel] = storedOsc2_PulseL;
            if (wholemode) upperData[P_osc2PulseLevel] = storedOsc2_PulseL;
          }
          toggleOsc2_PulseL = !toggleOsc2_PulseL;
          osc2PulseLevelstr = lowerData[P_osc2PulseLevel];
        }
        updateOsc2PulseLevel(1);
      }
      break;

    case OSC1_SUB_BUTTON:
      if (!released) {
        if (upperSW) {
          if (!toggleOsc1_SubU) {
            storedOsc1_SubU = upperData[P_osc1SubLevel];
            upperData[P_osc1SubLevel] = 0;
          } else {
            upperData[P_osc1SubLevel] = storedOsc1_SubU;
          }
          toggleOsc1_SubU = !toggleOsc1_SubU;
          osc1SubLevelstr = upperData[P_osc1SubLevel];
        } else {
          if (!toggleOsc1_SubL) {
            storedOsc1_SubL = lowerData[P_osc1SubLevel];
            lowerData[P_osc1SubLevel] = 0;
            if (wholemode) upperData[P_osc1SubLevel] = 0;
          } else {
            lowerData[P_osc1SubLevel] = storedOsc1_SubL;
            if (wholemode) upperData[P_osc1SubLevel] = storedOsc1_SubL;
          }
          toggleOsc1_SubL = !toggleOsc1_SubL;
          osc1SubLevelstr = lowerData[P_osc1SubLevel];
        }
        updateOsc1SubLevel(1);
      }
      break;

    case OSC2_TRI_BUTTON:
      if (!released) {
        if (upperSW) {
          if (!toggleOsc2_TriU) {
            storedOsc2_TriU = upperData[P_osc2TriangleLevel];
            upperData[P_osc2TriangleLevel] = 0;
          } else {
            upperData[P_osc2TriangleLevel] = storedOsc2_TriU;
          }
          toggleOsc2_TriU = !toggleOsc2_TriU;
          osc2TriangleLevelstr = upperData[P_osc2TriangleLevel];
        } else {
          if (!toggleOsc2_TriL) {
            storedOsc2_TriL = lowerData[P_osc2TriangleLevel];
            lowerData[P_osc2TriangleLevel] = 0;
            if (wholemode) upperData[P_osc2TriangleLevel] = 0;
          } else {
            lowerData[P_osc2TriangleLevel] = storedOsc2_TriL;
            if (wholemode) upperData[P_osc2TriangleLevel] = storedOsc2_TriL;
          }
          toggleOsc2_TriL = !toggleOsc2_TriL;
          osc2TriangleLevelstr = lowerData[P_osc2TriangleLevel];
        }
        updateOsc2TriangleLevel(1);
      }
      break;
  }
}

void recallPerformance(const Performance &perf) {
  currentPerformance = perf;
  playMode = perf.mode;

  switch (playMode) {
    case WHOLE:
      recallPatch(perf.lowerPatchNo);
      patchNo = perf.lowerPatchNo;
      refreshPatchDisplayFromState();
      break;
    case DUAL:
    case SPLIT:
      recallPatch(perf.upperPatchNo);
      recallPatch(perf.lowerPatchNo);
      patchNo = perf.lowerPatchNo;
      refreshPatchDisplayFromState();
      break;
  }
}

void refreshPatchDisplayFromState() {
  showPatchPage(
    currentPgmNumU,
    currentPatchNameU,
    currentPgmNumL,
    currentPatchNameL);
}

String getModeName(PlayMode mode) {
  switch (mode) {
    case WHOLE: return "Whole";
    case DUAL: return "Dual";
    case SPLIT: return "Split";
    default: return "-";
  }
}


void loadPerformances() {
  performances.clear();
  File dir = SD.open("/performances");

  if (!dir || !dir.isDirectory()) {
    Serial.println("/performances not found or is not a directory");
    return;
  }

  while (true) {
    File file = dir.openNextFile();
    if (!file) break;

    if (file.isDirectory()) {
      file.close();
      continue;
    }

    String dataLine = file.readStringUntil('\n');
    file.close();

    if (dataLine.length() > 0) {
      int comma1 = dataLine.indexOf(',');
      int comma2 = dataLine.indexOf(',', comma1 + 1);
      int comma3 = dataLine.indexOf(',', comma2 + 1);

      if (comma1 == -1 || comma2 == -1 || comma3 == -1) continue;

      int upper = dataLine.substring(0, comma1).toInt();
      int lower = dataLine.substring(comma1 + 1, comma2).toInt();
      String name = dataLine.substring(comma2 + 1, comma3);
      int mode = dataLine.substring(comma3 + 1).toInt();

      int perfNo = performances.size() + 1;
      performances.push({ perfNo, upper, lower, name, (PlayMode)mode });
    }
  }

  if (performances.size() == 0) {
    Performance defaultPerf = { 1, 1, 1, "Default", WHOLE };
    savePerformance("perf001", defaultPerf);
    loadPerformances();  // try again
  }
}

void savePerformance(const char *fileName, const Performance &perf) {
  String path = "/performances/" + String(fileName);

  if (SD.exists(path.c_str())) {
    SD.remove(path.c_str());
  }

  File file = SD.open(path.c_str(), FILE_WRITE);
  if (file) {
    file.print(perf.upperPatchNo);
    file.print(",");
    file.print(perf.lowerPatchNo);
    file.print(",");
    file.print(perf.name);
    file.print(",");
    file.println((int)perf.mode);  // Save playMode as an integer (0, 1, 2)
    file.close();
  } else {
    Serial.print("Failed to save performance: ");
    Serial.println(path);
  }
}

void editControlChange(byte channel, byte control, byte value) {
  int newvalue = value;
  myControlChange(channel, control, newvalue);
}

int mod(int a, int b) {
  int r = a % b;
  return r < 0 ? r + b : r;
}

void setTranspose(int splitTrans) {
  switch (splitTrans) {
    case 0:
      lowerTranspose = -24;
      oldsplitTrans = splitTrans;
      break;

    case 1:
      lowerTranspose = -12;
      oldsplitTrans = splitTrans;
      break;

    case 2:
      lowerTranspose = 0;
      oldsplitTrans = splitTrans;
      break;

    case 3:
      lowerTranspose = 12;
      oldsplitTrans = splitTrans;
      break;

    case 4:
      lowerTranspose = 24;
      oldsplitTrans = splitTrans;
      break;
  }
}

void LFODelayHandle() {
  // LFO Delay code
  getDelayTime();

  unsigned long currentMillisU = millis();
  if (upperData[P_monoMulti] && !upperData[P_LFODelayGo]) {
    if (oldnumberOfNotesU < numberOfNotesU) {
      previousMillisU = currentMillisU;
      oldnumberOfNotesU = numberOfNotesU;
    }
  }
  if (numberOfNotesU > 0) {
    if (currentMillisU - previousMillisU >= intervalU) {
      upperData[P_LFODelayGo] = 1;
    } else {
      upperData[P_LFODelayGo] = 0;
    }
  } else {
    upperData[P_LFODelayGo] = 1;
    previousMillisU = currentMillisU;  //reset timer so its ready for the next time
  }

  unsigned long currentMillisL = millis();
  if (lowerData[P_monoMulti] && !lowerData[P_LFODelayGo]) {
    if (oldnumberOfNotesL < numberOfNotesL) {
      previousMillisL = currentMillisL;
      oldnumberOfNotesL = numberOfNotesL;
    }
  }
  if (numberOfNotesL > 0) {
    if (currentMillisL - previousMillisL >= intervalL) {
      lowerData[P_LFODelayGo] = 1;
    } else {
      lowerData[P_LFODelayGo] = 0;
    }
  } else {
    lowerData[P_LFODelayGo] = 1;
    previousMillisL = currentMillisL;  //reset timer so its ready for the next time
  }
}

// Mono lower & uppper

void commandTopNoteLower() {
  int topNote = -1;
  for (int i = 0; i < 128; i++)
    if (notesLower[i]) topNote = i;

  if (topNote >= 0)
    assignVoice(topNote, noteVel, 0);
  else
    releaseVoice(noteMsg, 0);
}

void commandBottomNoteLower() {
  int bottomNote = -1;
  for (int i = 127; i >= 0; i--)
    if (notesLower[i]) bottomNote = i;

  if (bottomNote >= 0)
    assignVoice(bottomNote, noteVel, 0);
  else
    releaseVoice(noteMsg, 0);
}

void commandLastNoteLower() {
  for (int i = 0; i < 40; i++) {
    int8_t idx = noteOrderLower[mod(orderIndxLower - i, 40)];
    if (notesLower[idx]) {
      assignVoice(idx, noteVel, 0);
      return;
    }
  }
  releaseVoice(noteMsg, 0);
}

void commandTopNoteUpper() {
  int topNote = -1;
  for (int i = 0; i < 128; i++)
    if (notesUpper[i]) topNote = i;

  if (topNote >= 0)
    assignVoice(topNote, noteVel, 4);
  else
    releaseVoice(noteMsg, 4);
}

void commandBottomNoteUpper() {
  int bottomNote = -1;
  for (int i = 127; i >= 0; i--)
    if (notesUpper[i]) bottomNote = i;

  if (bottomNote >= 0)
    assignVoice(bottomNote, noteVel, 4);
  else
    releaseVoice(noteMsg, 4);
}

void commandLastNoteUpper() {
  for (int i = 0; i < 40; i++) {
    int8_t idx = noteOrderUpper[mod(orderIndxUpper - i, 40)];
    if (notesUpper[idx]) {
      assignVoice(idx, noteVel, 4);
      return;
    }
  }
  releaseVoice(noteMsg, 4);
}

// Unison lower and upper

void commandTopNoteUniLower() {
  int topNote = -1;
  for (int i = 0; i < 128; i++)
    if (notesLower[i]) topNote = i;

  if (topNote >= 0)
    for (int v = 0; v < 4; v++) assignVoice(topNote, noteVel, v);
  else
    for (int v = 0; v < 4; v++) releaseVoice(noteMsg, v);
}

void commandBottomNoteUniLower() {
  int bottomNote = -1;
  for (int i = 127; i >= 0; i--)
    if (notesLower[i]) bottomNote = i;

  if (bottomNote >= 0)
    for (int v = 0; v < 4; v++) assignVoice(bottomNote, noteVel, v);
  else
    for (int v = 0; v < 4; v++) releaseVoice(noteMsg, v);
}

void commandLastNoteUniLower() {
  for (int i = 0; i < 40; i++) {
    int8_t idx = noteOrderLower[mod(orderIndxLower - i, 40)];
    if (notesLower[idx]) {
      for (int v = 0; v < 4; v++) assignVoice(idx, noteVel, v);
      return;
    }
  }
  for (int v = 0; v < 4; v++) releaseVoice(noteMsg, v);
}

void commandTopNoteUniUpper() {
  int topNote = -1;
  for (int i = 0; i < 128; i++)
    if (notesUpper[i]) topNote = i;

  if (topNote >= 0)
    for (int v = 4; v < 8; v++) assignVoice(topNote, noteVel, v);
  else
    for (int v = 4; v < 8; v++) releaseVoice(noteMsg, v);
}

void commandBottomNoteUniUpper() {
  int bottomNote = -1;
  for (int i = 127; i >= 0; i--)
    if (notesUpper[i]) bottomNote = i;

  if (bottomNote >= 0)
    for (int v = 4; v < 8; v++) assignVoice(bottomNote, noteVel, v);
  else
    for (int v = 4; v < 8; v++) releaseVoice(noteMsg, v);
}

void commandLastNoteUniUpper() {
  for (int i = 0; i < 40; i++) {
    int8_t idx = noteOrderUpper[mod(orderIndxUpper - i, 40)];
    if (notesUpper[idx]) {
      for (int v = 4; v < 8; v++) assignVoice(idx, noteVel, v);
      return;
    }
  }
  for (int v = 4; v < 8; v++) releaseVoice(noteMsg, v);
}

void memorizeChordFromVoices() {
  uint8_t heldNotes[MAX_CHORD_NOTES];
  uint8_t count = 0;
  for (int i = 0; i < NO_OF_VOICES; ++i) {
    // Use .noteOn or voiceOn[] (either works)
    if (voices[i].note >= 0 && voices[i].noteOn) {
      bool already = false;
      for (int j = 0; j < count; ++j)
        if (heldNotes[j] == voices[i].note) already = true;
      if (!already && count < MAX_CHORD_NOTES)
        heldNotes[count++] = voices[i].note;
    }
  }
  if (count > 0) {
    // Sort
    for (int i = 0; i < count - 1; i++)
      for (int j = i + 1; j < count; j++)
        if (heldNotes[j] < heldNotes[i])
          std::swap(heldNotes[i], heldNotes[j]);
    chordHoldRoot = heldNotes[0];
    chordHoldCount = count;
    for (int i = 0; i < count; i++)
      chordHoldIntervals[i] = heldNotes[i] - chordHoldRoot;
    chordHoldActive = true;
    chordHoldWaitingForNotes = false;
    //Serial.print("Chord Hold: root ");
    //Serial.print(chordHoldRoot);
    //Serial.print(" intervals: ");
    //for (int i = 0; i < count; i++) Serial.print((int)chordHoldIntervals[i]), Serial.print(" ");
    //Serial.println();
  } else {
    chordHoldActive = true;
    chordHoldWaitingForNotes = false;
    chordHoldCount = 0;
    //Serial.println("Chord Hold: No chord detected, disarmed.");
  }
}

void onHoldButtonPressed() {
    chordHoldActive = true;
    chordHoldWaitingForNotes = true;
    chordHoldCount = 0;

    // --- New: if notes are already held, capture immediately ---
    bool anyActive = false;
    for (int i = 0; i < NO_OF_VOICES; ++i) {
        if (voices[i].note >= 0 && voices[i].noteOn) {
            anyActive = true;
            break;
        }
    }
    if (anyActive) {
        memorizeChordFromVoices();
        chordHoldWaitingForNotes = false;
        chordHoldCaptureWindowActive = false;
        //Serial.println("Chord Hold: Captured chord immediately.");
    } else {
        // No notes held: start waiting for a chord (timer capture window)
        chordHoldCaptureWindowActive = false;
        chordHoldStartTime = 0;
        //Serial.println("Chord Hold: ARMED, waiting for chord input.");
    }
}

void onHoldButtonReleased() {
  chordHoldActive = false;
  chordHoldWaitingForNotes = false;
  chordHoldCount = 0;
  chordHoldCaptureWindowActive = false;
  chordHoldStartTime = 0;
  //Serial.println("Chord Hold: OFF");
}

void myNoteOn(byte channel, byte note, byte velocity) {

  if (isAutotuning) return;

  numberOfNotesU++;
  numberOfNotesL++;
  prevNote = note;

  // ---- CHORD HOLD FOR POLY1/POLY2 ----
  bool polyMode = (lowerData[P_keyboardMode] == 0 || lowerData[P_keyboardMode] == 1);
  bool chordHoldIsActive = chordHoldActive && polyMode && playMode == 0;

  // Chord Hold active: play transposed chord
  if (chordHoldIsActive && chordHoldCount > 0 && !chordHoldWaitingForNotes) {
    for (int i = 0; i < chordHoldCount; i++) {
      uint8_t chordNote = note + chordHoldIntervals[i];
      int voiceNum = (lowerData[P_keyboardMode] == 0) ? getVoiceNo(-1) - 1 : getVoiceNoPoly2(-1) - 1;
      assignVoice(chordNote, velocity, voiceNum);
      voiceAssignment[chordNote] = voiceNum;
      //Serial.print("NoteOn: ");
      //Serial.println(chordNote);
    }
    return;
  }
  // ---- END CHORD HOLD ----

  int voiceNum = -1;

  switch (playMode) {

    // WHOLE MODE (No changes needed if currently working)
    case 0:
      switch (lowerData[P_keyboardMode]) {
        case 0:
          voiceNum = getVoiceNo(-1) - 1;
          assignVoice(note, velocity, voiceNum);
          break;  // Poly1
        case 1:
          voiceNum = getVoiceNoPoly2(-1) - 1;
          assignVoice(note, velocity, voiceNum);
          break;                                             // Poly2
        case 2: commandMonoNoteOn(note, velocity); break;    // Mono
        case 3: commandUnisonNoteOn(note, velocity); break;  // Unison
      }
      voiceAssignment[note] = voiceNum;
      break;

    // DUAL MODE (Explicitly corrected, place this clearly here):
    case 1:
      {
        // Lower Split
        if (lowerData[P_keyboardMode] == 1) {  // Poly2 Lower
          int lowerVoice = getLowerSplitVoicePoly2(note);
          int oldNote = voiceToNoteLower[lowerVoice];
          if (oldNote >= 0) {
            releaseVoice(oldNote, lowerVoice);
            voiceAssignmentLower[oldNote] = -1;
          }
          assignVoice(note, velocity, lowerVoice);
          voiceAssignmentLower[note] = lowerVoice;
          voiceToNoteLower[lowerVoice] = note;
        } else if (lowerData[P_keyboardMode] == 0) {  // Poly1 Lower
          int lowerVoice = getLowerSplitVoice(note);
          assignVoice(note, velocity, lowerVoice);
          voiceAssignmentLower[note] = lowerVoice;
          voiceToNoteLower[lowerVoice] = note;
        } else if (lowerData[P_keyboardMode] == 2) {
          commandMonoNoteOnLower(note, velocity, lowerData[P_NotePriority]);
        } else if (lowerData[P_keyboardMode] == 3) {
          commandUnisonNoteOnLower(note, velocity, lowerData[P_NotePriority]);
        }

        // Upper Split
        if (upperData[P_keyboardMode] == 1) {  // Poly2 Upper
          int upperVoice = getUpperSplitVoicePoly2(note);
          int oldNote = voiceToNoteUpper[upperVoice - 4];
          if (oldNote >= 0) {
            releaseVoice(oldNote, upperVoice);
            voiceAssignmentUpper[oldNote] = -1;
          }
          assignVoice(note, velocity, upperVoice);
          voiceAssignmentUpper[note] = upperVoice;
          voiceToNoteUpper[upperVoice - 4] = note;
        } else if (upperData[P_keyboardMode] == 0) {  // Poly1 Upper
          int upperVoice = getUpperSplitVoice(note);
          assignVoice(note, velocity, upperVoice);
          voiceAssignmentUpper[note] = upperVoice;
          voiceToNoteUpper[upperVoice - 4] = note;
        } else if (upperData[P_keyboardMode] == 2) {
          commandMonoNoteOnUpper(note, velocity, upperData[P_NotePriority]);
        } else if (upperData[P_keyboardMode] == 3) {
          commandUnisonNoteOnUpper(note, velocity, upperData[P_NotePriority]);
        }
      }
      break;

      // SPLIT MODE (Also explicitly corrected, place here clearly):
    case 2:  // SPLIT MODE explicitly confirmed (note-on):
      if (note < splitPoint) {
        switch (lowerData[P_keyboardMode]) {
          case 0:
            voiceNum = getLowerSplitVoice(note);
            assignVoice(note, velocity, voiceNum);
            voiceAssignmentLower[note] = voiceNum;
            voiceToNoteLower[voiceNum] = note;
            break;
          case 1:
            voiceNum = getLowerSplitVoicePoly2(note);
            assignVoice(note, velocity, voiceNum);
            voiceAssignmentLower[note] = voiceNum;
            voiceToNoteLower[voiceNum] = note;
            break;
          case 2:
            commandMonoNoteOnLower(note, velocity, lowerData[P_NotePriority]);
            break;
          case 3:
            commandUnisonNoteOnLower(note, velocity, lowerData[P_NotePriority]);
            break;
        }
      } else {
        switch (upperData[P_keyboardMode]) {
          case 0:
            voiceNum = getUpperSplitVoice(note);
            assignVoice(note, velocity, voiceNum);
            voiceAssignmentUpper[note] = voiceNum;
            voiceToNoteUpper[voiceNum - 4] = note;
            break;
          case 1:
            voiceNum = getUpperSplitVoicePoly2(note);
            assignVoice(note, velocity, voiceNum);
            voiceAssignmentUpper[note] = voiceNum;
            voiceToNoteUpper[voiceNum - 4] = note;
            break;
          case 2:
            commandMonoNoteOnUpper(note, velocity, upperData[P_NotePriority]);
            break;
          case 3:
            commandUnisonNoteOnUpper(note, velocity, upperData[P_NotePriority]);
            break;
        }
      }
      break;
  }
  if (chordHoldActive && chordHoldWaitingForNotes) {
    if (!chordHoldCaptureWindowActive) {
      chordHoldCaptureWindowActive = true;
      chordHoldStartTime = millis();
      //Serial.println("Chord Hold: Capture window started.");
    }
    // Do NOT call memorizeChordFromVoices() here; let loop() do it after window ends
  }
}

void myNoteOff(byte channel, byte note, byte velocity) {

  if (isAutotuning) return;

  numberOfNotesU--;
  numberOfNotesL--;

  // ---- CHORD HOLD FOR POLY1/POLY2 ----
  bool polyMode = (lowerData[P_keyboardMode] == 0 || lowerData[P_keyboardMode] == 1);
  bool chordHoldIsActive = chordHoldActive && polyMode && playMode == 0;

  if (chordHoldIsActive && chordHoldCount > 0) {
    for (int i = 0; i < chordHoldCount; i++) {
      uint8_t chordNote = note + chordHoldIntervals[i];
      int assignedVoice = voiceAssignment[chordNote];
      if (assignedVoice >= 0) {
        releaseVoice(chordNote, assignedVoice);
        voiceAssignment[chordNote] = -1;
        //Serial.print("NoteOff: ");
        //Serial.println(chordNote);
      }
    }
    return;
  }
  // ---- END CHORD HOLD ----

  int assignedVoice = voiceAssignment[note];

  switch (playMode) {

    // WHOLE MODE corrected explicitly
    case 0:
      switch (lowerData[P_keyboardMode]) {
        case 0:
          assignedVoice = getVoiceNo(note) - 1;
          releaseVoice(note, assignedVoice);
          break;
        case 1:
          assignedVoice = getVoiceNoPoly2(note) - 1;
          releaseVoice(note, assignedVoice);
          break;
        case 2: commandMonoNoteOff(note); break;
        case 3: commandUnisonNoteOff(note); break;
      }
      break;

      // DUAL MODE corrected explicitly
    case 1:  // DUAL MODE Poly2 fix explicitly (note-off):
      {
        // Lower Split
        if (lowerData[P_keyboardMode] == 2) commandMonoNoteOffLower(note);
        else if (lowerData[P_keyboardMode] == 3) commandUnisonNoteOffLower(note);
        else {
          int lowerVoice = voiceAssignmentLower[note];
          if (lowerVoice >= 0 && lowerVoice <= 3 && voiceToNoteLower[lowerVoice] == note) {
            releaseVoice(note, lowerVoice);
            voiceAssignmentLower[note] = -1;
            voiceToNoteLower[lowerVoice] = -1;
          }
        }

        // Upper Split
        if (upperData[P_keyboardMode] == 2) commandMonoNoteOffUpper(note);
        else if (upperData[P_keyboardMode] == 3) commandUnisonNoteOffUpper(note);
        else {
          int upperVoice = voiceAssignmentUpper[note];
          if (upperVoice >= 4 && upperVoice <= 7 && voiceToNoteUpper[upperVoice - 4] == note) {
            releaseVoice(note, upperVoice);
            voiceAssignmentUpper[note] = -1;
            voiceToNoteUpper[upperVoice - 4] = -1;
          }
        }
      }
      break;

      // SPLIT MODE corrected explicitly
    case 2:  // SPLIT MODE explicitly corrected (note-off):
      {
        if (note < splitPoint) {
          if (lowerData[P_keyboardMode] == 2) {
            commandMonoNoteOffLower(note);
          } else if (lowerData[P_keyboardMode] == 3) {
            commandUnisonNoteOffLower(note);
          } else {
            int lowerVoice = voiceAssignmentLower[note];
            if (lowerVoice >= 0 && lowerVoice <= 3 && voiceToNoteLower[lowerVoice] == note) {
              releaseVoice(note, lowerVoice);
              voiceAssignmentLower[note] = -1;
              voiceToNoteLower[lowerVoice] = -1;
            }
          }
        } else {
          if (upperData[P_keyboardMode] == 2) {
            commandMonoNoteOffUpper(note);
          } else if (upperData[P_keyboardMode] == 3) {
            commandUnisonNoteOffUpper(note);
          } else {
            int upperVoice = voiceAssignmentUpper[note];
            if (upperVoice >= 4 && upperVoice <= 7 && voiceToNoteUpper[upperVoice - 4] == note) {
              releaseVoice(note, upperVoice);
              voiceAssignmentUpper[note] = -1;
              voiceToNoteUpper[upperVoice - 4] = -1;
            }
          }
        }
      }
      break;
  }
}

void commandMonoNoteOn(byte note, byte velocity) {
  notesWhole[note] = true;
  noteMsg = note;
  noteVel = velocity;
  orderIndxWhole = (orderIndxWhole + 1) % 40;
  noteOrderWhole[orderIndxWhole] = note;

  if (lowerData[P_NotePriority] == 0) commandTopNoteWhole();
  else if (lowerData[P_NotePriority] == 1) commandBottomNoteWhole();
  else commandLastNoteWhole();
}

void commandMonoNoteOff(byte note) {
  notesWhole[note] = false;
  noteMsg = note;
  commandLastNoteWhole();
}

void commandTopNoteWhole() {
  int topNote = -1;
  for (int i = 0; i < 128; i++)
    if (notesWhole[i]) topNote = i;

  if (topNote >= 0) assignVoice(topNote, noteVel, 0);
  else releaseVoice(noteMsg, 0);
}

void commandBottomNoteWhole() {
  int bottomNote = -1;
  for (int i = 127; i >= 0; i--)
    if (notesWhole[i]) bottomNote = i;

  if (bottomNote >= 0) assignVoice(bottomNote, noteVel, 0);
  else releaseVoice(noteMsg, 0);
}

void commandLastNoteWhole() {
  for (int i = 0; i < 40; i++) {
    int8_t idx = noteOrderWhole[mod(orderIndxWhole - i, 40)];
    if (notesWhole[idx]) {
      assignVoice(idx, noteVel, 0);
      return;
    }
  }
  releaseVoice(noteMsg, 0);
}

void commandUnisonNoteOn(byte note, byte velocity) {
  notesWhole[note] = true;
  noteMsg = note;
  noteVel = velocity;
  orderIndxWhole = (orderIndxWhole + 1) % 40;
  noteOrderWhole[orderIndxWhole] = note;

  if (lowerData[P_NotePriority] == 0) commandTopNoteUniWhole();
  else if (lowerData[P_NotePriority] == 1) commandBottomNoteUniWhole();
  else commandLastNoteUniWhole();
}

void commandUnisonNoteOff(byte note) {
  notesWhole[note] = false;
  noteMsg = note;
  commandLastNoteUniWhole();
}

void commandTopNoteUniWhole() {
  int topNote = -1;
  for (int i = 0; i < 128; i++)
    if (notesWhole[i]) topNote = i;
  if (topNote >= 0)
    for (int v = 0; v < 8; v++) assignVoice(topNote, noteVel, v);
  else
    for (int v = 0; v < 8; v++) releaseVoice(noteMsg, v);
}

void commandBottomNoteUniWhole() {
  int bottomNote = -1;
  for (int i = 127; i >= 0; i--)
    if (notesWhole[i]) bottomNote = i;
  if (bottomNote >= 0)
    for (int v = 0; v < 8; v++) assignVoice(bottomNote, noteVel, v);
  else
    for (int v = 0; v < 8; v++) releaseVoice(noteMsg, v);
}

void commandLastNoteUniWhole() {
  for (int i = 0; i < 40; i++) {
    int8_t idx = noteOrderWhole[mod(orderIndxWhole - i, 40)];
    if (notesWhole[idx]) {
      for (int v = 0; v < 8; v++) assignVoice(idx, noteVel, v);
      return;
    }
  }
  for (int v = 0; v < 8; v++) releaseVoice(noteMsg, v);
}


void commandMonoNoteOnUpper(byte note, byte velocity, byte priority) {
  notesUpper[note] = true;
  noteMsg = note;
  noteVel = velocity;
  orderIndxUpper = (orderIndxUpper + 1) % 40;
  noteOrderUpper[orderIndxUpper] = note;
  if (priority == 0) commandTopNoteUpper();
  else if (priority == 1) commandBottomNoteUpper();
  else commandLastNoteUpper();
}

void commandMonoNoteOffUpper(byte note) {
  notesUpper[note] = false;
  noteMsg = note;
  commandLastNoteUpper();
}

void commandMonoNoteOnLower(byte note, byte velocity, byte priority) {
  notesLower[note] = true;
  noteMsg = note;
  noteVel = velocity;
  orderIndxLower = (orderIndxLower + 1) % 40;
  noteOrderLower[orderIndxLower] = note;

  if (priority == 0) commandTopNoteLower();
  else if (priority == 1) commandBottomNoteLower();
  else commandLastNoteLower();
}

void commandMonoNoteOffLower(byte note) {
  notesLower[note] = false;
  noteMsg = note;
  commandLastNoteLower();
}

void commandUnisonNoteOnUpper(byte note, byte velocity, byte priority) {
  notesUpper[note] = true;
  noteMsg = note;                                       // explicitly set here
  noteVel = velocity;                                   // explicitly set here
  if (priority == 0) commandTopNoteUniUpper();          // Highest priority
  else if (priority == 1) commandBottomNoteUniUpper();  // Lowest priority
  else commandLastNoteUniUpper();                       // Last note priority
}

void commandUnisonNoteOffUpper(byte note) {
  notesUpper[note] = false;
  noteMsg = note;  // explicitly set here
  commandLastNoteUniUpper();
}

void commandUnisonNoteOnLower(byte note, byte velocity, byte priority) {
  notesLower[note] = true;
  noteMsg = note;                                       // explicitly set here
  noteVel = velocity;                                   // explicitly set here
  if (priority == 0) commandTopNoteUniLower();          // Highest priority
  else if (priority == 1) commandBottomNoteUniLower();  // Lowest priority
  else commandLastNoteUniLower();                       // Last note priority
}

void commandUnisonNoteOffLower(byte note) {
  notesLower[note] = false;
  noteMsg = note;  // explicitly set here
  commandLastNoteUniLower();
}

int getUpperSplitVoice(byte note) {
  for (int i = 0; i < 4; i++) {
    int idx = 4 + (upperSplitVoicePointer + i) % 4;
    if (!voiceOn[idx]) {
      upperSplitVoicePointer = (idx + 1) % 4;
      return idx;
    }
  }
  // fallback oldest (poly2 style if no voice free)
  int oldest = 4;
  unsigned long oldestTime = voices[4].timeOn;
  for (int i = 5; i < 8; i++)
    if (voices[i].timeOn < oldestTime) {
      oldest = i;
      oldestTime = voices[i].timeOn;
    }
  upperSplitVoicePointer = ((oldest - 4) + 1) % 4;
  return oldest;
}

int getLowerSplitVoice(byte note) {
  for (int i = 0; i < 4; i++) {
    int idx = (lowerSplitVoicePointer + i) % 4;
    if (!voiceOn[idx]) {
      lowerSplitVoicePointer = (idx + 1) % 4;
      return idx;
    }
  }
  int oldest = 0;
  unsigned long oldestTime = voices[0].timeOn;
  for (int i = 1; i < 4; i++)
    if (voices[i].timeOn < oldestTime) {
      oldest = i;
      oldestTime = voices[i].timeOn;
    }
  lowerSplitVoicePointer = (oldest + 1) % 4;
  return oldest;
}

int getLowerSplitVoicePoly2(byte note) {
  for (int i = 0; i < 4; i++)
    if (!voiceOn[i]) return i;

  int oldest = 0;
  unsigned long oldestTime = voices[0].timeOn;

  for (int i = 1; i < 4; i++) {
    if (voices[i].timeOn < oldestTime) {
      oldest = i;
      oldestTime = voices[i].timeOn;
    }
  }
  return oldest;
}

int getUpperSplitVoicePoly2(byte note) {
  for (int i = 4; i < 8; i++)
    if (!voiceOn[i]) return i;

  int oldest = 4;
  unsigned long oldestTime = voices[4].timeOn;

  for (int i = 5; i < 8; i++) {
    if (voices[i].timeOn < oldestTime) {
      oldest = i;
      oldestTime = voices[i].timeOn;
    }
  }
  return oldest;
}


// Leave these functions as-is
void assignVoice(byte note, byte velocity, int voiceIdx) {
  if (voiceIdx >= 0 && voiceIdx < 8) {
    voices[voiceIdx].note = note;
    voices[voiceIdx].velocity = velocity;
    voices[voiceIdx].timeOn = millis();
    voices[voiceIdx].noteOn = true;  // <-- This enables chord hold!
    MIDI6.sendNoteOn(note, velocity, voiceIdx + 1);
    voiceOn[voiceIdx] = true;
  }
}

void releaseVoice(byte note, int voiceIdx) {
  if (voiceIdx >= 0 && voiceIdx < 8 && voices[voiceIdx].note == note) {
    MIDI6.sendNoteOff(note, 0, voiceIdx + 1);
    voices[voiceIdx].note = -1;
    voices[voiceIdx].noteOn = false;
    voiceOn[voiceIdx] = false;

    if (voiceIdx < 4) {
      voiceAssignmentLower[note] = -1;
      voiceToNoteLower[voiceIdx] = -1;
    } else {
      voiceAssignmentUpper[note] = -1;
      voiceToNoteUpper[voiceIdx - 4] = -1;
    }
  }
}

int getVoiceNoPoly2(int note) {
  voiceToReturn = -1;       // Initialize to 'null'
  earliestTime = millis();  // Initialize to now

  if (note == -1) {
    // NoteOn() - Get the oldest free voice (recent voices may still be on the release stage)
    if (voices[lastUsedVoice].note == -1) {
      return lastUsedVoice + 1;
    }

    // If the last used voice is not free or doesn't exist, check if the first voice is free
    if (voices[0].note == -1) {
      return 1;
    }

    // Find the lowest available voice for the new note
    for (int i = 0; i < NO_OF_VOICES; i++) {
      if (voices[i].note == -1) {
        return i + 1;
      }
    }

    // If no voice is available, release the oldest note
    int oldestVoice = 0;
    for (int i = 1; i < NO_OF_VOICES; i++) {
      if (voices[i].timeOn < voices[oldestVoice].timeOn) {
        oldestVoice = i;
      }
    }
    return oldestVoice + 1;
  } else {
    // NoteOff() - Get the voice number from the note
    for (int i = 0; i < NO_OF_VOICES; i++) {
      if (voices[i].note == note) {
        return i + 1;
      }
    }
  }

  // Shouldn't get here, return voice 1
  return 1;
}


int getVoiceNo(int note) {
  voiceToReturn = -1;       //Initialise to 'null'
  earliestTime = millis();  //Initialise to now
  if (note == -1) {
    //NoteOn() - Get the oldest free voice (recent voices may be still on release stage)
    for (int i = 0; i < NO_OF_VOICES; i++) {
      if (voices[i].note == -1) {
        if (voices[i].timeOn < earliestTime) {
          earliestTime = voices[i].timeOn;
          voiceToReturn = i;
        }
      }
    }
    if (voiceToReturn == -1) {
      //No free voices, need to steal oldest sounding voice
      earliestTime = millis();  //Reinitialise
      for (int i = 0; i < NO_OF_VOICES; i++) {
        if (voices[i].timeOn < earliestTime) {
          earliestTime = voices[i].timeOn;
          voiceToReturn = i;
        }
      }
    }
    return voiceToReturn + 1;
  } else {
    //NoteOff() - Get voice number from note
    for (int i = 0; i < NO_OF_VOICES; i++) {
      if (voices[i].note == note) {
        return i + 1;
      }
    }
  }
  //Shouldn't get here, return voice 1
  return 1;
}

void DinHandlePitchBend(byte channel, int pitch) {
  if (wholemode) {
    MIDI6.sendPitchBend(pitch, 1);
    MIDI6.sendPitchBend(pitch, 2);
  }
  if (dualmode) {
    MIDI6.sendPitchBend(pitch, 1);
    MIDI6.sendPitchBend(pitch, 2);
  }
  if (splitmode) {
    MIDI6.sendPitchBend(pitch, 1);
    MIDI6.sendPitchBend(pitch, 2);
  }
}

void getDelayTime() {
  delaytimeL = (lowerData[P_LFODelay]);
  if (delaytimeL <= 0) {
    delaytimeL = 0.1;
  }
  intervalL = (delaytimeL * 100);

  delaytimeU = (upperData[P_LFODelay]);
  if (delaytimeU <= 0) {
    delaytimeU = 0.1;
  }
  intervalU = (delaytimeU * 100);
}

void allNotesOff() {
  midiCCOut61(WSallNotesOff, 127);
  midiCCOut62(WSallNotesOff, 127);
}

void updatepwLFO(boolean announce) {

  if (announce) {
    showCurrentParameterPage("PWM Rate", int(pwLFOstr));
  }
  if (upperSW) {
    midiCCOut(CCpwLFO, upperData[P_pwLFO]);
    midiCCOut71(CCpwLFO, upperData[P_pwLFO]);
  } else {
    midiCCOut(CCpwLFO, lowerData[P_pwLFO]);
    midiCCOut71(CCpwLFO, lowerData[P_pwLFO]);
  }
}

void updatefmDepth(boolean announce) {
  if (announce) {
    showCurrentParameterPage("FM Depth", int(fmDepthstr));
  }
  if (upperSW) {
    midiCCOut62(WSFMDepth, upperData[P_fmDepth]);
    midiCCOut(CCfmDepth, upperData[P_fmDepth]);
    midiCCOut71(CCfmDepth, upperData[P_fmDepth]);
  } else {
    midiCCOut61(WSFMDepth, lowerData[P_fmDepth]);
    midiCCOut(CCfmDepth, lowerData[P_fmDepth]);
    midiCCOut71(CCfmDepth, lowerData[P_fmDepth]);
    if (wholemode) {
      midiCCOut62(WSFMDepth, upperData[P_fmDepth]);
    }
  }
}

void updateATDepth(boolean announce) {
  if (announce) {
    showCurrentParameterPage("AT Depth", int(ATDepthstr));
  }
  if (upperSW) {
    midiCCOut62(WSATmodDepth, upperData[P_ATDepth]);
    midiCCOut(CCATDepth, upperData[P_ATDepth]);
    midiCCOut71(CCATDepth, upperData[P_ATDepth]);
  } else {
    midiCCOut61(WSATmodDepth, lowerData[P_ATDepth]);
    midiCCOut(CCATDepth, lowerData[P_ATDepth]);
    midiCCOut71(CCATDepth, lowerData[P_ATDepth]);
    if (wholemode) {
      midiCCOut62(WSATmodDepth, upperData[P_ATDepth]);
    }
  }
}

void updateosc2PW(boolean announce) {
  if (announce) {
    showCurrentParameterPage("OSC2 PW", String(osc2PWstr) + " %");
  }
  if (upperSW) {
    midiCCOut62(WSosc2PW, upperData[P_osc2PW]);
    midiCCOut(CCosc2PW, upperData[P_osc2PW]);
    midiCCOut71(CCosc2PW, upperData[P_osc2PW]);
  } else {
    midiCCOut61(WSosc2PW, lowerData[P_osc2PW]);
    midiCCOut(CCosc2PW, lowerData[P_osc2PW]);
    midiCCOut71(CCosc2PW, lowerData[P_osc2PW]);
    if (wholemode) {
      midiCCOut62(WSosc2PW, upperData[P_osc2PW]);
    }
  }
}

void updateosc2PWM(boolean announce) {
  if (announce) {
    showCurrentParameterPage("OSC2 PWM", int(osc2PWMstr));
  }
  if (upperSW) {
    midiCCOut62(WSosc2PWM, upperData[P_osc2PWM]);
    midiCCOut(CCosc2PWM, upperData[P_osc2PWM]);
    midiCCOut71(CCosc2PWM, upperData[P_osc2PWM]);
  } else {
    midiCCOut61(WSosc2PWM, lowerData[P_osc2PWM]);
    midiCCOut(CCosc2PWM, lowerData[P_osc2PWM]);
    midiCCOut71(CCosc2PWM, lowerData[P_osc2PWM]);
    if (wholemode) {
      midiCCOut62(WSosc2PWM, upperData[P_osc2PWM]);
    }
  }
}

void updateosc1PW(boolean announce) {

  if (announce) {
    showCurrentParameterPage("OSC1 PW", String(osc1PWstr) + " %");
  }
  if (upperSW) {
    midiCCOut62(WSosc1PW, upperData[P_osc1PW]);
    midiCCOut(CCosc1PW, upperData[P_osc1PW]);
    midiCCOut71(CCosc1PW, upperData[P_osc1PW]);
  } else {
    midiCCOut61(WSosc1PW, lowerData[P_osc1PW]);
    midiCCOut(CCosc1PW, lowerData[P_osc1PW]);
    midiCCOut71(CCosc1PW, lowerData[P_osc1PW]);
    if (wholemode) {
      midiCCOut62(WSosc1PW, upperData[P_osc1PW]);
    }
  }
}

void updateosc1PWM(boolean announce) {
  if (announce) {
    showCurrentParameterPage("OSC1 PWM", int(osc1PWMstr));
  }
  if (upperSW) {
    midiCCOut62(WSosc1PWM, upperData[P_osc1PWM]);
    midiCCOut(CCosc1PWM, upperData[P_osc1PWM]);
    midiCCOut71(CCosc1PWM, upperData[P_osc1PWM]);
  } else {
    midiCCOut61(WSosc1PWM, lowerData[P_osc1PWM]);
    midiCCOut(CCosc1PWM, lowerData[P_osc1PWM]);
    midiCCOut71(CCosc1PWM, lowerData[P_osc1PWM]);
    if (wholemode) {
      midiCCOut62(WSosc1PWM, upperData[P_osc1PWM]);
    }
  }
}

void updateosc1Range(boolean announce) {
  if (upperSW) {
    panelData[P_osc1Range] = upperData[P_osc1Range];
    if (upperData[P_osc1Range] == 2) {
      if (announce) {
        showCurrentParameterPage("Osc1 Range", String("8"));
      }
      midiCCOut(CCosc1Oct, 2);
      midiCCOut62(WSosc1oct, 127);
      midiCCOut72(CCosc1Oct, 2);
    } else if (upperData[P_osc1Range] == 1) {
      if (announce) {
        showCurrentParameterPage("Osc1 Range", String("16"));
      }
      midiCCOut(CCosc1Oct, 1);
      midiCCOut62(WSosc1oct, 64);
      midiCCOut72(CCosc1Oct, 1);
    } else {
      if (announce) {
        showCurrentParameterPage("Osc1 Range", String("32"));
      }
      midiCCOut(CCosc1Oct, 0);
      midiCCOut62(WSosc1oct, 0);
      midiCCOut72(CCosc1Oct, 0);
    }
  } else {
    panelData[P_osc1Range] = lowerData[P_osc1Range];
    if (lowerData[P_osc1Range] == 2) {
      if (announce) {
        showCurrentParameterPage("Osc1 Range", String("8"));
      }
      midiCCOut(CCosc1Oct, 2);
      midiCCOut61(WSosc1oct, 127);
      midiCCOut72(CCosc1Oct, 2);
      if (wholemode) {
        midiCCOut62(WSosc1oct, 127);
      }
    } else if (lowerData[P_osc1Range] == 1) {
      if (announce) {
        showCurrentParameterPage("Osc1 Range", String("16"));
      }
      midiCCOut(CCosc1Oct, 1);
      midiCCOut61(WSosc1oct, 64);
      midiCCOut72(CCosc1Oct, 1);
      if (wholemode) {
        midiCCOut62(WSosc1oct, 64);
      }
    } else {
      if (announce) {
        showCurrentParameterPage("Osc1 Range", String("32"));
      }
      midiCCOut(CCosc1Oct, 0);
      midiCCOut61(WSosc1oct, 0);
      midiCCOut72(CCosc1Oct, 0);
      if (wholemode) {
        midiCCOut62(WSosc1oct, 0);
      }
    }
  }
}

void updateosc2Range(boolean announce) {
  if (upperSW) {
    panelData[P_osc2Range] = upperData[P_osc2Range];
    if (upperData[P_osc2Range] == 2) {
      if (announce) {
        showCurrentParameterPage("Osc2 Range", String("8"));
      }
      midiCCOut62(WSosc2oct, 127);
      midiCCOut72(CCosc2Oct, 2);
      midiCCOut(CCosc2Oct, 2);
    } else if (upperData[P_osc2Range] == 1) {
      if (announce) {
        showCurrentParameterPage("Osc2 Range", String("16"));
      }
      midiCCOut62(WSosc2oct, 64);
      midiCCOut72(CCosc2Oct, 1);
      midiCCOut(CCosc2Oct, 1);
    } else {
      if (announce) {
        showCurrentParameterPage("Osc2 Range", String("32"));
      }
      midiCCOut(CCosc2Oct, 0);
      midiCCOut62(WSosc2oct, 0);
      midiCCOut72(CCosc2Oct, 0);
    }
  } else {
    panelData[P_osc2Range] = lowerData[P_osc2Range];
    if (lowerData[P_osc2Range] == 2) {
      if (announce) {
        showCurrentParameterPage("Osc2 Range", String("8"));
      }
      midiCCOut(CCosc2Oct, 2);
      midiCCOut61(WSosc2oct, 127);
      midiCCOut72(CCosc2Oct, 2);
      if (wholemode) {
        midiCCOut62(WSosc2oct, 127);
      }
    } else if (lowerData[P_osc2Range] == 1) {
      if (announce) {
        showCurrentParameterPage("Osc2 Range", String("16"));
      }
      midiCCOut(CCosc2Oct, 1);
      midiCCOut61(WSosc2oct, 64);
      midiCCOut72(CCosc2Oct, 1);
      if (wholemode) {
        midiCCOut62(WSosc2oct, 64);
      }
    } else {
      if (announce) {
        showCurrentParameterPage("Osc2 Range", String("32"));
      }
      midiCCOut(CCosc2Oct, 0);
      midiCCOut61(WSosc2oct, 0);
      midiCCOut72(CCosc2Oct, 0);
      if (wholemode) {
        midiCCOut62(WSosc2oct, 0);
      }
    }
  }
}

void updateglideTime(boolean announce) {
  if (announce) {
    showCurrentParameterPage("Glide Time", String(glideTimestr * 10) + " Seconds");
  }
  if (upperSW) {
    midiCCOut62(WSglideTime, upperData[P_glideTime]);
    midiCCOut(CCglideTime, upperData[P_glideTime]);
    midiCCOut71(CCglideTime, upperData[P_glideTime]);
  } else {
    midiCCOut61(WSglideTime, lowerData[P_glideTime]);
    midiCCOut(CCglideTime, lowerData[P_glideTime]);
    midiCCOut71(CCglideTime, lowerData[P_glideTime]);
    if (wholemode) {
      midiCCOut62(WSglideTime, upperData[P_glideTime]);
    }
  }
}

void updateosc2Detune(boolean announce) {
  if (announce) {
    showCurrentParameterPage("OSC2 Detune", String(osc2Detunestr));
  }
  if (upperSW) {
    midiCCOut62(WSdetune, upperData[P_osc2Detune]);
    midiCCOut(CCosc2Detune, upperData[P_osc2Detune]);
    midiCCOut71(CCosc2Detune, upperData[P_osc2Detune]);
  } else {
    midiCCOut61(WSdetune, lowerData[P_osc2Detune]);
    midiCCOut(CCosc2Detune, lowerData[P_osc2Detune]);
    midiCCOut71(CCosc2Detune, lowerData[P_osc2Detune]);
    if (wholemode) {
      midiCCOut62(WSdetune, upperData[P_osc2Detune]);
    }
  }
}

void updateosc2Interval(boolean announce) {
  if (announce) {
    showCurrentParameterPage("OSC2 Interval", String(osc2Intervalstr));
  }
  if (upperSW) {
    midiCCOut62(WSinterval, upperData[P_osc2Interval]);
    midiCCOut(CCosc2Interval, upperData[P_osc2Interval]);
    midiCCOut71(CCosc2Interval, upperData[P_osc2Interval]);
  } else {
    midiCCOut61(WSinterval, lowerData[P_osc2Interval]);
    midiCCOut(CCosc2Interval, lowerData[P_osc2Interval]);
    midiCCOut71(CCosc2Interval, lowerData[P_osc2Interval]);
    if (wholemode) {
      midiCCOut62(WSinterval, upperData[P_osc2Interval]);
    }
  }
}

void updatenoiseLevel(boolean announce) {
  if (announce) {
    showCurrentParameterPage("Noise Level", String(noiseLevelstr));
  }
  if (upperSW) {
    midiCCOut(CCnoiseLevel, upperData[P_noiseLevel]);
    midiCCOut71(CCnoiseLevel, upperData[P_noiseLevel]);
  } else {
    midiCCOut(CCnoiseLevel, lowerData[P_noiseLevel]);
    midiCCOut71(CCnoiseLevel, lowerData[P_noiseLevel]);
  }
}

void updateOsc2SawLevel(boolean announce) {
  if (announce) {
    showCurrentParameterPage("OSC2 Saw", int(osc2SawLevelstr));
  }
  if (upperSW) {
    midiCCOut(CCosc2SawLevel, upperData[P_osc2SawLevel]);
    midiCCOut71(CCosc2SawLevel, upperData[P_osc2SawLevel]);
  } else {
    midiCCOut(CCosc2SawLevel, lowerData[P_osc2SawLevel]);
    midiCCOut71(CCosc2SawLevel, lowerData[P_osc2SawLevel]);
  }
}

void updateOsc1SawLevel(boolean announce) {
  if (announce) {
    showCurrentParameterPage("OSC1 Saw", int(osc1SawLevelstr));
  }
  if (upperSW) {
    midiCCOut(CCosc1SawLevel, upperData[P_osc1SawLevel]);
    midiCCOut71(CCosc1SawLevel, upperData[P_osc1SawLevel]);
  } else {
    midiCCOut(CCosc1SawLevel, lowerData[P_osc1SawLevel]);
    midiCCOut71(CCosc1SawLevel, lowerData[P_osc1SawLevel]);
  }
}

void updateOsc2PulseLevel(boolean announce) {
  if (announce) {
    showCurrentParameterPage("OSC2 Pulse", int(osc2PulseLevelstr));
  }
  if (upperSW) {
    midiCCOut(CCosc2PulseLevel, upperData[P_osc2PulseLevel]);
    midiCCOut71(CCosc2PulseLevel, upperData[P_osc2PulseLevel]);
  } else {
    midiCCOut(CCosc2PulseLevel, lowerData[P_osc2PulseLevel]);
    midiCCOut71(CCosc2PulseLevel, lowerData[P_osc2PulseLevel]);
  }
}

void updateOsc1PulseLevel(boolean announce) {
  if (announce) {
    showCurrentParameterPage("OSC1 Pulse", int(osc1PulseLevelstr));
  }
  if (upperSW) {
    midiCCOut(CCosc1PulseLevel, upperData[P_osc1PulseLevel]);
    midiCCOut71(CCosc1PulseLevel, upperData[P_osc1PulseLevel]);
  } else {
    midiCCOut(CCosc1PulseLevel, lowerData[P_osc1PulseLevel]);
    midiCCOut71(CCosc1PulseLevel, lowerData[P_osc1PulseLevel]);
  }
}

void updateOsc2TriangleLevel(boolean announce) {
  if (announce) {
    showCurrentParameterPage("OSC2 Triangle", int(osc2TriangleLevelstr));
  }
  if (upperSW) {
    midiCCOut(CCosc2TriangleLevel, upperData[P_osc2TriangleLevel]);
    midiCCOut71(CCosc2TriangleLevel, upperData[P_osc2TriangleLevel]);
  } else {
    midiCCOut(CCosc2TriangleLevel, lowerData[P_osc2TriangleLevel]);
    midiCCOut71(CCosc2TriangleLevel, lowerData[P_osc2TriangleLevel]);
  }
}

void updateOsc1SubLevel(boolean announce) {
  if (announce) {
    showCurrentParameterPage("OSC1 Sub", int(osc1SubLevelstr));
  }
  if (upperSW) {
    midiCCOut(CCosc1SubLevel, upperData[P_osc1SubLevel]);
    midiCCOut71(CCosc1SubLevel, upperData[P_osc1SubLevel]);
  } else {
    midiCCOut(CCosc1SubLevel, lowerData[P_osc1SubLevel]);
    midiCCOut71(CCosc1SubLevel, lowerData[P_osc1SubLevel]);
  }
}

void updateamDepth(boolean announce) {
  if (announce) {
    showCurrentParameterPage("AM Depth", int(amDepthstr));
  }
  if (upperSW) {
    midiCCOut(CCamDepth, upperData[P_amDepth]);
    midiCCOut71(CCamDepth, upperData[P_amDepth]);
  } else {
    midiCCOut(CCamDepth, lowerData[P_amDepth]);
    midiCCOut71(CCamDepth, lowerData[P_amDepth]);
  }
}

void updateFilterCutoff(boolean announce) {
  if (announce) {
    showCurrentParameterPage("Cutoff", String(filterCutoffstr) + " Hz");
  }
  if (upperSW) {
    midiCCOut(CCfilterCutoff, upperData[P_filterCutoff]);
    midiCCOut71(CCfilterCutoff, upperData[P_filterCutoff]);
  } else {
    midiCCOut(CCfilterCutoff, lowerData[P_filterCutoff]);
    midiCCOut71(CCfilterCutoff, lowerData[P_filterCutoff]);
  }
}

void updatefilterLFO(boolean announce) {
  if (announce) {
    showCurrentParameterPage("TM depth", int(filterLFOstr));
  }
  if (upperSW) {
    midiCCOut(CCfilterLFO, upperData[P_filterLFO]);
    midiCCOut71(CCfilterLFO, upperData[P_filterLFO]);
  } else {
    midiCCOut(CCfilterLFO, lowerData[P_filterLFO]);
    midiCCOut71(CCfilterLFO, lowerData[P_filterLFO]);
  }
}

void updatefilterRes(boolean announce) {
  if (announce) {
    showCurrentParameterPage("Resonance", int(filterResstr));
  }
  if (upperSW) {
    midiCCOut(CCfilterRes, upperData[P_filterRes]);
    midiCCOut71(CCfilterRes, upperData[P_filterRes]);
  } else {
    midiCCOut(CCfilterRes, lowerData[P_filterRes]);
    midiCCOut71(CCfilterRes, lowerData[P_filterRes]);
  }
}

void updateFilterType(boolean announce) {
  if (upperSW) {
    switch (upperData[P_filterType]) {
      case 0:
        if (upperData[P_filterPoleSW] == 1) {
          if (announce) {
            showCurrentParameterPage("Filter Type", String("3P LowPass"));
          }
        } else {
          if (announce) {
            showCurrentParameterPage("Filter Type", String("4P LowPass"));
          }
        }
        midiCCOut72(CCfilterType, 0);
        midiCCOut(CCfilterType, 0);
        srp.writePin(FILTERA_UPPER, LOW);
        srp.writePin(FILTERB_UPPER, LOW);
        srp.writePin(FILTERC_UPPER, LOW);
        break;

      case 1:
        if (upperData[P_filterPoleSW] == 1) {
          if (announce) {
            showCurrentParameterPage("Filter Type", String("1P LowPass"));
          }
        } else {
          if (announce) {
            showCurrentParameterPage("Filter Type", String("2P LowPass"));
          }
        }
        midiCCOut72(CCfilterType, 1);
        midiCCOut(CCfilterType, 1);
        srp.writePin(FILTERA_UPPER, HIGH);
        srp.writePin(FILTERB_UPPER, LOW);
        srp.writePin(FILTERC_UPPER, LOW);
        break;

      case 2:
        if (upperData[P_filterPoleSW] == 1) {
          if (announce) {
            showCurrentParameterPage("Filter Type", String("3P HP + 1P LP"));
          }
        } else {
          if (announce) {
            showCurrentParameterPage("Filter Type", String("4P HighPass"));
          }
        }
        midiCCOut72(CCfilterType, 2);
        midiCCOut(CCfilterType, 2);
        srp.writePin(FILTERA_UPPER, LOW);
        srp.writePin(FILTERB_UPPER, HIGH);
        srp.writePin(FILTERC_UPPER, LOW);
        break;

      case 3:
        if (upperData[P_filterPoleSW] == 1) {
          if (announce) {
            showCurrentParameterPage("Filter Type", String("1P HP + 1P LP"));
          }
        } else {
          if (announce) {
            showCurrentParameterPage("Filter Type", String("2P HighPass"));
          }
        }
        midiCCOut72(CCfilterType, 3);
        midiCCOut(CCfilterType, 3);
        srp.writePin(FILTERA_UPPER, HIGH);
        srp.writePin(FILTERB_UPPER, HIGH);
        srp.writePin(FILTERC_UPPER, LOW);
        break;

      case 4:
        if (upperData[P_filterPoleSW] == 1) {
          if (announce) {
            showCurrentParameterPage("Filter Type", String("2P HP + 1P LP"));
          }
        } else {
          if (announce) {
            showCurrentParameterPage("Filter Type", String("4P BandPass"));
          }
        }
        midiCCOut72(CCfilterType, 4);
        midiCCOut(CCfilterType, 4);
        srp.writePin(FILTERA_UPPER, LOW);
        srp.writePin(FILTERB_UPPER, LOW);
        srp.writePin(FILTERC_UPPER, HIGH);
        break;

      case 5:
        if (upperData[P_filterPoleSW] == 1) {
          if (announce) {
            showCurrentParameterPage("Filter Type", String("2P BP + 1P LP"));
          }
        } else {
          if (announce) {
            showCurrentParameterPage("Filter Type", String("2P BandPass"));
          }
        }
        midiCCOut72(CCfilterType, 5);
        midiCCOut(CCfilterType, 5);
        srp.writePin(FILTERA_UPPER, HIGH);
        srp.writePin(FILTERB_UPPER, LOW);
        srp.writePin(FILTERC_UPPER, HIGH);
        break;

      case 6:
        if (upperData[P_filterPoleSW] == 1) {
          if (announce) {
            showCurrentParameterPage("Filter Type", String("3P AP + 1P LP"));
          }
        } else {
          if (announce) {
            showCurrentParameterPage("Filter Type", String("3P AllPass"));
          }
        }
        midiCCOut72(CCfilterType, 6);
        midiCCOut(CCfilterType, 6);
        srp.writePin(FILTERA_UPPER, LOW);
        srp.writePin(FILTERB_UPPER, HIGH);
        srp.writePin(FILTERC_UPPER, HIGH);
        break;

      case 7:
        if (upperData[P_filterPoleSW] == 1) {
          if (announce) {
            showCurrentParameterPage("Filter Type", String("2P Notch + LP"));
          }
        } else {
          if (announce) {
            showCurrentParameterPage("Filter Type", String("Notch"));
          }
        }
        midiCCOut72(CCfilterType, 7);
        midiCCOut(CCfilterType, 7);
        srp.writePin(FILTERA_UPPER, HIGH);
        srp.writePin(FILTERB_UPPER, HIGH);
        srp.writePin(FILTERC_UPPER, HIGH);
        break;
    }
  } else {
    switch (lowerData[P_filterType]) {
      case 0:
        if (lowerData[P_filterPoleSW] == 1) {
          if (announce) {
            showCurrentParameterPage("Filter Type", String("3P LowPass"));
          }
        } else {
          if (announce) {
            showCurrentParameterPage("Filter Type", String("4P LowPass"));
          }
        }
        midiCCOut72(CCfilterType, 0);
        midiCCOut(CCfilterType, 0);
        srp.writePin(FILTERA_LOWER, LOW);
        srp.writePin(FILTERB_LOWER, LOW);
        srp.writePin(FILTERC_LOWER, LOW);
        if (wholemode) {
          srp.writePin(FILTERA_UPPER, LOW);
          srp.writePin(FILTERB_UPPER, LOW);
          srp.writePin(FILTERC_UPPER, LOW);
        }
        break;

      case 1:
        if (lowerData[P_filterPoleSW] == 1) {
          if (announce) {
            showCurrentParameterPage("Filter Type", String("1P LowPass"));
          }
        } else {
          if (announce) {
            showCurrentParameterPage("Filter Type", String("2P LowPass"));
          }
        }
        midiCCOut72(CCfilterType, 1);
        midiCCOut(CCfilterType, 1);
        srp.writePin(FILTERA_LOWER, HIGH);
        srp.writePin(FILTERB_LOWER, LOW);
        srp.writePin(FILTERC_LOWER, LOW);
        if (wholemode) {
          srp.writePin(FILTERA_UPPER, HIGH);
          srp.writePin(FILTERB_UPPER, LOW);
          srp.writePin(FILTERC_UPPER, LOW);
        }
        break;

      case 2:
        if (lowerData[P_filterPoleSW] == 1) {
          if (announce) {
            showCurrentParameterPage("Filter Type", String("3P HP + 1P LP"));
          }
        } else {
          if (announce) {
            showCurrentParameterPage("Filter Type", String("4P HighPass"));
          }
        }
        midiCCOut72(CCfilterType, 2);
        midiCCOut(CCfilterType, 2);
        srp.writePin(FILTERA_LOWER, LOW);
        srp.writePin(FILTERB_LOWER, HIGH);
        srp.writePin(FILTERC_LOWER, LOW);
        if (wholemode) {
          srp.writePin(FILTERA_UPPER, LOW);
          srp.writePin(FILTERB_UPPER, HIGH);
          srp.writePin(FILTERC_UPPER, LOW);
        }
        break;

      case 3:
        if (lowerData[P_filterPoleSW] == 1) {
          if (announce) {
            showCurrentParameterPage("Filter Type", String("1P HP + 1P LP"));
          }
        } else {
          if (announce) {
            showCurrentParameterPage("Filter Type", String("2P HighPass"));
          }
        }
        midiCCOut72(CCfilterType, 3);
        midiCCOut(CCfilterType, 3);
        srp.writePin(FILTERA_LOWER, HIGH);
        srp.writePin(FILTERB_LOWER, HIGH);
        srp.writePin(FILTERC_LOWER, LOW);
        if (wholemode) {
          srp.writePin(FILTERA_UPPER, HIGH);
          srp.writePin(FILTERB_UPPER, HIGH);
          srp.writePin(FILTERC_UPPER, LOW);
        }
        break;

      case 4:
        if (lowerData[P_filterPoleSW] == 1) {
          if (announce) {
            showCurrentParameterPage("Filter Type", String("2P HP + 1P LP"));
          }
        } else {
          if (announce) {
            showCurrentParameterPage("Filter Type", String("4P BandPass"));
          }
        }
        midiCCOut72(CCfilterType, 4);
        midiCCOut(CCfilterType, 4);
        srp.writePin(FILTERA_LOWER, LOW);
        srp.writePin(FILTERB_LOWER, LOW);
        srp.writePin(FILTERC_LOWER, HIGH);
        if (wholemode) {
          srp.writePin(FILTERA_UPPER, LOW);
          srp.writePin(FILTERB_UPPER, LOW);
          srp.writePin(FILTERC_UPPER, HIGH);
        }
        break;

      case 5:
        if (lowerData[P_filterPoleSW] == 1) {
          if (announce) {
            showCurrentParameterPage("Filter Type", String("2P BP + 1P LP"));
          }
        } else {
          if (announce) {
            showCurrentParameterPage("Filter Type", String("2P BandPass"));
          }
        }
        midiCCOut72(CCfilterType, 5);
        midiCCOut(CCfilterType, 5);
        srp.writePin(FILTERA_LOWER, HIGH);
        srp.writePin(FILTERB_LOWER, LOW);
        srp.writePin(FILTERC_LOWER, HIGH);
        if (wholemode) {
          srp.writePin(FILTERA_UPPER, HIGH);
          srp.writePin(FILTERB_UPPER, LOW);
          srp.writePin(FILTERC_UPPER, HIGH);
        }
        break;


      case 6:
        if (lowerData[P_filterPoleSW] == 1) {
          if (announce) {
            showCurrentParameterPage("Filter Type", String("3P AP + 1P LP"));
          }
        } else {
          if (announce) {
            showCurrentParameterPage("Filter Type", String("3P AllPass"));
          }
        }
        midiCCOut72(CCfilterType, 6);
        midiCCOut(CCfilterType, 6);
        srp.writePin(FILTERA_LOWER, LOW);
        srp.writePin(FILTERB_LOWER, HIGH);
        srp.writePin(FILTERC_LOWER, HIGH);
        if (wholemode) {
          srp.writePin(FILTERA_UPPER, LOW);
          srp.writePin(FILTERB_UPPER, HIGH);
          srp.writePin(FILTERC_UPPER, HIGH);
        }
        break;

      case 7:
        if (lowerData[P_filterPoleSW] == 1) {
          if (announce) {
            showCurrentParameterPage("Filter Type", String("2P Notch + LP"));
          }
        } else {
          if (announce) {
            showCurrentParameterPage("Filter Type", String("Notch"));
          }
        }
        midiCCOut72(CCfilterType, 7);
        midiCCOut(CCfilterType, 7);
        srp.writePin(FILTERA_LOWER, HIGH);
        srp.writePin(FILTERB_LOWER, HIGH);
        srp.writePin(FILTERC_LOWER, HIGH);
        if (wholemode) {
          srp.writePin(FILTERA_UPPER, HIGH);
          srp.writePin(FILTERB_UPPER, HIGH);
          srp.writePin(FILTERC_UPPER, HIGH);
        }
        break;
    }
  }
}

void updatefilterEGlevel(boolean announce) {
  if (announce) {
    showCurrentParameterPage("EG Depth", int(filterEGlevelstr));
  }
  if (upperSW) {
    midiCCOut(CCfilterEGlevel, upperData[P_filterEGlevel]);
    midiCCOut71(CCfilterEGlevel, upperData[P_filterEGlevel]);
  } else {
    midiCCOut(CCfilterEGlevel, lowerData[P_filterEGlevel]);
    midiCCOut71(CCfilterEGlevel, lowerData[P_filterEGlevel]);
  }
}

void updatekeytrack(boolean announce) {
  if (announce) {
    showCurrentParameterPage("Keytrack", int(keytrackstr));
  }
  if (upperSW) {
    midiCCOut62(WSkeytrack, upperData[P_keytrack]);
    midiCCOut(CCkeyTrack, upperData[P_keytrack]);
    midiCCOut71(CCkeyTrack, upperData[P_keytrack]);
  } else {
    midiCCOut61(WSkeytrack, lowerData[P_keytrack]);
    midiCCOut(CCkeyTrack, lowerData[P_keytrack]);
    midiCCOut71(CCkeyTrack, lowerData[P_keytrack]);
    if (wholemode) {
      midiCCOut62(WSkeytrack, upperData[P_keytrack]);
    }
  }
}

void updateLFORate(boolean announce) {

  if (announce) {
    showCurrentParameterPage("LFO Rate", String(LFORatestr) + " Hz");
  }
  if (upperSW) {
    midiCCOut(CCLFORate, upperData[P_LFORate]);
    midiCCOut71(CCLFORate, upperData[P_LFORate]);
  } else {
    midiCCOut(CCLFORate, lowerData[P_LFORate]);
    midiCCOut71(CCLFORate, lowerData[P_LFORate]);
  }
}

void updateLFODelay(boolean announce) {
  if (announce) {
    showCurrentParameterPage("LFO Delay", String(LFODelaystr));
  }
  if (upperSW) {
    midiCCOut(CCLFODelay, upperData[P_LFODelay]);
    midiCCOut71(CCLFODelay, upperData[P_LFODelay]);
  } else {
    midiCCOut(CCLFODelay, lowerData[P_LFODelay]);
    midiCCOut71(CCLFODelay, lowerData[P_LFODelay]);
  }
}

void updatemodWheelDepth(boolean announce) {
  if (announce) {
    showCurrentParameterPage("Mod Wheel Depth", String(modWheelDepthstr));
  }
  if (upperSW) {
    midiCCOut62(WSmodDepth, upperData[P_modWheelDepth]);
    midiCCOut(CCmodWheelDepth, upperData[P_modWheelDepth]);
    midiCCOut71(CCmodWheelDepth, upperData[P_modWheelDepth]);
  } else {
    midiCCOut61(WSmodDepth, lowerData[P_modWheelDepth]);
    midiCCOut(CCmodWheelDepth, lowerData[P_modWheelDepth]);
    midiCCOut71(CCmodWheelDepth, lowerData[P_modWheelDepth]);
    if (wholemode) {
      midiCCOut62(WSmodDepth, upperData[P_modWheelDepth]);
    }
  }
}

void updatePitchBendDepth(boolean announce) {
  if (announce) {
    showCurrentParameterPage("Pitch Bend Depth", String(PitchBendLevelstr));
  }
  if (upperSW) {
    midiCCOut62(WSbendRange, upperData[P_PitchBendLevel]);
    midiCCOut71(CCPitchBend, upperData[P_PitchBendLevel]);
  } else {
    midiCCOut61(WSbendRange, lowerData[P_PitchBendLevel]);
    midiCCOut71(CCPitchBend, lowerData[P_PitchBendLevel]);
    if (wholemode) {
      midiCCOut62(WSbendRange, upperData[P_PitchBendLevel]);
    }
  }
}

void updateeffectPot1(boolean announce) {
  if (announce) {
    showCurrentParameterPage("Effect Pot 1", String(effectPot1str));
  }
  if (upperSW) {
    midiCCOut(CCeffectPot1, upperData[P_effectPot1]);
    midiCCOut71(CCeffectPot1, upperData[P_effectPot1]);
  } else {
    midiCCOut(CCeffectPot1, lowerData[P_effectPot1]);
    midiCCOut71(CCeffectPot1, lowerData[P_effectPot1]);
  }
}

void updateeffectPot2(boolean announce) {
  if (announce) {
    showCurrentParameterPage("Effect Pot 2", String(effectPot2str));
  }
  if (upperSW) {
    midiCCOut(CCeffectPot2, upperData[P_effectPot2]);
    midiCCOut71(CCeffectPot2, upperData[P_effectPot2]);
  } else {
    midiCCOut(CCeffectPot2, lowerData[P_effectPot2]);
    midiCCOut71(CCeffectPot2, lowerData[P_effectPot2]);
  }
}

void updateeffectPot3(boolean announce) {
  if (announce) {
    showCurrentParameterPage("Effect Pot 3", String(effectPot3str));
  }
  if (upperSW) {
    midiCCOut(CCeffectPot3, upperData[P_effectPot3]);
    midiCCOut71(CCeffectPot3, upperData[P_effectPot3]);
  } else {
    midiCCOut(CCeffectPot3, lowerData[P_effectPot3]);
    midiCCOut71(CCeffectPot3, lowerData[P_effectPot3]);
  }
}

void updateeffectsMix(boolean announce) {
  if (announce) {
    showCurrentParameterPage("Effects Mix", String(effectsMixstr));
  }
  if (upperSW) {
    midiCCOut(CCeffectsMix, upperData[P_effectsMix]);
    midiCCOut71(CCeffectsMix, upperData[P_effectsMix]);
  } else {
    midiCCOut(CCeffectsMix, lowerData[P_effectsMix]);
    midiCCOut71(CCeffectsMix, lowerData[P_effectsMix]);
  }
}

void updateStratusLFOWaveform(boolean announce) {

  if (upperSW) {
    panelData[P_LFOWaveform] = upperData[P_LFOWaveform];
    panelData[P_lfoAlt] = upperData[P_lfoAlt];
  } else {
    panelData[P_LFOWaveform] = lowerData[P_LFOWaveform];
    panelData[P_lfoAlt] = lowerData[P_lfoAlt];
  }

  if (panelData[P_lfoAlt]) {
    switch (panelData[P_LFOWaveform]) {
      case 0:
        StratusLFOWaveform = "Sawtooth Up";
        LFOWaveCV = 1;
        midiCCOut72(CCLFOWaveform, 0);
        break;

      case 1:
        StratusLFOWaveform = "Sawtooth Down";
        LFOWaveCV = 20;
        midiCCOut72(CCLFOWaveform, 1);
        break;

      case 2:
        StratusLFOWaveform = "Squarewave";
        LFOWaveCV = 35;
        midiCCOut72(CCLFOWaveform, 2);
        break;

      case 3:
        StratusLFOWaveform = "Triangle";
        LFOWaveCV = 50;
        midiCCOut72(CCLFOWaveform, 3);
        break;

      case 4:
        StratusLFOWaveform = "Sinewave";
        LFOWaveCV = 74;
        midiCCOut72(CCLFOWaveform, 4);
        break;

      case 5:
        StratusLFOWaveform = "Sweeps";
        LFOWaveCV = 90;
        midiCCOut72(CCLFOWaveform, 5);
        break;

      case 6:
        StratusLFOWaveform = "Lumps";
        LFOWaveCV = 107;
        midiCCOut72(CCLFOWaveform, 6);
        break;

      case 7:
        StratusLFOWaveform = "Sample & Hold";
        LFOWaveCV = 122;
        midiCCOut72(CCLFOWaveform, 7);
        break;
    }
  } else {
    switch (panelData[P_LFOWaveform]) {
      case 0:
        StratusLFOWaveform = "Saw +Oct";
        LFOWaveCV = 1;
        midiCCOut72(CCLFOWaveform, 0);
        break;

      case 1:
        StratusLFOWaveform = "Quad Saw";
        LFOWaveCV = 20;
        midiCCOut72(CCLFOWaveform, 1);
        break;

      case 2:
        StratusLFOWaveform = "Quad Pulse";
        LFOWaveCV = 35;
        midiCCOut72(CCLFOWaveform, 2);
        break;

      case 3:
        StratusLFOWaveform = "Tri Step";
        LFOWaveCV = 50;
        midiCCOut72(CCLFOWaveform, 3);
        break;

      case 4:
        StratusLFOWaveform = "Sine +Oct";
        LFOWaveCV = 74;
        midiCCOut72(CCLFOWaveform, 4);
        break;

      case 5:
        StratusLFOWaveform = "Sine +3rd";
        LFOWaveCV = 90;
        midiCCOut72(CCLFOWaveform, 5);
        break;

      case 6:
        StratusLFOWaveform = "Sine +4th";
        LFOWaveCV = 107;
        midiCCOut72(CCLFOWaveform, 6);
        break;

      case 7:
        StratusLFOWaveform = "Rand Slopes";
        LFOWaveCV = 122;
        midiCCOut72(CCLFOWaveform, 7);
        break;
    }
  }
  if (announce) {
    showCurrentParameterPage("LFO Wave", StratusLFOWaveform);
  }
  if (upperSW) {
    LFOWaveCVupper = LFOWaveCV;
  } else {
    LFOWaveCVlower = LFOWaveCV;
    if (wholemode) {
      LFOWaveCVupper = LFOWaveCV;
    }
  }
}

void updatefilterAttack(boolean announce) {
  if (announce) {
    if (filterAttackstr < 1000) {
      showCurrentParameterPage("VCF Attack", String(int(filterAttackstr)) + " ms", FILTER_ENV);
    } else {
      showCurrentParameterPage("VCF Attack", String(filterAttackstr * 0.001) + " s", FILTER_ENV);
    }
  }
  if (upperSW) {
    midiCCOut(CCfilterAttack, upperData[P_filterAttack]);
    midiCCOut71(CCfilterAttack, upperData[P_filterAttack]);
  } else {
    midiCCOut(CCfilterAttack, lowerData[P_filterAttack]);
    midiCCOut71(CCfilterAttack, lowerData[P_filterAttack]);
  }
}

void updatefilterDecay(boolean announce) {
  if (announce) {
    if (filterDecaystr < 1000) {
      showCurrentParameterPage("VCF Decay", String(int(filterDecaystr)) + " ms", FILTER_ENV);
    } else {
      showCurrentParameterPage("VCF Decay", String(filterDecaystr * 0.001) + " s", FILTER_ENV);
    }
  }
  if (upperSW) {
    midiCCOut(CCfilterDecay, upperData[P_filterDecay]);
    midiCCOut71(CCfilterDecay, upperData[P_filterDecay]);
  } else {
    midiCCOut(CCfilterDecay, lowerData[P_filterDecay]);
    midiCCOut71(CCfilterDecay, lowerData[P_filterDecay]);
  }
}

void updatefilterSustain(boolean announce) {
  if (announce) {
    showCurrentParameterPage("VCF Sustain", String(filterSustainstr), FILTER_ENV);
  }
  if (upperSW) {
    midiCCOut(CCfilterSustain, upperData[P_filterSustain]);
    midiCCOut71(CCfilterSustain, upperData[P_filterSustain]);
  } else {
    midiCCOut(CCfilterSustain, lowerData[P_filterSustain]);
    midiCCOut71(CCfilterSustain, lowerData[P_filterSustain]);
  }
}

void updatefilterRelease(boolean announce) {
  if (announce) {
    if (filterReleasestr < 1000) {
      showCurrentParameterPage("VCF Release", String(int(filterReleasestr)) + " ms", FILTER_ENV);
    } else {
      showCurrentParameterPage("VCF Release", String(filterReleasestr * 0.001) + " s", FILTER_ENV);
    }
  }
  if (upperSW) {
    midiCCOut(CCfilterRelease, upperData[P_filterRelease]);
    midiCCOut71(CCfilterRelease, upperData[P_filterRelease]);
  } else {
    midiCCOut(CCfilterRelease, lowerData[P_filterRelease]);
    midiCCOut71(CCfilterRelease, lowerData[P_filterRelease]);
  }
}

void updateampAttack(boolean announce) {
  if (announce) {
    if (ampAttackstr < 1000) {
      showCurrentParameterPage("VCA Attack", String(int(ampAttackstr)) + " ms", AMP_ENV);
    } else {
      showCurrentParameterPage("VCA Attack", String(ampAttackstr * 0.001) + " s", AMP_ENV);
    }
  }
  if (upperSW) {
    midiCCOut(CCampAttack, upperData[P_ampAttack]);
    midiCCOut71(CCampAttack, upperData[P_ampAttack]);
    upperData[P_oldampAttack] = upperData[P_ampAttack];
  } else {
    midiCCOut(CCampAttack, lowerData[P_ampAttack]);
    midiCCOut71(CCampAttack, lowerData[P_ampAttack]);
    lowerData[P_oldampAttack] = lowerData[P_ampAttack];
    if (wholemode) {
      upperData[P_oldampAttack] = lowerData[P_oldampAttack];
    }
  }
}

void updateampDecay(boolean announce) {
  if (announce) {
    if (ampDecaystr < 1000) {
      showCurrentParameterPage("VCA Decay", String(int(ampDecaystr)) + " ms", AMP_ENV);
    } else {
      showCurrentParameterPage("VCA Decay", String(ampDecaystr * 0.001) + " s", AMP_ENV);
    }
  }
  if (upperSW) {
    midiCCOut(CCampDecay, upperData[P_ampDecay]);
    midiCCOut71(CCampDecay, upperData[P_ampDecay]);
    upperData[P_oldampDecay] = upperData[P_ampDecay];
  } else {
    midiCCOut(CCampDecay, lowerData[P_ampDecay]);
    midiCCOut71(CCampDecay, lowerData[P_ampDecay]);
    lowerData[P_oldampDecay] = lowerData[P_ampDecay];
    if (wholemode) {
      upperData[P_oldampDecay] = lowerData[P_oldampDecay];
    }
  }
}

void updateampSustain(boolean announce) {
  if (announce) {
    showCurrentParameterPage("VCA Sustain", String(ampSustainstr), AMP_ENV);
  }
  if (upperSW) {
    midiCCOut(CCampSustain, upperData[P_ampSustain]);
    midiCCOut71(CCampSustain, upperData[P_ampSustain]);
    upperData[P_oldampSustain] = upperData[P_ampSustain];
  } else {
    midiCCOut(CCampSustain, lowerData[P_ampSustain]);
    midiCCOut71(CCampSustain, lowerData[P_ampSustain]);
    lowerData[P_oldampSustain] = lowerData[P_ampSustain];
    if (wholemode) {
      upperData[P_oldampSustain] = lowerData[P_oldampSustain];
    }
  }
}

void updateampRelease(boolean announce) {
  if (announce) {
    if (ampReleasestr < 1000) {
      showCurrentParameterPage("VCA Release", String(int(ampReleasestr)) + " ms", AMP_ENV);
    } else {
      showCurrentParameterPage("VCA Release", String(ampReleasestr * 0.001) + " s", AMP_ENV);
    }
  }
  if (upperSW) {
    midiCCOut(CCampRelease, upperData[P_ampRelease]);
    midiCCOut71(CCampRelease, upperData[P_ampRelease]);
    upperData[P_oldampRelease] = upperData[P_ampRelease];
  } else {
    midiCCOut(CCampRelease, lowerData[P_ampRelease]);
    midiCCOut71(CCampRelease, lowerData[P_ampRelease]);
    lowerData[P_oldampRelease] = lowerData[P_ampRelease];
    if (wholemode) {
      upperData[P_oldampRelease] = lowerData[P_oldampRelease];
    }
  }
}

void updatevolumeControl(boolean announce) {
  if (announce) {
    showCurrentParameterPage("Volume", int(volumeControlstr));
  }
  if (upperSW) {
    midiCCOut(CCvolumeControl, upperData[P_volumeControl]);
    midiCCOut71(CCvolumeControl, upperData[P_volumeControl]);
  } else {
    midiCCOut(CCvolumeControl, lowerData[P_volumeControl]);
    midiCCOut71(CCvolumeControl, lowerData[P_volumeControl]);
  }
}

void updatePM_DCO2(boolean announce) {
  if (announce) {
    showCurrentParameterPage("PolyMod DCO2", int(pmDCO2str));
  }
  if (upperSW) {
    midiCCOut(CCPM_DCO2, upperData[P_pmDCO2]);
    midiCCOut71(CCPM_DCO2, upperData[P_pmDCO2]);
  } else {
    midiCCOut(CCPM_DCO2, lowerData[P_pmDCO2]);
    midiCCOut71(CCPM_DCO2, lowerData[P_pmDCO2]);
  }
}

void updatePM_FilterEnv(boolean announce) {
  if (announce) {
    showCurrentParameterPage("PolyMod Filter Env", int(pmFilterEnvstr));
  }
  if (upperSW) {
    midiCCOut(CCPM_FilterEnv, upperData[P_pmFilterEnv]);
    midiCCOut71(CCPM_FilterEnv, upperData[P_pmFilterEnv]);
  } else {
    midiCCOut(CCPM_FilterEnv, lowerData[P_pmFilterEnv]);
    midiCCOut71(CCPM_FilterEnv, lowerData[P_pmFilterEnv]);
  }
}

// ////////////////////////////////////////////////////////////////

void updatechordHoldSW(boolean announce) {
  if (upperSW) {
    if (chordHoldU == 0) {
      if (announce) {
        showCurrentParameterPage("Chord Hold", "Off");
      }
      midiCCOut(CCchordHoldSW, 0);
      midiCCOut72(CCchordHoldSW, 0);
      onHoldButtonReleased();
    } else {
      if (announce) {
        showCurrentParameterPage("Chord Hold", "On");
      }
      midiCCOut(CCchordHoldSW, 127);
      midiCCOut72(CCchordHoldSW, 127);
      onHoldButtonPressed();
    }
  } else {
    if (chordHoldL == 0) {
      if (announce) {
        showCurrentParameterPage("Chord Hold", "Off");
      }
      midiCCOut(CCchordHoldSW, 0);
      midiCCOut72(CCchordHoldSW, 0);
      onHoldButtonReleased();
    } else {
      if (announce) {
        showCurrentParameterPage("Chord Hold", "On");
      }
      midiCCOut(CCchordHoldSW, 127);
      midiCCOut72(CCchordHoldSW, 127);
      onHoldButtonPressed();
    }
  }
}


void updateplayMode(boolean announce) {
  if (playMode == 0) {
    if (announce) {
      showCurrentParameterPage("Key Mode", "Whole");
    }
    midiCCOut72(CCplayMode, 0);
    midiCCOut(CCplayMode, 0);
    srp.writePin(UPPER_RELAY_2, HIGH);
    srp.writePin(UPPER_RELAY_3, HIGH);
    wholemode = true;
    dualmode = false;
    splitmode = false;
    lowerSW = true;
    upperSW = false;
    updatelowerSW(0);
    lowerParamsToDisplay();
    setAllButtons();

  } else if (playMode == 1) {
    if (announce) {
      showCurrentParameterPage("Key Mode", "Dual");
    }
    midiCCOut72(CCplayMode, 1);
    midiCCOut(CCplayMode, 1);
    srp.writePin(UPPER_RELAY_2, LOW);
    srp.writePin(UPPER_RELAY_3, LOW);
    wholemode = false;
    dualmode = true;
    splitmode = false;
  } else if (playMode == 2) {
    if (announce) {
      showCurrentParameterPage("Key Mode", "Split");
    }
    midiCCOut72(CCplayMode, 2);
    midiCCOut(CCplayMode, 2);
    srp.writePin(UPPER_RELAY_2, LOW);
    srp.writePin(UPPER_RELAY_3, LOW);
    wholemode = false;
    dualmode = false;
    splitmode = true;
  }
}
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
void loop() {

  if (digitalRead(AUTOTUNE_INPUT) == HIGH) {
    isAutotuning = true;
    digitalWrite(TUNE_LED, HIGH);

    while (digitalRead(AUTOTUNE_INPUT) == HIGH) {
      while (midi1.read()) {}
      while (MIDI.read()) {}
      while (MIDI6.read()) {}
      while (MIDI7.read()) {}
      while (usbMIDI.read()) {}
      writeDemux();
      delay(1);
    }

    digitalWrite(TUNE_LED, LOW);
    isAutotuning = false;

    while (midi1.read()) {}
    while (MIDI.read()) {}
    while (MIDI6.read()) {}
    while (MIDI7.read()) {}
    while (usbMIDI.read()) {}

    allNotesOff();
  } else {

    checkSwitches();
    writeDemux();
    pollAllMCPs();
    checkEncoder();
    midi1.read(midiChannel);  //USB HOST MIDI Class Compliant
    MIDI.read(midiChannel);
    MIDI6.read(midiChannel);
    MIDI7.read();
    usbMIDI.read(midiChannel);
    octoswitch.update();  // read all the buttons for the Synth
    srp.update();         // update all the LEDs in the buttons
    LFODelayHandle();
    changeSpeed();
    checkChordHold();
  }
}
