craigyjp/A_Bit_More/Displays/Display6/MidiCC.h

//MIDI CC control numbers
//These broadly follow standard CC assignments
#define   CCmodwheel  1 //pitch LFO amount - less from mod wheel
#define   CCLfoDepth  3 //pitch LFO amount - panel control

#define   CCglideTime 5

#define   CCvolumeControl 7
#define   CCfilterA 8
#define   CCfilterB 9
#define   CCfilterC 10
#define   CCamDepth 11
#define   CCosc2Interval 12

#define   CCoscATDepth 14
#define   CCoscfmDepth 15
#define   CCosc1PW 16
#define   CCosc2PW 17
#define   CCosc1PWM 18
#define   CCosc2PWM 19
#define   CCmodWheelDepth 20
#define   CCvcaGate 21
#define   CCfilterLFO 22
#define   CCnoiseLevel 23
#define   CCfilterPoleSW 24
#define   CCPM_FilterEnv 25
#define   CCPM_DCO2 26
#define   CCFilterLoop 27
#define   CCAmpLoop 28

#define   CCKeyTrack 30
#define   CCKeyTrackSW 31
#define   CCwholemode 32
#define   CCdualmode 33
#define   CCsplitmode 34
#define   CCeffectNumSW 35
#define   CCeffectBankSW 36
#define   CCmonoMulti 37
#define   CCpmDestDCO1SW 38
#define   CCfilterType 39
#define   CCpmDestFilterSW 40

#define   CCvcaVel 42
#define   CCfilterVel 43
#define   CCfilterRelease 44
#define   CCfilterAttack 45
#define   CCfilterSustain 46
#define   CCfilterDecay 47
#define   CCfilterLevel 48

#define   CCfilterEGinv 50

#define   CCfilterEGlevel 53
#define   CCkeyboardMode 54
#define   CCNotePriority 55

#define   CCampRelease 57
#define   CCampAttack 58
#define   CCampSustain 59
#define   CCampDecay 60
#define   CCosc2triangleLevel 61
#define   CCosc1SubLevel 62
#define   CCLFODelay 63

#define   CCglideSW 65
#define   CCPitchBend 66
#define   CCMWDepth 67
#define   CCosc1PulseLevel 68
#define   CCosc1SawLevel 69

#define   CCosc2Detune 71

#define   CCfilterCutoff 74

#define   CClfoAlt 76
#define   CCLFORate 77
#define   CClfoMult 78

#define   CCosc1Oct 80
#define   CCosc2Oct 81

#define   CCeffect1 83
#define   CCeffect2 84
#define   CCeffect3 85
#define   CCeffectMix 86
#define   CCpwLFO 87
#define   CCfilterenvLinLogSW 88
#define   CCampenvLinLogSW 89
#define   CCplayMode 90
#define   CCLFOWaveform 91
#define   CCdumpCompleteSW 92
#define   CCdumpStartedSW 93
#define   CCfilterRes 94
#define   CCsyncSW 95
#define   CCchordHoldSW 96
#define   CCupperSW 97
#define   CClowerSW 98
#define   CCpwLFOwaveformSW 99

#define   CCosc2pulseLevel 102
#define   CCosc2sawLevel 103

#define   CCallnotesoff 123//Panic button
