craigyjp/A_Bit_More/Displays/Display8/Constants.h

#define NO_OF_PARAMS 150
const char* INITPATCHNAME = "Initial Patch";
#define HOLD_DURATION 1000
const uint32_t CLICK_DURATION = 250;
#define PATCHES_LIMIT 999
const String INITPATCH = "CC Mode,1,1,1,1,1,1,1,1,1,1,1,1,1,1,1,1,1,1,1,1,1,1,1,1,1,1,1,1,1,1,1,1,1,1,1,1,1,1,1,1,1,1,1,1,1,1,1,1,1,1,1,1,1,1,1,1,1,1,1,1,1,1,1,1,1,1,1,1,1,1,1,1,1,1,1,1,1,1,1,1,1,1,1,1,1,1,1,1,1,1,1,1,1,1,1,1,1,1,1,1,1,1,1,1,1,1,1,1,1,1,1,1,1,1,1,1,1,1,1";
const char* str_ptr = nullptr;
