craigyjp/A_Bit_More/(commit log)

2024-08-09 Moved buttons from display to this board
2024-08-13 Patch to display over i2c
2024-08-13 Fixed more buttons and increased i2c buffer size to 255 bytes
    [A_Bit_More.ino, MidiCC.h, Parameters.h]
2024-08-14 Added all pots and buttons
2025-02-11 Fixed up the main menus for 320x240 screen
    [A_Bit_More.ino, ST7735Display.h]
2025-03-18 Added schematics
2025-03-19 Fixed a lot of bugs
    [A_Bit_More.ino, Constants.h, HWControls.h, MidiCC.h]
2025-03-19 Fixed octave switching
2025-03-20 Fixed effects bank selection
    [A_Bit_More.ino]
2025-03-21 Fixed delayed LFO time to 10s
    [A_Bit_More.ino]
2025-03-25 Fixed upper / lower switching
    [A_Bit_More.ino, HWControls.h, MidiCC.h, Parameters.h]
2025-03-25 Fixed LFO LED selections
    [A_Bit_More.ino]
2025-03-25 Fixed aftertouch to DCO
    [A_Bit_More.ino]
2025-04-02 Fixed patch saving and renaming
    [A_Bit_More.ino]
2025-04-02 Fixed recall keyboardmode in whole mode
    [A_Bit_More.ino]
2025-04-02 Fixed note hang is played during autotune
    [A_Bit_More.ino, Parameters.h]
2025-04-07 Added display schematics
2025-04-08 Fixed keyboard split settings
    [A_Bit_More.ino]
2025-04-08 Fixed bug leaving split mode
    [A_Bit_More.ino]
2025-04-12 Fixed the the cross fade volume of the effects mix
    [A_Bit_More.ino, HWControls.h, Parameters.h]
2025-06-19 Switched to encoders for controls
2025-06-19 Fixed encoder acceleration option
    [A_Bit_More.ino, Parameters.h]
2025-06-20 Added encoder toggles
2025-06-21 Fixed a few bugs
    [HWControls.h]
2025-06-22 Tweaked the sample and hold output voltages a little
2025-06-22 new photo with encoders
2025-06-24 Swapped to encoders
2026-08-05 Fixed the display updates and changed the notes off to use myNoteOff properly
    [A_Bit_More.ino, Constants.h, HWControls.h, Parameters.h, ST7735Display.h]
